ICRS/IPRL-Electronics-Hardware/PCBs/Power_V2_secondary/Power_V2_secondary.step

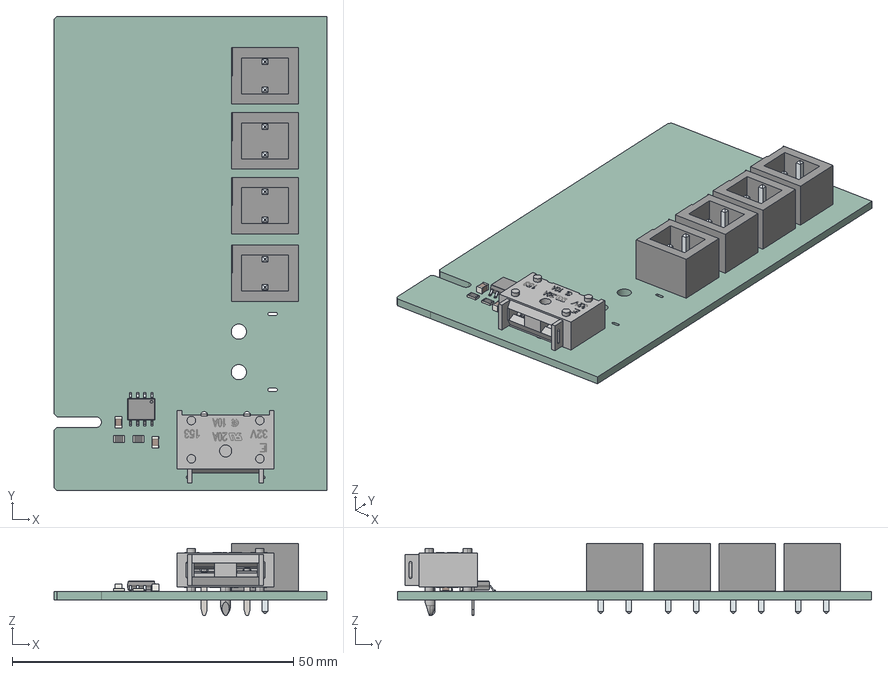
[picture p1: CAD file, 2025-04-23]
PCBs/Power_V2_secondary/Power_V2_secondary.step
48.5 x 84.3 x 12.9 mm
R_0805_2012Metric x 2
01530007Z
PinsArrayLR
LeadsArray x 4
C_0805_2012Metric x 2
Power_V2_secondary_PCB
