ICRS/IPRL-Electronics-Hardware/PCBs/Power_PCB/Power_PCB/TODO.md

- [ ] Connectors
    - Drill
        - XT30 5V in (male)
        + Put in a screw terminal
    - Arm
        - XT30 5V in (male)
        - XT60 12V in (male)
        + Put in one screw terminals
    - Comms
        - Screw terminals (x2)
    - Drive
        - XT60 12V in (female)
        - XT30 5V in (female)
        + screw terminal
- [ ] Emergency stop
- [x] ADC with potential divider
- [x] ESP32
- [ ] Over current
- [ ] Over voltage
- [ ] Reverse polarity
- [ ] Layout
- [ ] footprints
  - [ ] inductor
  - [ ] caps 0603
  - [ ] res 0805
