ICRS/IPRL-Electronics-Hardware/PCBs/Schematic_IPRL-motherboard_2025-11-26.pdf

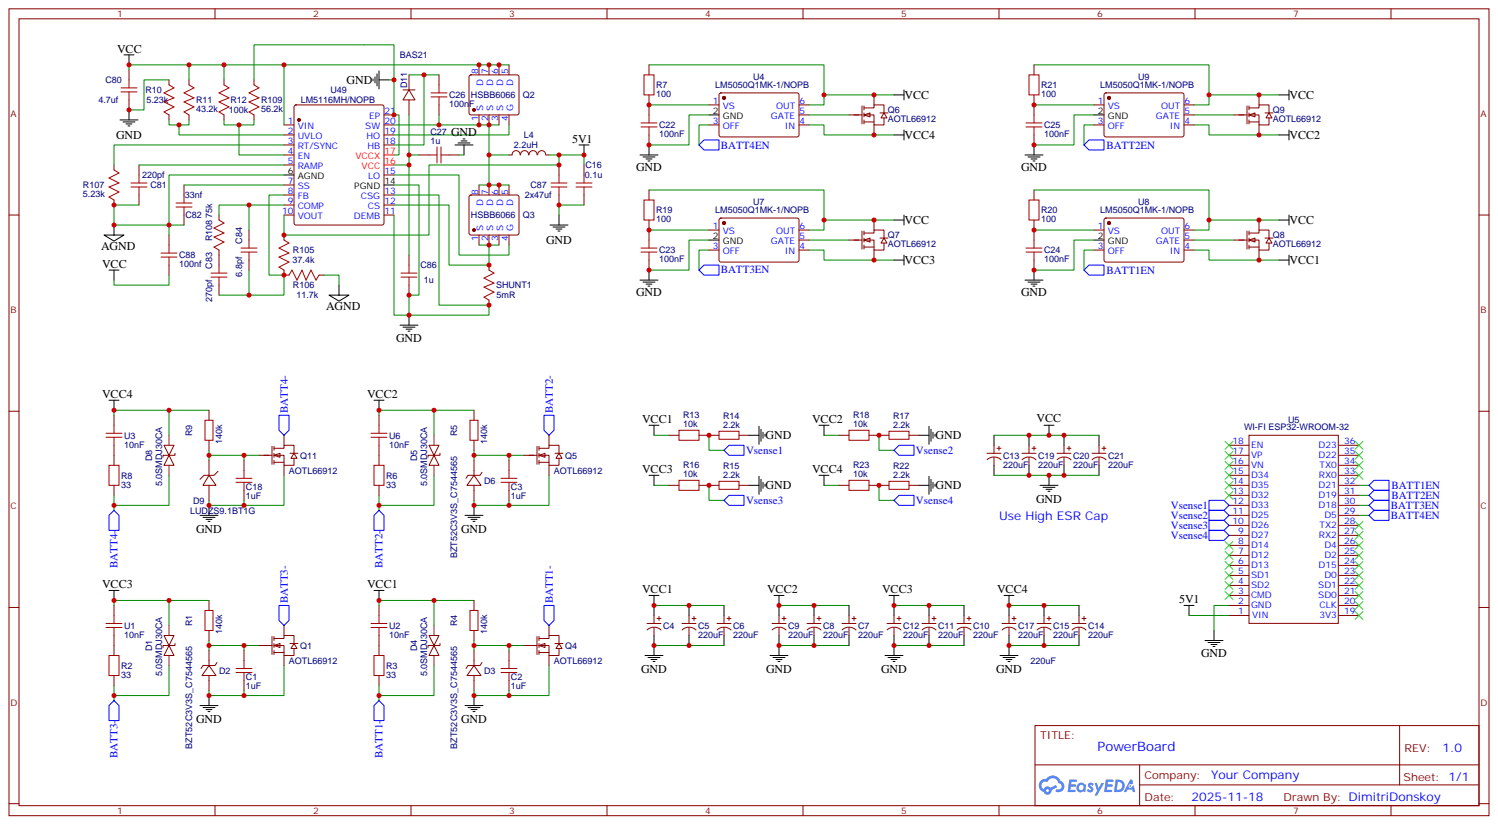
[picture p6: page 1]
