ICRS/IPRL-Electronics-Hardware/PCBs/Arm_Board_v3/Arm_Board_v3.kicad_pcb

## KiCad design PCBs/Arm_Board_v3/Arm_Board_v3.kicad_pcb (2026-02-05)

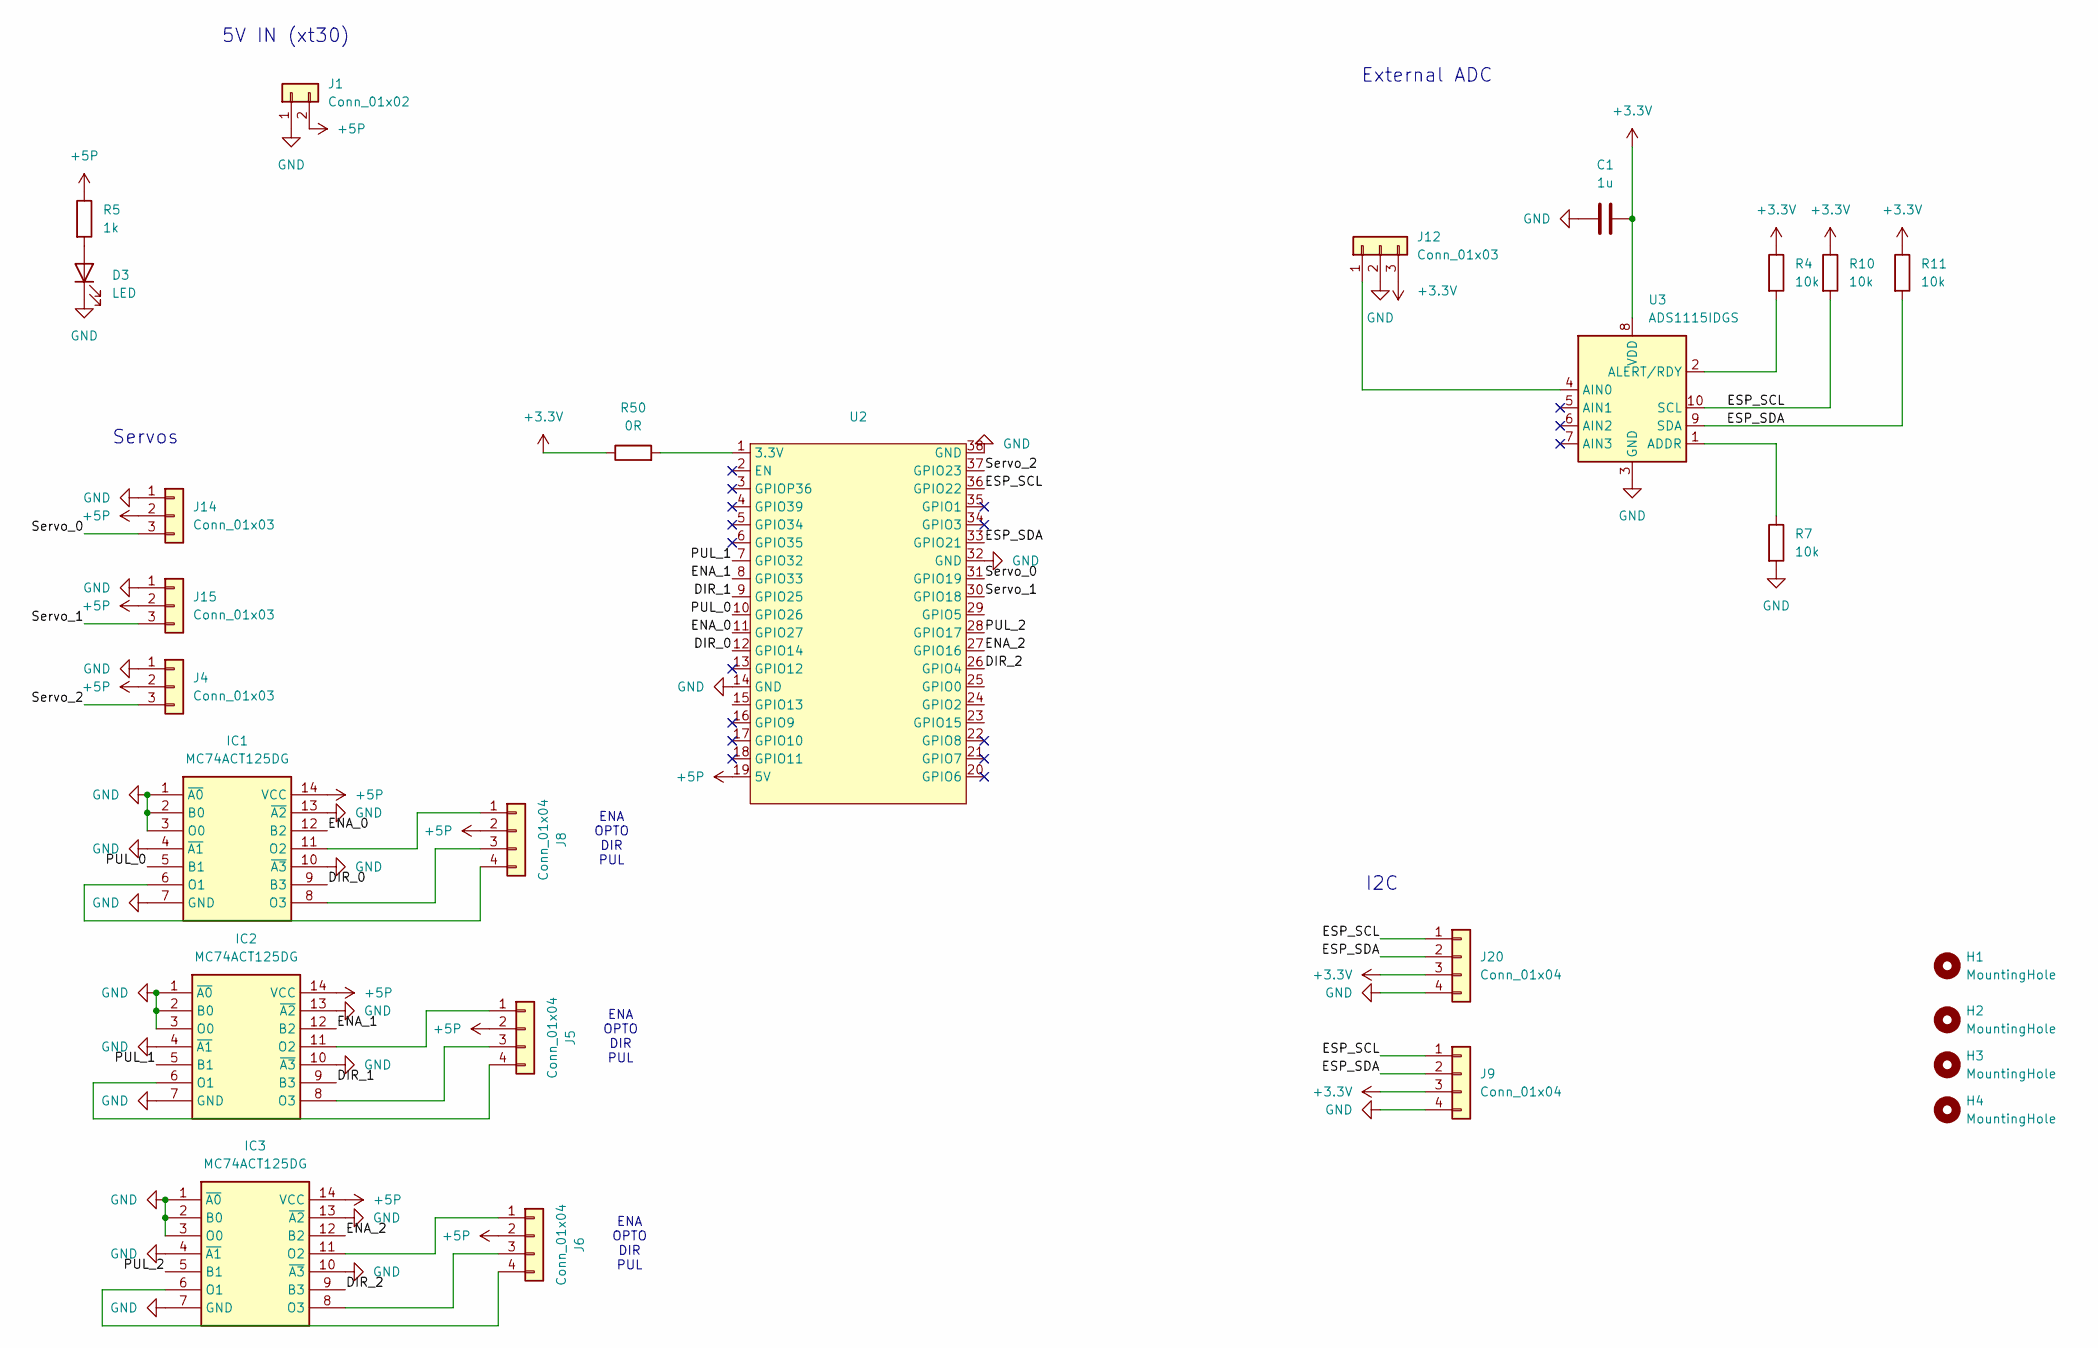
[picture p7: schematic Arm_Board_v3.kicad_sch]

Parts:
C1: 1u; C_0805_2012Metric
D3: LED; LED_0805_2012Metric
H1, H2, H3, H4: MountingHole; MountingHole_3.2mm_M3_Pad_TopBottom
IC1, IC2, IC3: MC74ACT125DG; SOIC127P600X175-14N; Manufacturer_Part_Number MC74ACT125DG; Mouser Part Number 863-MC74ACT125DG
J1: Conn_01x02; AMASS_XT30PW-M_1x02_P2.50mm_Horizontal
J4, J12, J14, J15: Conn_01x03; Molex_Micro-Fit_3.0_43045-0400_2x02_P3.00mm_Horizontal
J5, J6, J8, J9, J20: Conn_01x04; Molex_Micro-Fit_3.0_43045-0400_2x02_P3.00mm_Horizontal
R4, R7, R10, R11: 10k; R_0805_2012Metric
R5: 1k; R_0805_2012Metric
R50: 0R; R_0805_2012Metric
U2: Z_ESP32_DevKitC_38pin_socket
U3: ADS1115IDGS; TSSOP-10_3x3mm_P0.5mm

Connections:
+3.3V: C1.2, J9.3, J12.3, J20.3, R4.1, R10.1, R11.1, R50.1, U3.8 (VDD)
+5P: IC1.14 (VCC), IC2.14 (VCC), IC3.14 (VCC), J1.2, J4.2, J5.2, J6.2, J8.2, J14.2, J15.2, R5.1, U2.19 (5V)
/DIR_0: IC1.9 (B3), U2.12 (GPIO14)
/DIR_1: IC2.9 (B3), U2.9 (GPIO25)
/DIR_2: IC3.9 (B3), U2.26 (GPIO4)
/ENA_0: IC1.12 (B2), U2.11 (GPIO27)
/ENA_1: IC2.12 (B2), U2.8 (GPIO33)
/ENA_2: IC3.12 (B2), U2.27 (GPIO16)
/ESP_SCL: J9.1, J20.1, R10.2, U2.36 (GPIO22), U3.10 (SCL)
/ESP_SDA: J9.2, J20.2, R11.2, U2.33 (GPIO21), U3.9 (SDA)
/PUL_0: IC1.5 (B1), U2.10 (GPIO26)
/PUL_1: IC2.5 (B1), U2.7 (GPIO32)
/PUL_2: IC3.5 (B1), U2.28 (GPIO17)
/Servo_0: J14.3, U2.31 (GPIO19)
/Servo_1: J15.3, U2.30 (GPIO18)
/Servo_2: J4.3, U2.37 (GPIO23)
GND: C1.1, D3.1 (K), IC1.1 (~A0), IC1.2 (B0), IC1.3 (O0), IC1.4 (~A1), IC1.7 (GND), IC1.10 (~A3), IC1.13 (~A2), IC2.1 (~A0), IC2.2 (B0), IC2.3 (O0), IC2.4 (~A1), IC2.7 (GND), IC2.10 (~A3), IC2.13 (~A2), IC3.1 (~A0), IC3.2 (B0), IC3.3 (O0), IC3.4 (~A1), IC3.7 (GND), IC3.10 (~A3), IC3.13 (~A2), J1.1, J4.1, J9.4, J12.2, J14.1, J15.1, J20.4, R7.2, U2.14 (GND), U2.32 (GND), U2.38 (GND), U3.3 (GND)
unnamed: D3.2 (A), R5.2
unnamed: IC1.6 (O1), J8.4
unnamed: IC1.11 (O2), J8.1
unnamed: IC1.8 (O3), J8.3
unnamed: IC2.6 (O1), J5.4
unnamed: IC2.11 (O2), J5.1
unnamed: IC2.8 (O3), J5.3
unnamed: IC3.6 (O1), J6.4
unnamed: IC3.11 (O2), J6.1
unnamed: IC3.8 (O3), J6.3
unnamed: J12.1, U3.4 (AIN0)
unnamed: R50.2, U2.1 (3.3V)
unnamed: R7.1, U3.1 (ADDR)
unnamed: R4.2, U3.2 (ALERT/RDY)

Notes on the sheet:
5V IN (xt30)
ENA OPTO DIR PUL
External ADC
I2C
Servos

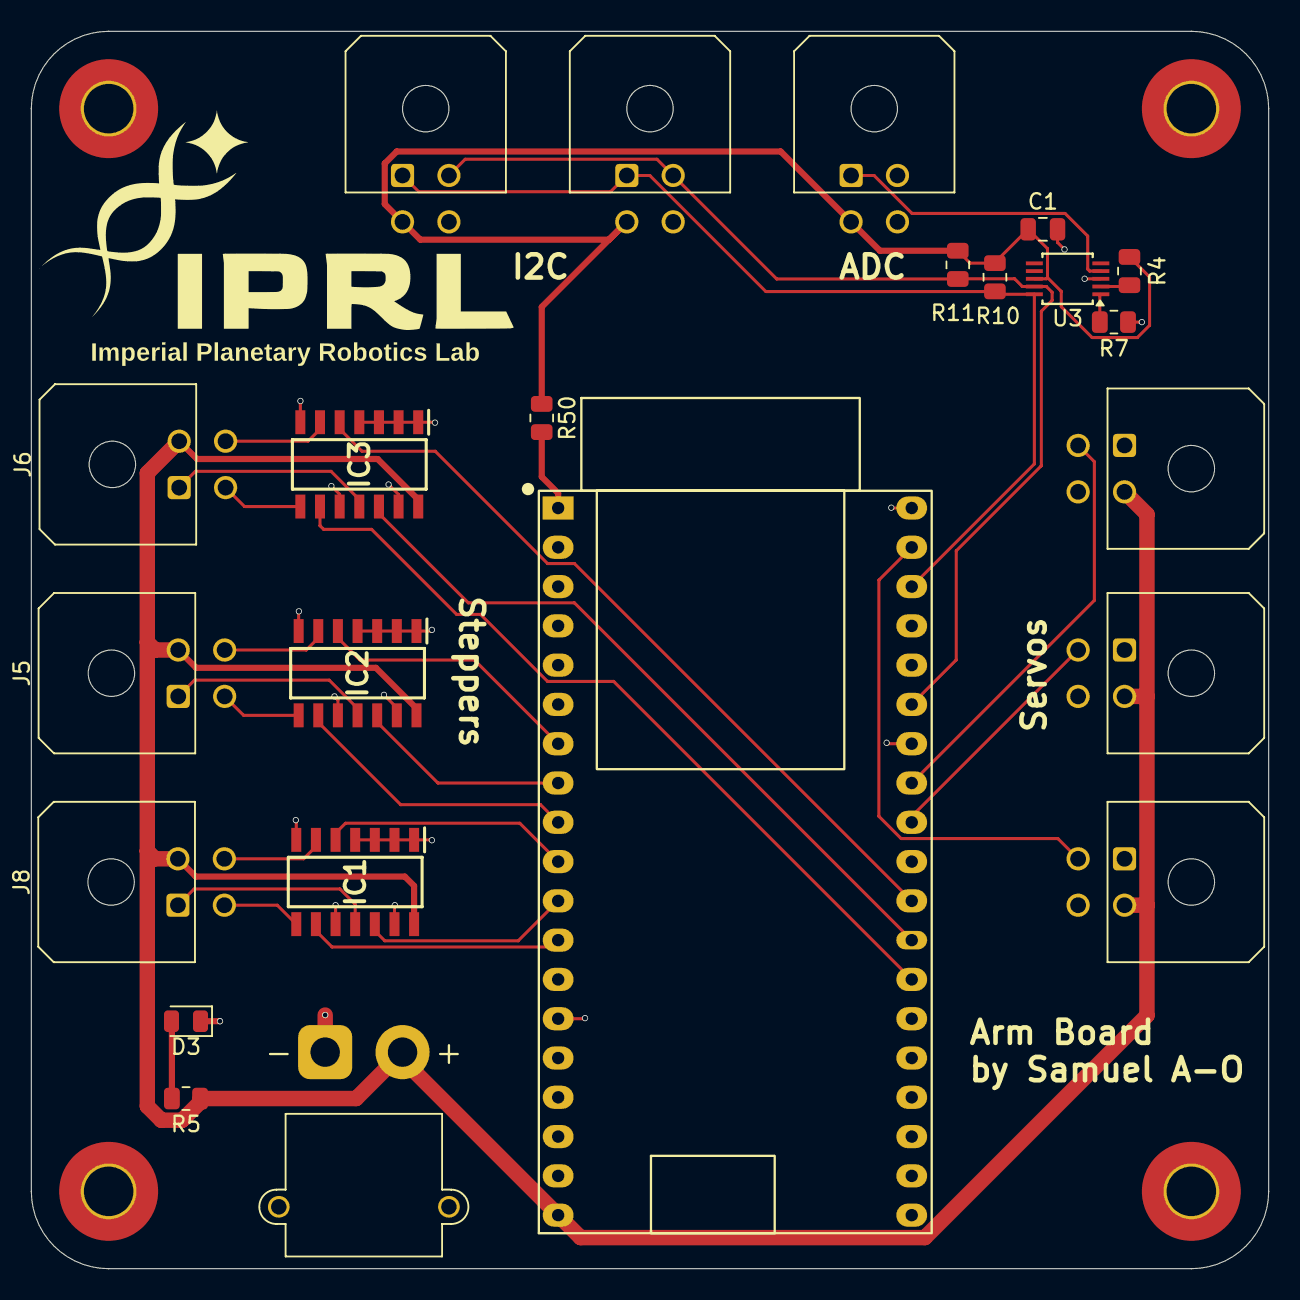
[picture p8: board Arm_Board_v3.kicad_pcb from above]

Board: 2 copper layers, 80.0 x 80.0 mm, 27 parts (0 on the bottom side), 31 nets.
