ICRS/IPRL-Electronics-Hardware/PCBs/Drive board V6/iprld.kicad_pcb

## KiCad design PCBs/Drive board V6/iprld.kicad_pcb (2026-02-05)

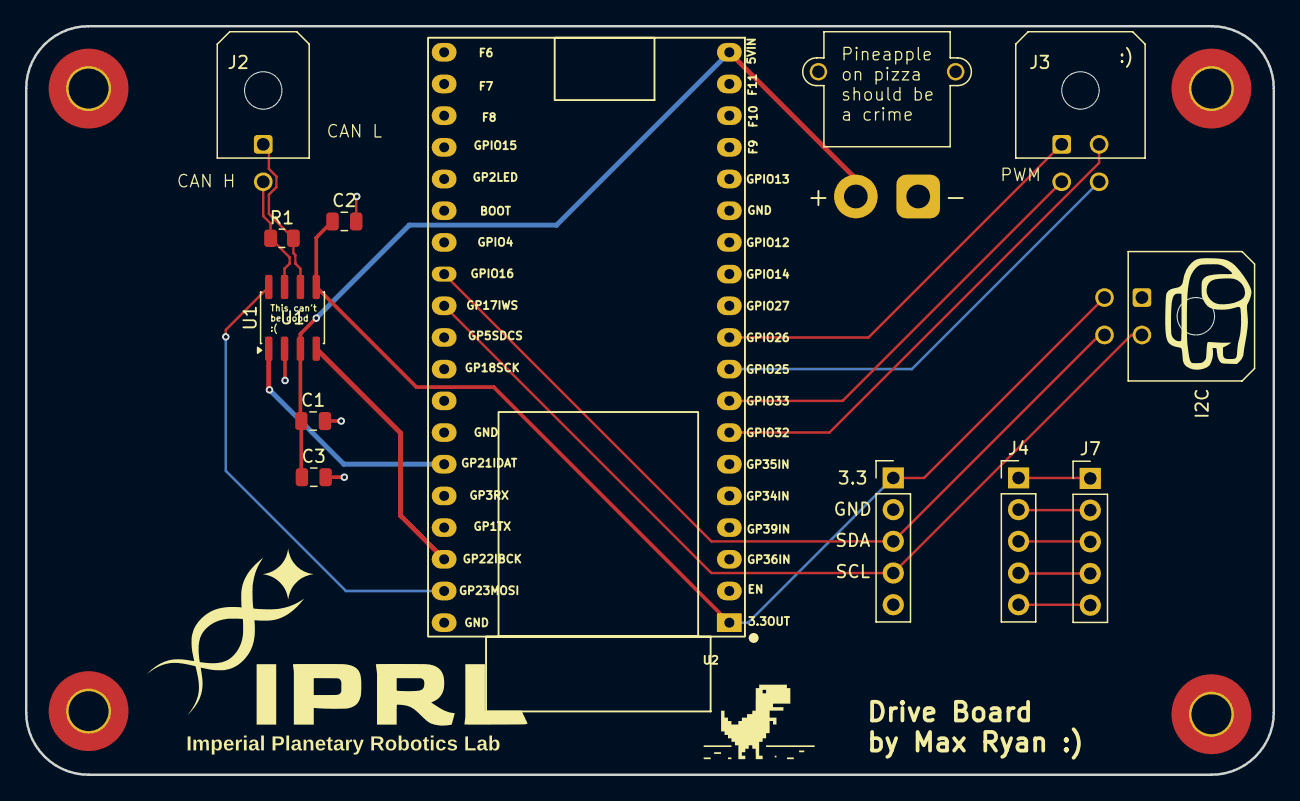
[picture p9: board iprld.kicad_pcb from above]

Board: 2 copper layers, 100.0 x 60.0 mm, 17 parts (0 on the bottom side), 19 nets.

Parts:
3.3: Conn_01x05; PinHeader_1x05_P2.54mm_Vertical
C1: 1u; C_0805_2012Metric
C2, C3: 0.1u; C_0805_2012Metric
H1, H2, H3, H4: MountingHole; MountingHole_3.2mm_M3_Pad_TopBottom
I2C: Conn_02x02_Top_Bottom; Molex_Micro-Fit_3.0_43045-0400_2x02_P3.00mm_Horizontal
J1: Conn_01x02; AMASS_XT30PW-M_1x02_P2.50mm_Horizontal
J2: Conn_02x01; Molex_Micro-Fit_3.0_43045-0200_2x01_P3.00mm_Horizontal
J3: Conn_02x02_Top_Bottom; Molex_Micro-Fit_3.0_43045-0400_2x02_P3.00mm_Horizontal
J4, J7: Conn_01x05; PinHeader_1x05_P2.54mm_Vertical
R1: 120; R_0805_2012Metric
U1: TJA1051T-3; SOIC-8_3.9x4.9mm_P1.27mm
U2: Z_ESP32_DevKitC_38pin_socket

Connections:
+3.3V: 3.3.1, C2.1, I2C.3, U1.5 (VIO), U2.1 (3.3V)
+5V: C1.1, C3.1, J1.2, U1.3 (VCC), U2.19 (5V)
/CAN_N: J2.1, R1.2, U1.6 (CANL)
/CAN_P: J2.2, R1.1, U1.7 (CANH)
/CAN_RX: U1.4 (RXD), U2.36 (GPIO22)
/CAN_S: U1.8 (S), U2.37 (GPIO23)
/CAN_TX: U1.1 (TXD), U2.33 (GPIO21)
/M1: J3.1, U2.10 (GPIO26)
/M2: J3.2, U2.7 (GPIO32)
/M3: J3.3, U2.8 (GPIO33)
/M4: J3.4, U2.9 (GPIO25)
/SCL: 3.3.4, I2C.2, U2.28 (GPIO17)
/SDA: 3.3.3, I2C.4, U2.27 (GPIO16)
GND: 3.3.2, C1.2, C2.2, C3.2, I2C.1, J1.1, U1.2 (GND), U2.14 (GND), U2.32 (GND), U2.38 (GND)
unnamed: J4.1, J7.1
unnamed: J4.2, J7.2
unnamed: J4.3, J7.3
unnamed: J4.4, J7.4
unnamed: J4.5, J7.5
