ICRS/IPRL-Electronics-Hardware/PCBs/DRILLTEAM/DRILLTEAMYMchanges.kicad_pcb

## KiCad design PCBs/DRILLTEAM/DRILLTEAMYMchanges.kicad_pcb (2026-01-29)

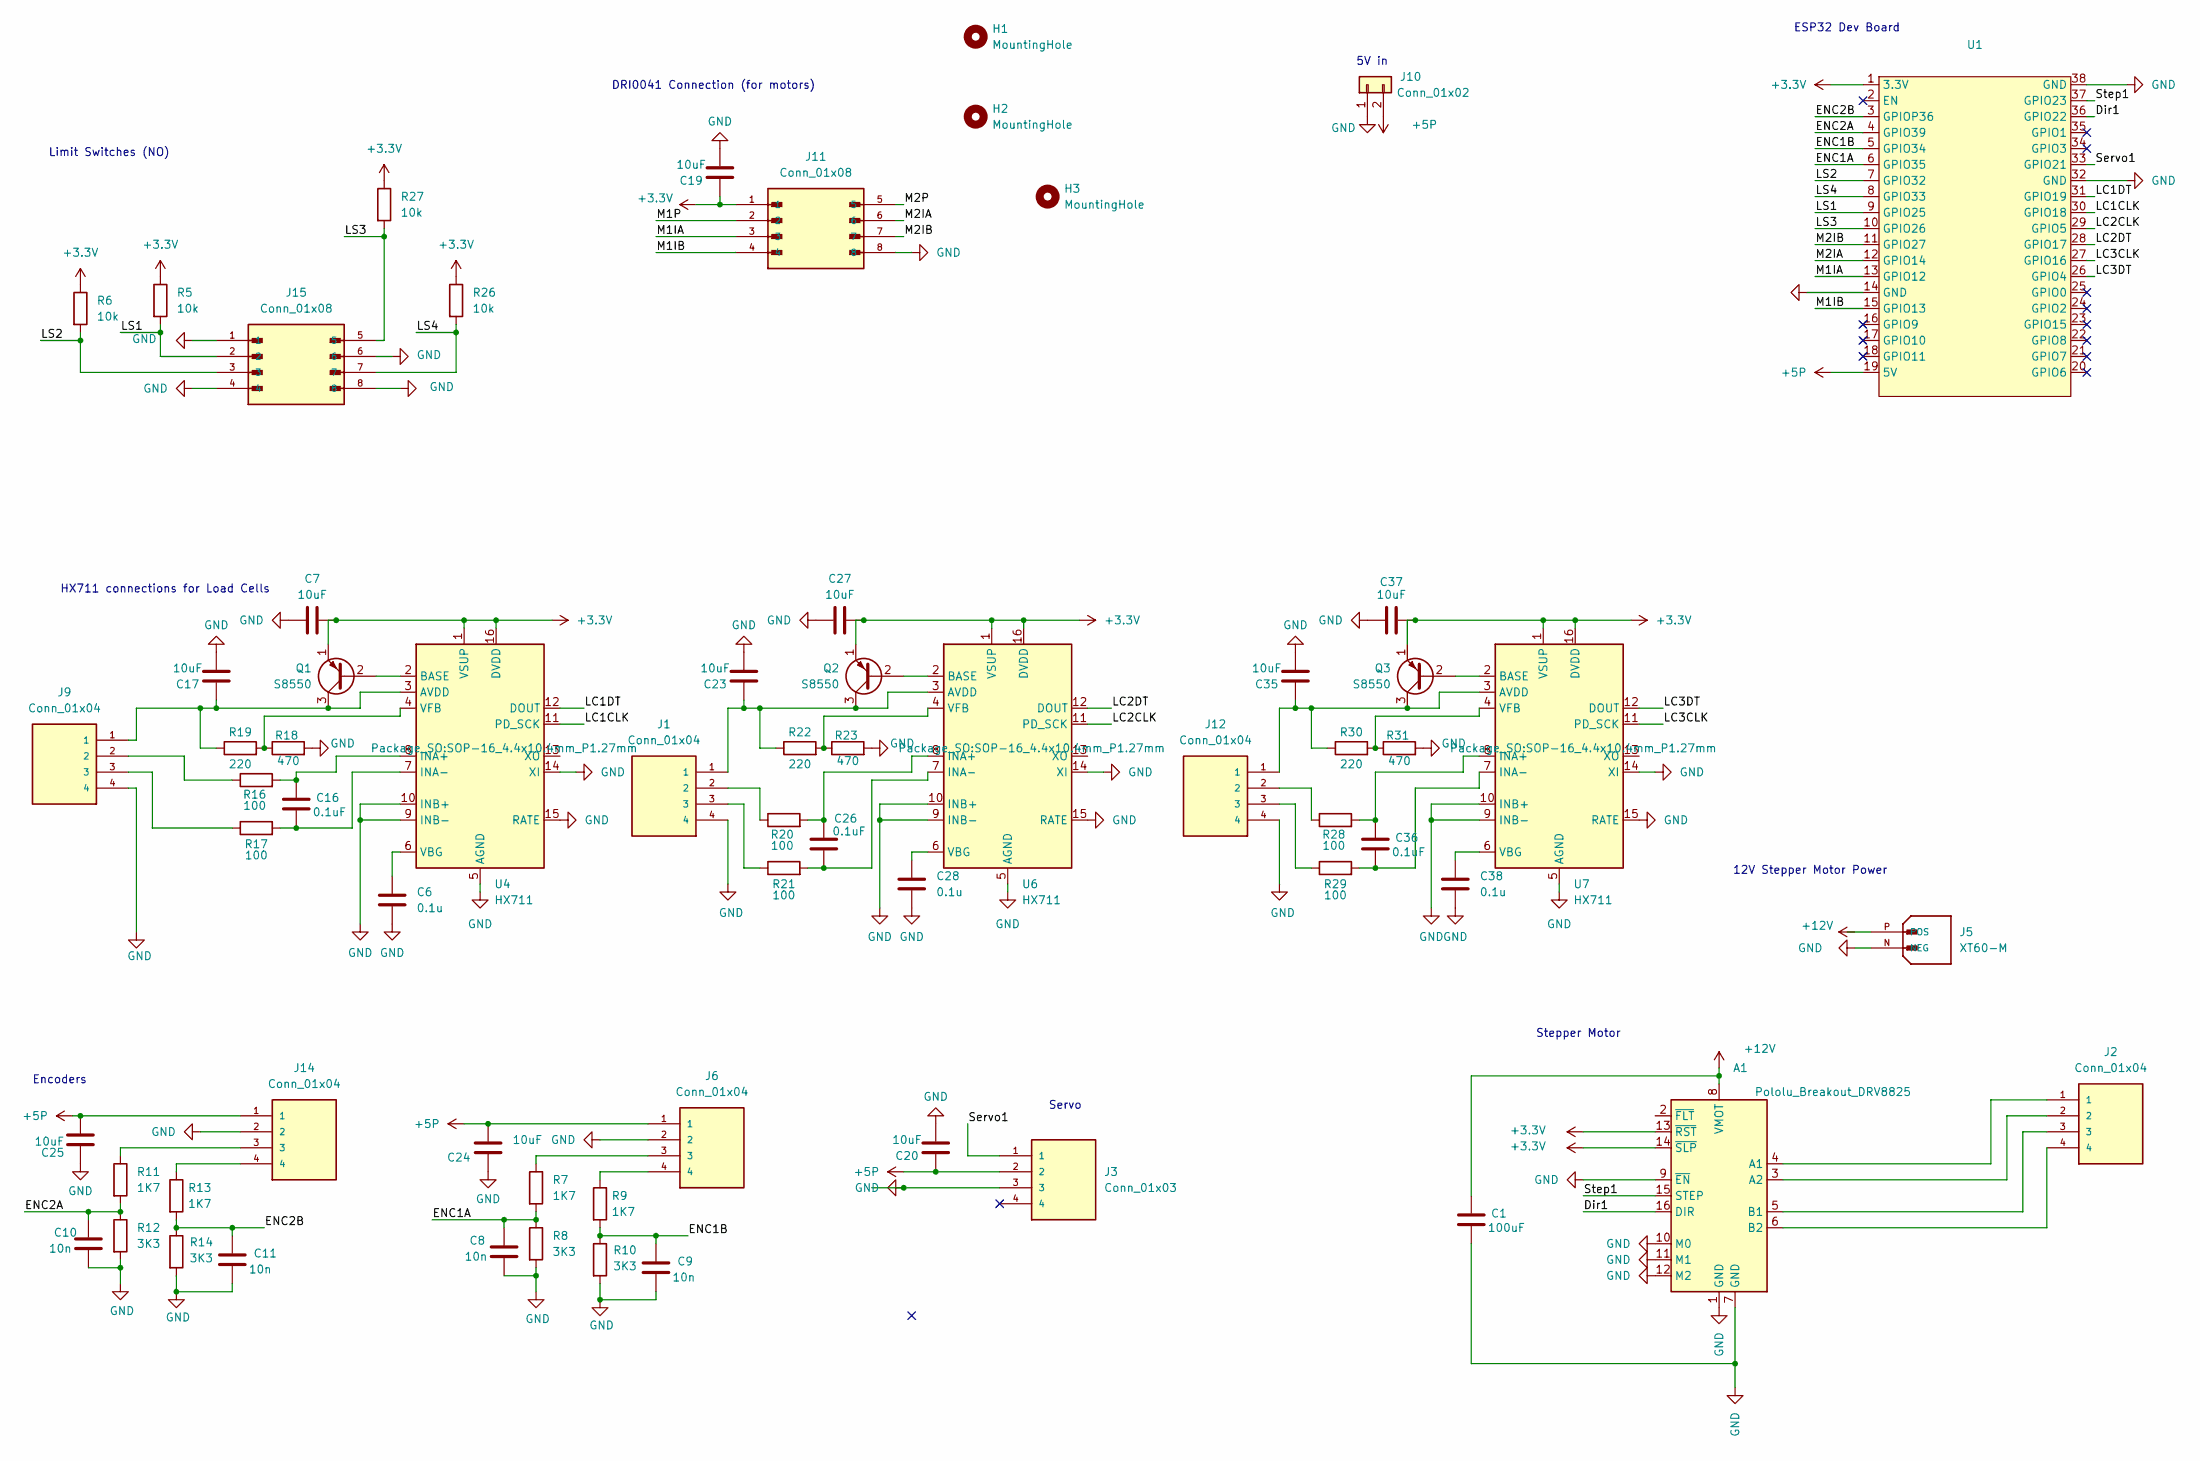
[picture p10: schematic DRILLTEAMYMchanges.kicad_sch]

Parts:
A1: Pololu_Breakout_DRV8825; Pololu_Breakout-16_15.2x20.3mm
C1: 100uF; C_0805_2012Metric
C6, C28, C38: 0.1u; C_0805_2012Metric
C7, C17, C19, C20, C23, C24, C25, C27, C35, C37: 10uF; C_0805_2012Metric
C8, C9, C10, C11: 10n; C_0805_2012Metric
C16, C26, C36: 0.1uF; C_0805_2012Metric
H1, H2, H3: MountingHole; MountingHole_3.2mm_M3
J1, J12: Conn_01x04; MOLEX_430450400; PARTREV D7
J2, J6, J9, J14: Conn_01x04; MOLEX_430450400; PARTREV G
J3: Conn_01x03; MOLEX_430450400; PARTREV G
J5: XT60-M; AMASS_XT60-M; PARTREV V1.2
J10: Conn_01x02; AMASS_XT30PW-M_1x02_P2.50mm_Horizontal
J11, J15: Conn_01x08; MOLEX_430450800; PARTREV G
Q1, Q2, Q3: S8550; TO-92_Inline
R5, R6, R26, R27: 10k; R_0805_2012Metric
R7, R9, R11, R13: 1K7; R_0805_2012Metric
R8, R10, R12, R14: 3K3; R_0805_2012Metric
R16, R17, R20, R21, R28, R29: 100; R_0805_2012Metric
R18, R23, R31: 470; R_0805_2012Metric
R19, R22, R30: 220; R_0805_2012Metric
U1: Z_ESP32_DevKitC_38pin_socket
U4, U6, U7: HX711; SOP-16_4.4x10.4mm_P1.27mm

Connections:
+3.3V: A1.13 (~RST), A1.14 (~SLP), C7.2, C19.2, C27.2, C37.2, J11.1, Q1.1 (E), Q2.1 (E), Q3.1 (E), R5.1, R6.1, R26.1, R27.1, U1.1 (3.3V), U4.1 (VSUP), U4.16 (DVDD), U6.1 (VSUP), U6.16 (DVDD), U7.1 (VSUP), U7.16 (DVDD)
+5P: C20.2, C24.2, C25.2, J3.2, J6.1, J10.2, J14.1, U1.19 (5V)
+12V: A1.8 (VMOT), C1.1, J5.P (POS)
/Dir1: A1.16 (DIR), U1.36 (GPIO22)
/ENC1A: C8.1, R7.2, R8.1, U1.6 (GPIO35)
/ENC1B: C9.1, R9.2, R10.1, U1.5 (GPIO34)
/ENC2A: C10.1, R11.2, R12.1, U1.4 (GPIO39)
/ENC2B: C11.1, R13.2, R14.1, U1.3 (GPIOP36)
/LC1CLK: U1.30 (GPIO18), U4.11 (PD_SCK)
/LC1DT: U1.31 (GPIO19), U4.12 (DOUT)
/LC2CLK: U1.29 (GPIO5), U6.11 (PD_SCK)
/LC2DT: U1.28 (GPIO17), U6.12 (DOUT)
/LC3CLK: U1.27 (GPIO16), U7.11 (PD_SCK)
/LC3DT: U1.26 (GPIO4), U7.12 (DOUT)
/LS1: J15.2, R5.2, U1.9 (GPIO25)
/LS2: J15.3, R6.2, U1.7 (GPIO32)
/LS3: J15.5, R27.2, U1.10 (GPIO26)
/LS4: J15.7, R26.2, U1.8 (GPIO33)
/M1IA: J11.3, U1.13 (GPIO12)
/M1IB: J11.4, U1.15 (GPIO13)
/M1P: J11.2
/M2IA: J11.6, U1.12 (GPIO14)
/M2IB: J11.7, U1.11 (GPIO27)
/M2P: J11.5
/Servo1: J3.1, U1.33 (GPIO21)
/Step1: A1.15 (STEP), U1.37 (GPIO23)
GND: A1.1 (GND), A1.7 (GND), A1.9 (~EN), A1.10 (M0), A1.11 (M1), A1.12 (M2), C1.2, C6.2, C7.1, C8.2, C9.2, C10.2, C11.2, C17.1, C19.1, C20.1, C23.1, C24.1, C25.1, C27.1, C28.2, C35.1, C37.1, C38.2, J1.4, J3.3, J5.N (NEG), J6.2, J9.4, J10.1, J11.8, J12.4, J14.2, J15.1, J15.4, J15.6, J15.8, R8.2, R10.2, R12.2, R14.2, R18.2, R23.2, R31.2, U1.14 (GND), U1.32 (GND), U1.38 (GND), U4.5 (AGND), U4.9 (INB-), U4.10 (INB+), U4.14 (XI), U4.15 (RATE), U6.5 (AGND), U6.9 (INB-), U6.10 (INB+), U6.14 (XI), U6.15 (RATE), U7.5 (AGND), U7.9 (INB-), U7.10 (INB+), U7.14 (XI), U7.15 (RATE)
unnamed: A1.4 (A1), J2.1
unnamed: A1.3 (A2), J2.2
unnamed: A1.5 (B1), J2.3
unnamed: A1.6 (B2), J2.4
unnamed: J1.2, R20.1
unnamed: J1.3, R21.1
unnamed: J6.3, R7.1
unnamed: J6.4, R9.1
unnamed: J9.2, R16.1
unnamed: J9.3, R17.1
unnamed: J12.2, R28.1
unnamed: J12.3, R29.1
unnamed: J14.3, R11.1
unnamed: J14.4, R13.1
unnamed: Q1.2 (B), U4.2 (BASE)
unnamed: C17.2, J9.1, Q1.3 (C), R19.1, U4.3 (AVDD)
unnamed: Q2.2 (B), U6.2 (BASE)
unnamed: C23.2, J1.1, Q2.3 (C), R22.1, U6.3 (AVDD)
unnamed: Q3.2 (B), U7.2 (BASE)
unnamed: C35.2, J12.1, Q3.3 (C), R30.1, U7.3 (AVDD)
unnamed: C16.1, R16.2, U4.8 (INA+)
unnamed: C16.2, R17.2, U4.7 (INA-)
unnamed: C6.1, U4.6 (VBG)
unnamed: R18.1, R19.2, U4.4 (VFB)
unnamed: C26.1, R20.2, U6.8 (INA+)
unnamed: C26.2, R21.2, U6.7 (INA-)
unnamed: C28.1, U6.6 (VBG)
unnamed: R22.2, R23.1, U6.4 (VFB)
unnamed: C36.1, R28.2, U7.8 (INA+)
unnamed: C36.2, R29.2, U7.7 (INA-)
unnamed: C38.1, U7.6 (VBG)
unnamed: R30.2, R31.1, U7.4 (VFB)

Notes on the sheet:
DRI0041 Connection (for motors)
Servo
Encoders
5V in
Limit Switches (NO)
ESP32 Dev Board
Stepper Motor
HX711 connections for Load Cells
12V Stepper Motor Power

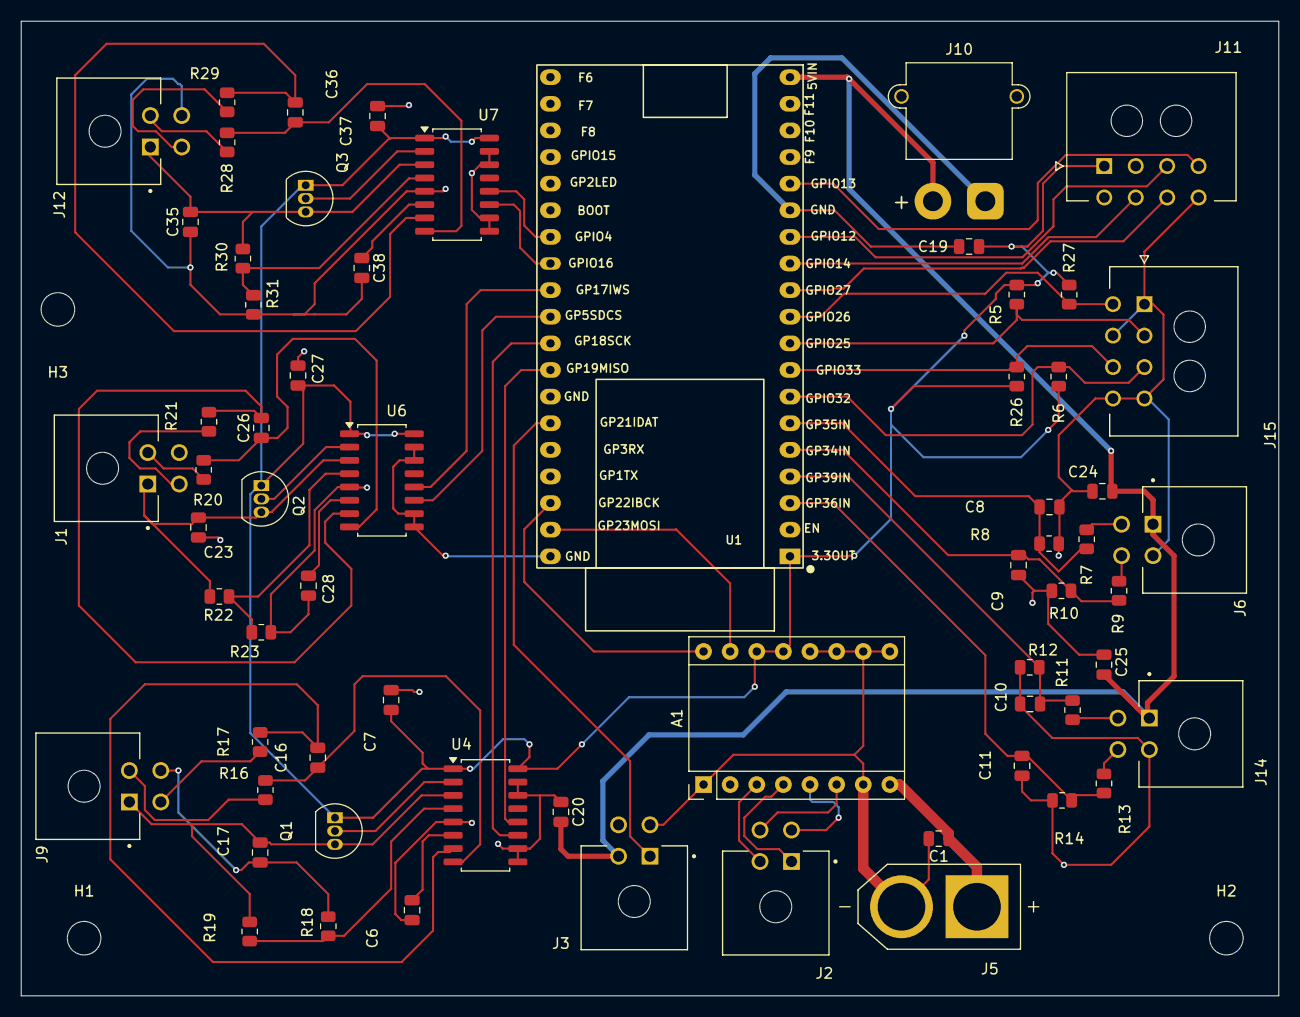
[picture p11: board DRILLTEAMYMchanges.kicad_pcb from above]

Board: 2 copper layers, 120.0 x 93.0 mm, 67 parts (0 on the bottom side), 57 nets.
