ICRS/IPRL-Electronics-Hardware/PCBs/Drive_breakout_connector/Drive_breakout_connector/Drive_breakout_connector.kicad_pcb

## KiCad design PCBs/Drive_breakout_connector/Drive_breakout_connector/Drive_breakout_connector.kicad_pcb (2025-07-08)

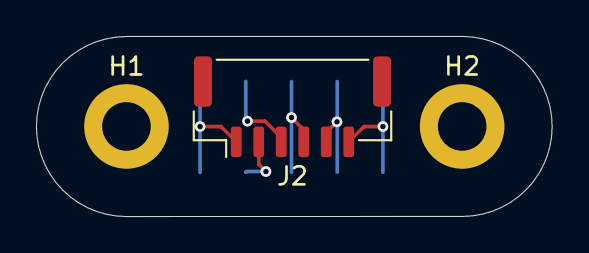
[picture p12: board Drive_breakout_connector.kicad_pcb from above]

Board: 2 copper layers, 28.7 x 10.0 mm, 4 parts (1 on the bottom side), 6 nets.

Parts:
H1, H2: MountingHole; MountingHole_2.7mm_M2.5_DIN965_Pad
J1: Socket; PinSocket_2x05_P2.54mm_Vertical_SMD
J2: JST_GH Input; JST_GH_BM06B-GHS-TBT_1x06-1MP_P1.25mm_Vertical

Connections:
/ENA: J1.4, J2.3
/ENB: J1.3, J2.2
/IN1: J1.5, J1.6, J2.4
/IN2: J1.7, J1.8, J2.5
GND: J1.9, J1.10, J2.6
VCC: J1.1, J1.2, J2.1
