ICRS/IPRL-Electronics-Hardware/PCBs/Arm Schematic V2/Arm Schematic V2/Arm Schematic V2.kicad_pcb

## KiCad design PCBs/Arm Schematic V2/Arm Schematic V2/Arm Schematic V2.kicad_pcb (2025-07-08)

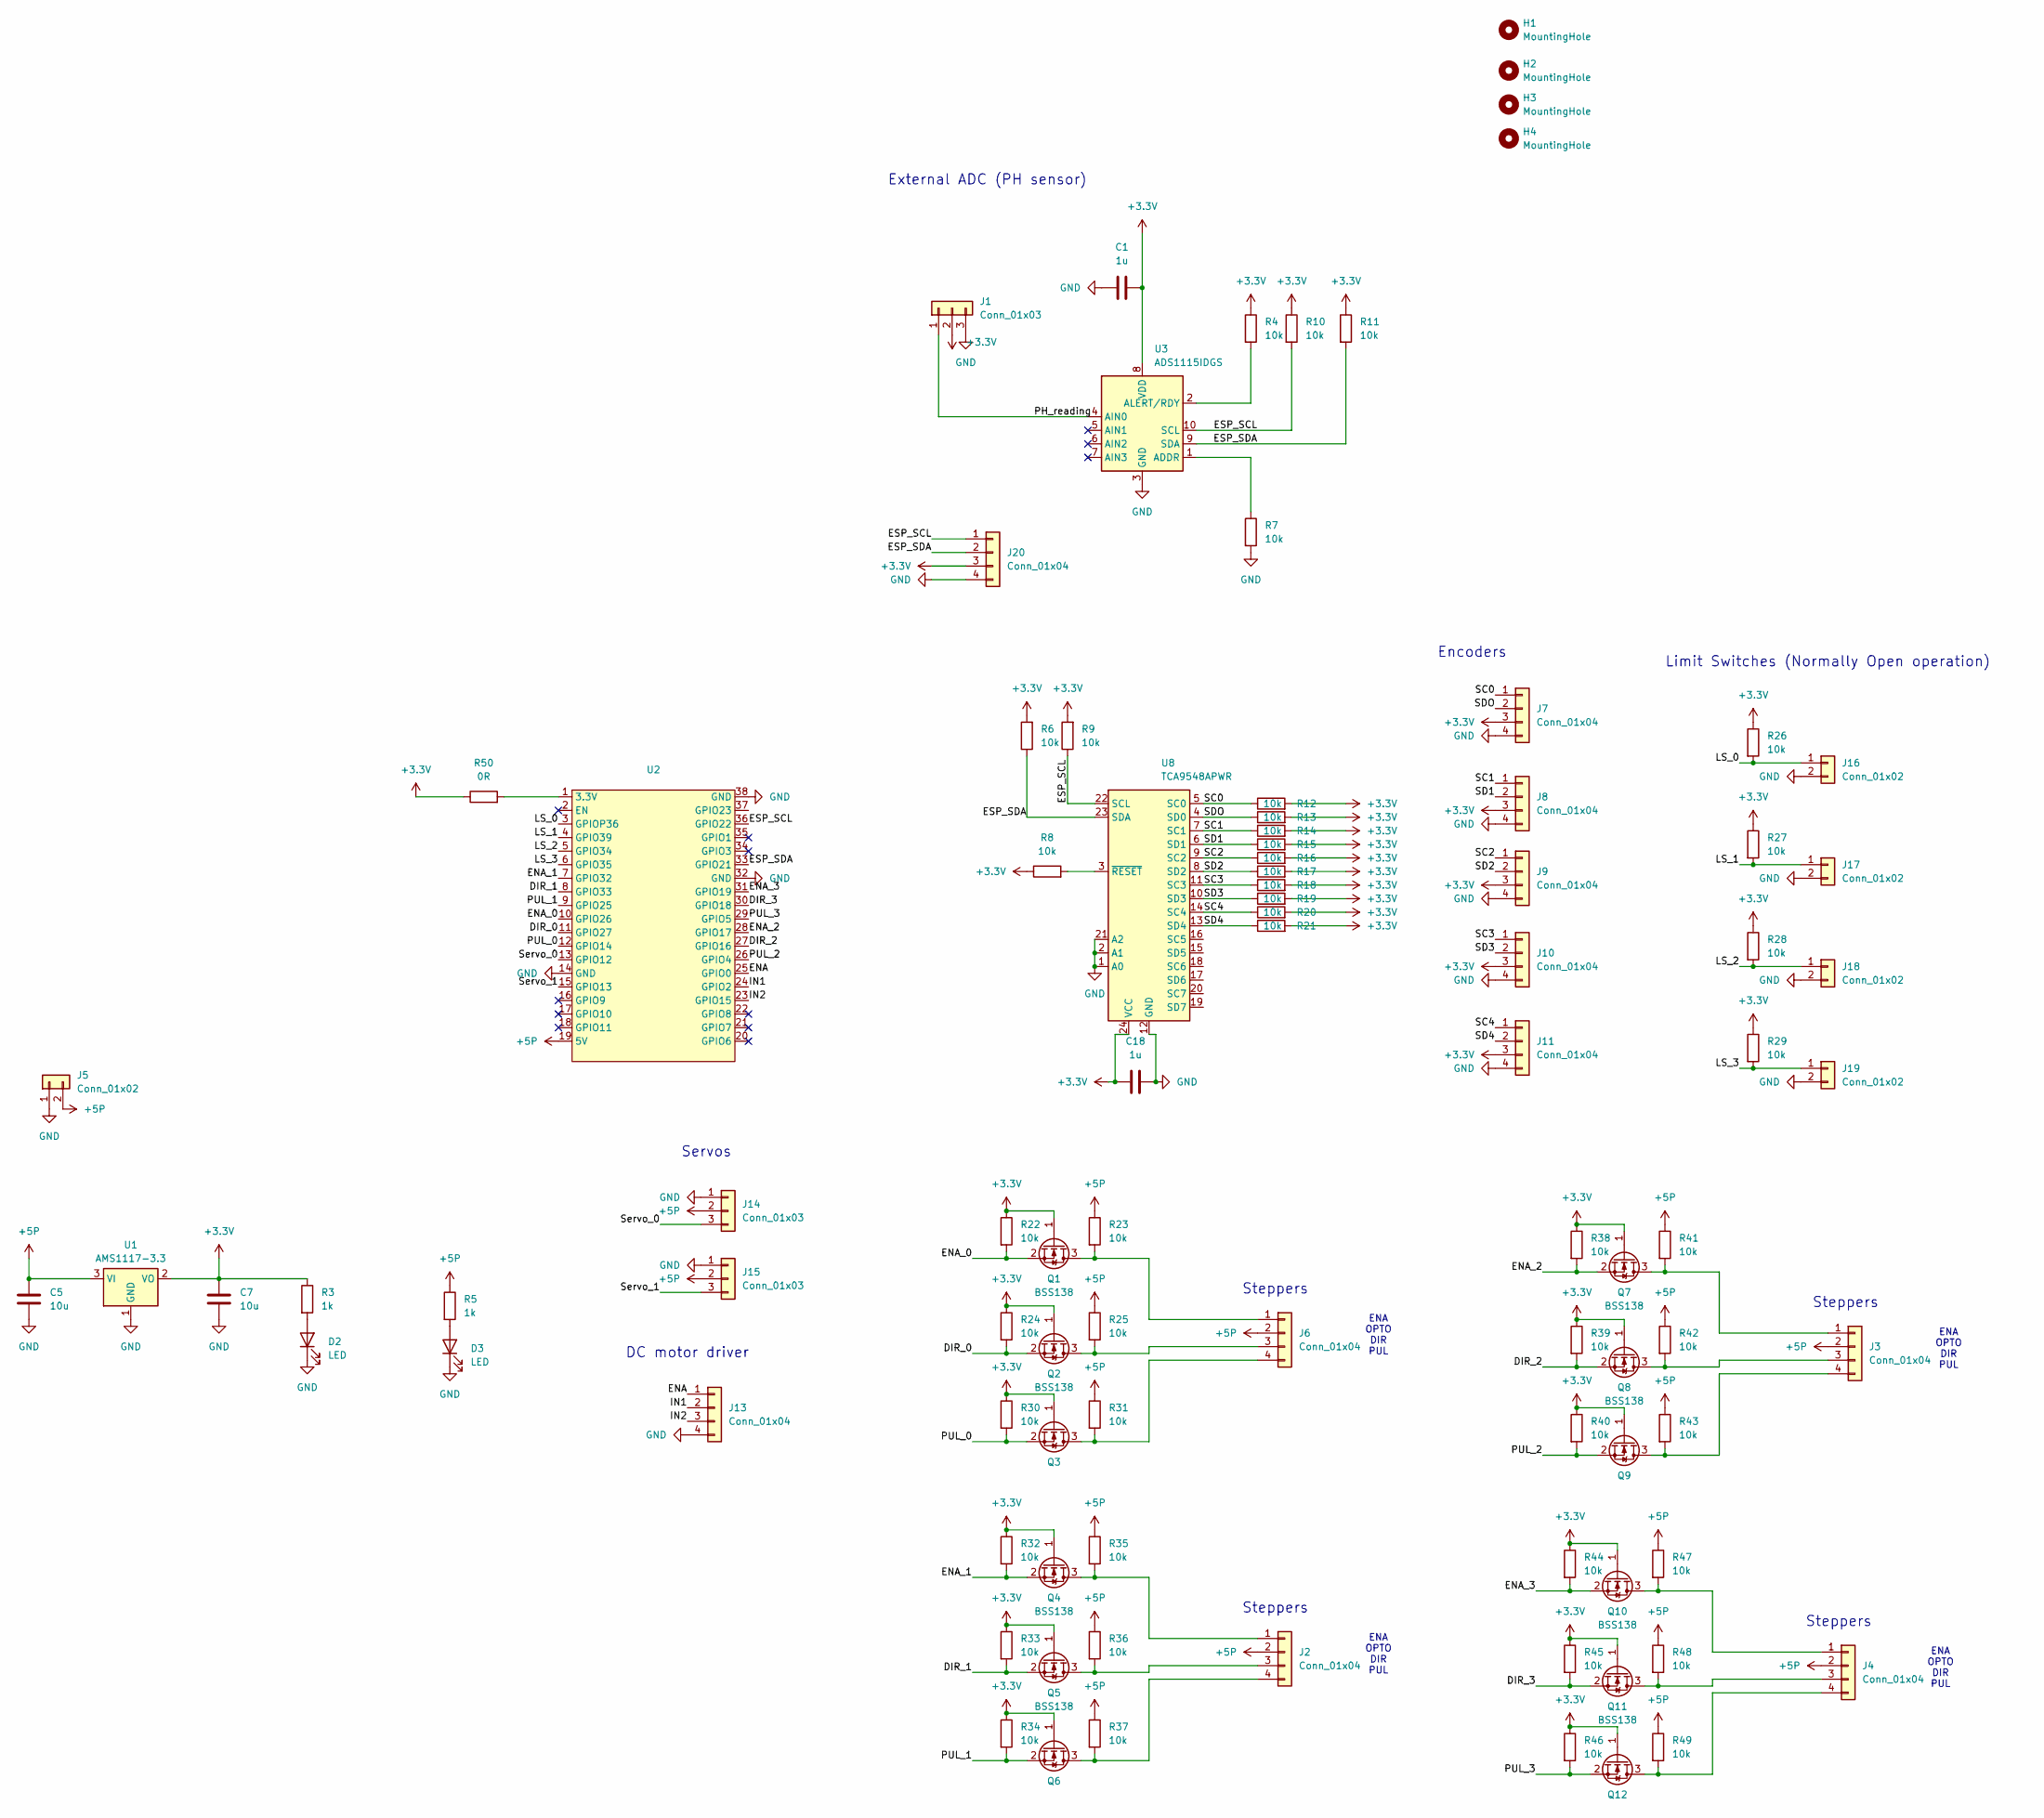
[picture p13: schematic Arm Schematic V2.kicad_sch]

Parts:
C1, C18: 1u; C_0805_2012Metric
C5, C7: 10u; C_0805_2012Metric
D2, D3: LED; LED_0805_2012Metric
H1, H2, H3, H4: MountingHole; MountingHole_3.2mm_M3_Pad_TopBottom
J1, J14, J15: Conn_01x03; JST_GH_BM03B-GHS-TBT_1x03-1MP_P1.25mm_Vertical
J2, J3, J4, J6, J7, J8, J9, J10, J11, J13, J20: Conn_01x04; JST_GH_BM04B-GHS-TBT_1x04-1MP_P1.25mm_Vertical
J5: Conn_01x02; AMASS_XT30PW-M_1x02_P2.50mm_Horizontal
J16, J17, J18, J19: Conn_01x02; JST_GH_BM02B-GHS-TBT_1x02-1MP_P1.25mm_Vertical
Q1, Q2, Q3, Q4, Q5, Q6, Q7, Q8, Q9, Q10, Q11, Q12: BSS138; SOT-23
R3, R5: 1k; R_0805_2012Metric
R4, R6, R7, R8, R9, R10, R11, R12, R13, R14, R15, R16, R17, R18, R19, R20, R21, R22, R23, R24, R25, R26, R27, R28, R29, R30, R31, R32, R33, R34, R35, R36, R37, R38, R39, R40, R41, R42, R43, R44, R45, R46, R47, R48, R49: 10k; R_0805_2012Metric
R50: 0R; R_0805_2012Metric
U1: AMS1117-3.3; SOT-223-3_TabPin2
U2: Z_ESP32_DevKitC_38pin_socket
U3: ADS1115IDGS; TSSOP-10_3x3mm_P0.5mm
U8: TCA9548APWR; TSSOP-24_4.4x7.8mm_P0.65mm

Connections:
+3.3V: C1.2, C7.1, C18.2, J1.2, J7.3, J8.3, J9.3, J10.3, J11.3, J20.3, Q1.1 (G), Q2.1 (G), Q3.1 (G), Q4.1 (G), Q5.1 (G), Q6.1 (G), Q7.1 (G), Q8.1 (G), Q9.1 (G), Q10.1 (G), Q11.1 (G), Q12.1 (G), R3.1, R4.1, R6.2, R8.1, R9.2, R10.1, R11.1, R12.2, R13.2, R14.2, R15.2, R16.2, R17.2, R18.2, R19.2, R20.2, R21.2, R22.1, R24.1, R26.1, R27.1, R28.1, R29.1, R30.1, R32.1, R33.1, R34.1, R38.1, R39.1, R40.1, R44.1, R45.1, R46.1, R50.1, U1.2 (VO), U3.8 (VDD), U8.24 (VCC)
+5P: C5.1, J2.2, J3.2, J4.2, J5.2, J6.2, J14.2, J15.2, R5.1, R23.1, R25.1, R31.1, R35.1, R36.1, R37.1, R41.1, R42.1, R43.1, R47.1, R48.1, R49.1, U1.3 (VI), U2.19 (5V)
/DIR_0: Q2.2 (S), R24.2, U2.11 (GPIO27)
/DIR_1: Q5.2 (S), R33.2, U2.8 (GPIO33)
/DIR_2: Q8.2 (S), R39.2, U2.27 (GPIO16)
/DIR_3: Q11.2 (S), R45.2, U2.30 (GPIO18)
/ENA: J13.1, U2.25 (GPIO0)
/ENA_0: Q1.2 (S), R22.2, U2.10 (GPIO26)
/ENA_1: Q4.2 (S), R32.2, U2.7 (GPIO32)
/ENA_2: Q7.2 (S), R38.2, U2.28 (GPIO17)
/ENA_3: Q10.2 (S), R44.2, U2.31 (GPIO19)
/ESP_SCL: J20.1, R9.1, R10.2, U2.36 (GPIO22), U3.10 (SCL), U8.22 (SCL)
/ESP_SDA: J20.2, R6.1, R11.2, U2.33 (GPIO21), U3.9 (SDA), U8.23 (SDA)
/IN1: J13.2, U2.24 (GPIO2)
/IN2: J13.3, U2.23 (GPIO15)
/LS_0: J16.1, R26.2, U2.3 (GPIOP36)
/LS_1: J17.1, R27.2, U2.4 (GPIO39)
/LS_2: J18.1, R28.2, U2.5 (GPIO34)
/LS_3: J19.1, R29.2, U2.6 (GPIO35)
/PH_reading: J1.1, U3.4 (AIN0)
/PUL_0: Q3.2 (S), R30.2, U2.12 (GPIO14)
/PUL_1: Q6.2 (S), R34.2, U2.9 (GPIO25)
/PUL_2: Q9.2 (S), R40.2, U2.26 (GPIO4)
/PUL_3: Q12.2 (S), R46.2, U2.29 (GPIO5)
/SC0: J7.1, R12.1, U8.5 (SC0)
/SC1: J8.1, R14.1, U8.7 (SC1)
/SC2: J9.1, R16.1, U8.9 (SC2)
/SC3: J10.1, R18.1, U8.11 (SC3)
/SC4: J11.1, R20.1, U8.14 (SC4)
/SD1: J8.2, R15.1, U8.6 (SD1)
/SD2: J9.2, R17.1, U8.8 (SD2)
/SD3: J10.2, R19.1, U8.10 (SD3)
/SD4: J11.2, R21.1, U8.13 (SD4)
/SDO: J7.2, R13.1, U8.4 (SD0)
/Servo_0: J14.3, U2.13 (GPIO12)
/Servo_1: J15.3, U2.15 (GPIO13)
GND: C1.1, C5.2, C7.2, C18.1, D2.1 (K), D3.1 (K), J1.3, J5.1, J7.4, J8.4, J9.4, J10.4, J11.4, J13.4, J14.1, J15.1, J16.2, J17.2, J18.2, J19.2, J20.4, R7.2, U1.1 (GND), U2.14 (GND), U2.32 (GND), U2.38 (GND), U3.3 (GND), U8.1 (A0), U8.2 (A1), U8.12 (GND), U8.21 (A2)
unnamed: D2.2 (A), R3.2
unnamed: D3.2 (A), R5.2
unnamed: J2.1, Q4.3 (D), R35.2
unnamed: J2.3, Q5.3 (D), R36.2
unnamed: J2.4, Q6.3 (D), R37.2
unnamed: J3.1, Q7.3 (D), R41.2
unnamed: J3.3, Q8.3 (D), R42.2
unnamed: J3.4, Q9.3 (D), R43.2
unnamed: J4.1, Q10.3 (D), R47.2
unnamed: J4.3, Q11.3 (D), R48.2
unnamed: J4.4, Q12.3 (D), R49.2
unnamed: J6.1, Q1.3 (D), R23.2
unnamed: J6.3, Q2.3 (D), R25.2
unnamed: J6.4, Q3.3 (D), R31.2
unnamed: R50.2, U2.1 (3.3V)
unnamed: R7.1, U3.1 (ADDR)
unnamed: R4.2, U3.2 (ALERT/RDY)
unnamed: R8.2, U8.3 (~RESET)

Notes on the sheet:
Limit Switches (Normally Open operation)
External ADC (PH sensor)
Steppers
ENA OPTO DIR PUL
Encoders
Servos
DC motor driver
