ICRS/IPRL-Electronics-Hardware/PCBs/Arm Schematic V2/Arm Schematic V2/Arm Schematic V2.kicad_pcb

## KiCad design PCBs/Arm Schematic V2/Arm Schematic V2/Arm Schematic V2.kicad_pcb (continued)

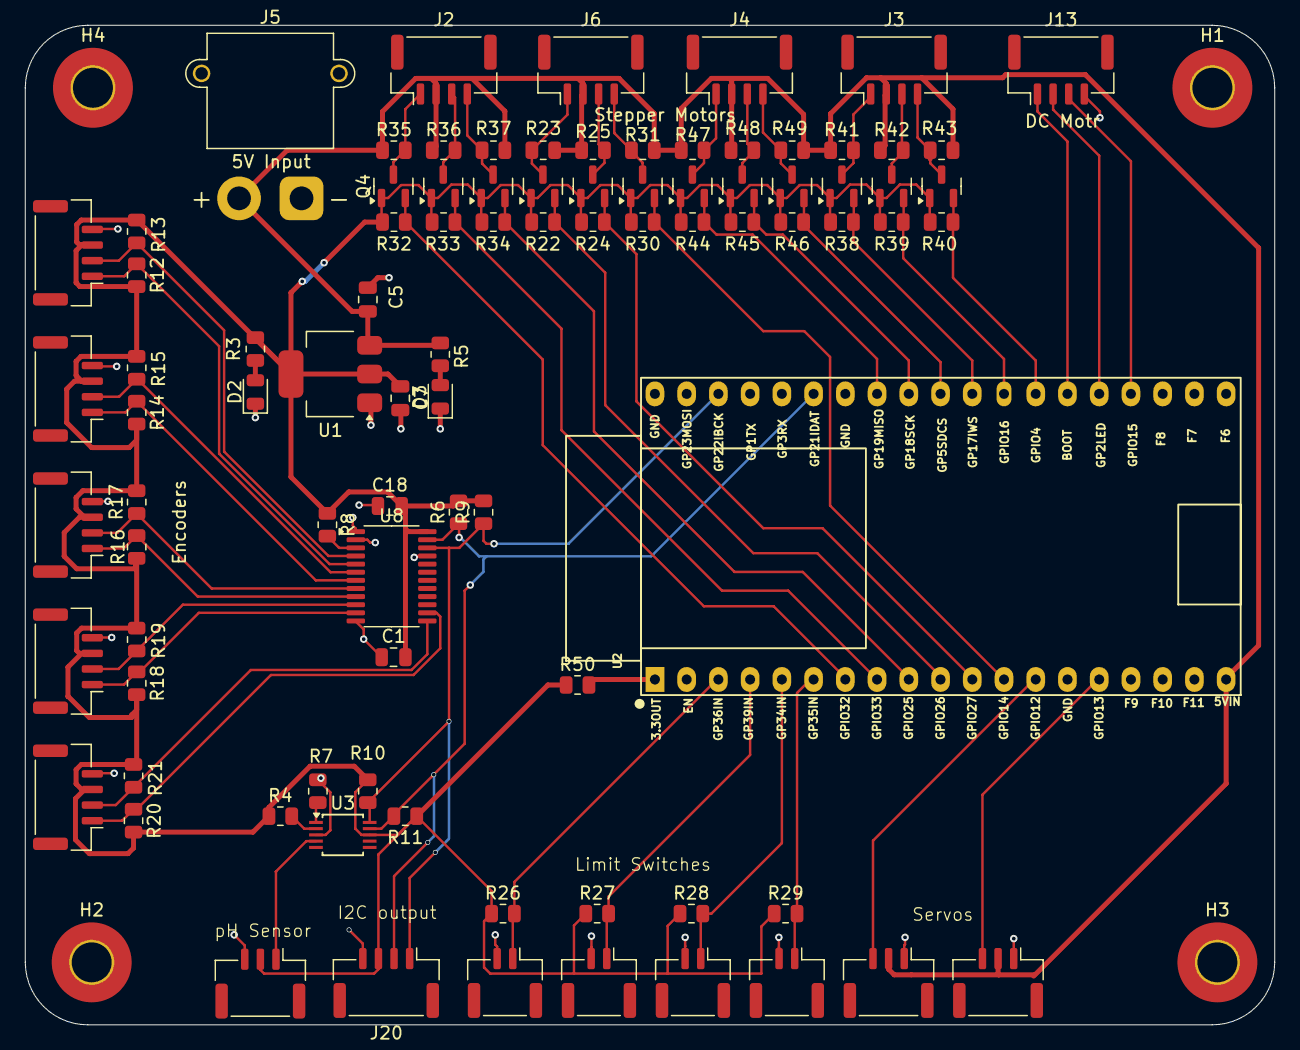
[picture p14: board Arm Schematic V2.kicad_pcb from above]

Board: 2 copper layers, 100.0 x 80.0 mm, 93 parts (0 on the bottom side), 55 nets.
