ICRS/IPRL-Electronics-Hardware/PCBs/encoder/encoder.kicad_pcb

## KiCad design PCBs/encoder/encoder.kicad_pcb (2025-07-08)

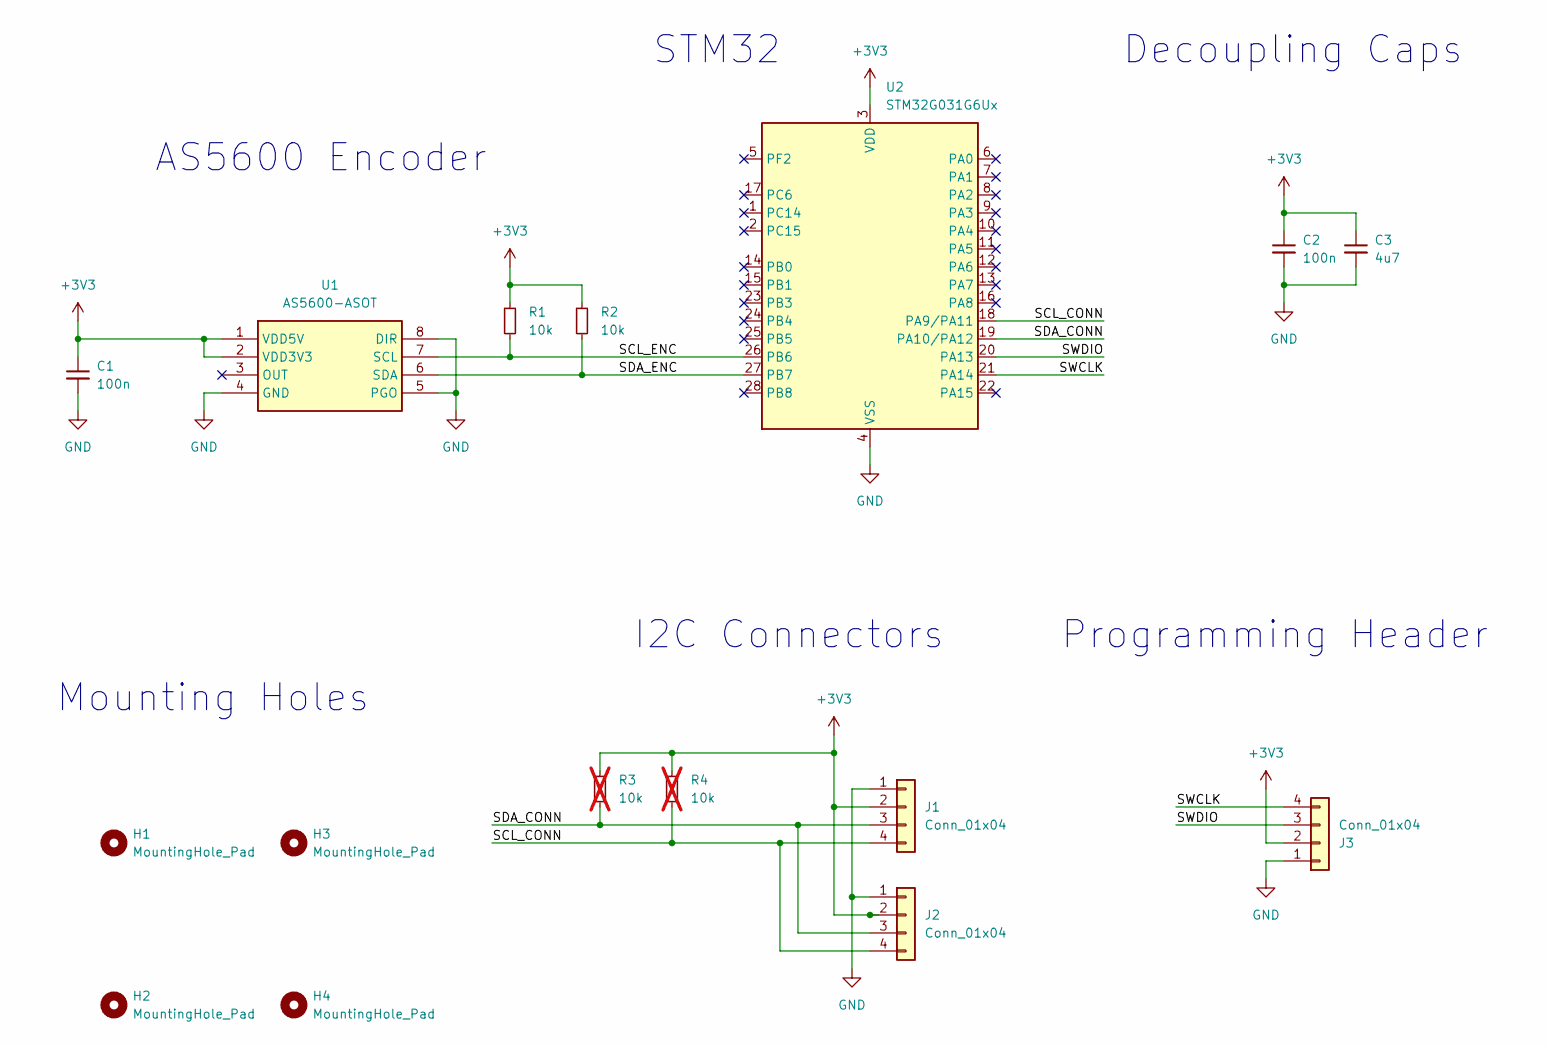
[picture p15: schematic encoder.kicad_sch]

Parts:
C1, C2: 100n; C_0603_1608Metric
C3: 4u7; C_0603_1608Metric
H1, H2, H3, H4: MountingHole_Pad; MountingHole_3.2mm_M3
J1, J2: Conn_01x04; JST_XH_B4B-XH-A_1x04_P2.50mm_Vertical
J3: Conn_01x04; JST_GH_SM04B-GHS-TB_1x04-1MP_P1.25mm_Horizontal
R1, R2: 10k; R_0603_1608Metric
R3, R4: 10k; R_0603_1608Metric; not fitted
U1: AS5600-ASOT; SOIC127P600X175-8N; Mouser Part Number 985-AS5600-ASOT
U2: STM32G031G6Ux; QFN-28_4x4mm_P0.5mm

Connections:
+3V3: C1.1, C2.1, C3.1, J1.2, J2.2, J3.2, R1.1, R2.1, R3.1, R4.1, U1.1 (VDD5V), U1.2 (VDD3V3), U2.3 (VDD)
/SCL_CONN: J1.4, J2.4, R4.2, U2.18 (PA9/PA11)
/SCL_ENC: R1.2, U1.7 (SCL), U2.26 (PB6)
/SDA_CONN: J1.3, J2.3, R3.2, U2.19 (PA10/PA12)
/SDA_ENC: R2.2, U1.6 (SDA), U2.27 (PB7)
/SWCLK: J3.4, U2.21 (PA14)
/SWDIO: J3.3, U2.20 (PA13)
GND: C1.2, C2.2, C3.2, J1.1, J2.1, J3.1, U1.4 (GND), U1.5 (PGO), U1.8 (DIR), U2.4 (VSS)

Notes on the sheet:
Mounting Holes
I2C Connectors
STM32
Programming Header
Decoupling Caps
AS5600 Encoder

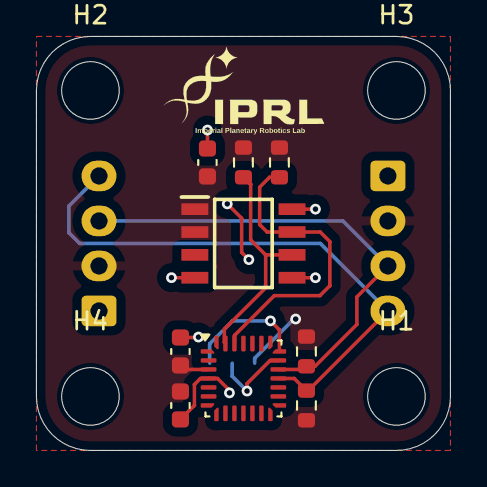
[picture p16: board encoder.kicad_pcb from above]

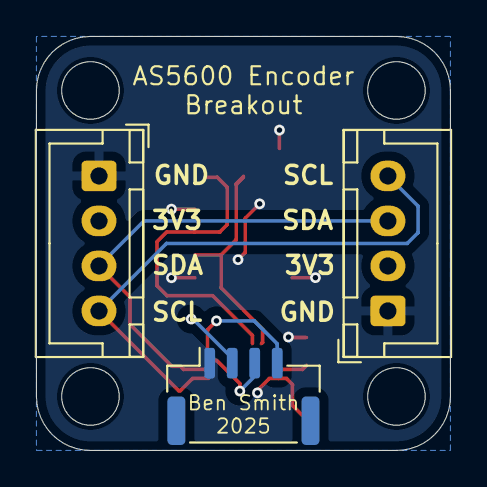
[picture p17: board encoder.kicad_pcb from below]

Board: 2 copper layers, 23.0 x 23.0 mm, 16 parts (3 on the bottom side), 8 nets.
