ICRS/IPRL-Electronics-Hardware/PCBs/Power_V2_secondary/Power_V2_secondary.kicad_pcb

## KiCad design PCBs/Power_V2_secondary/Power_V2_secondary.kicad_pcb (2025-07-07)

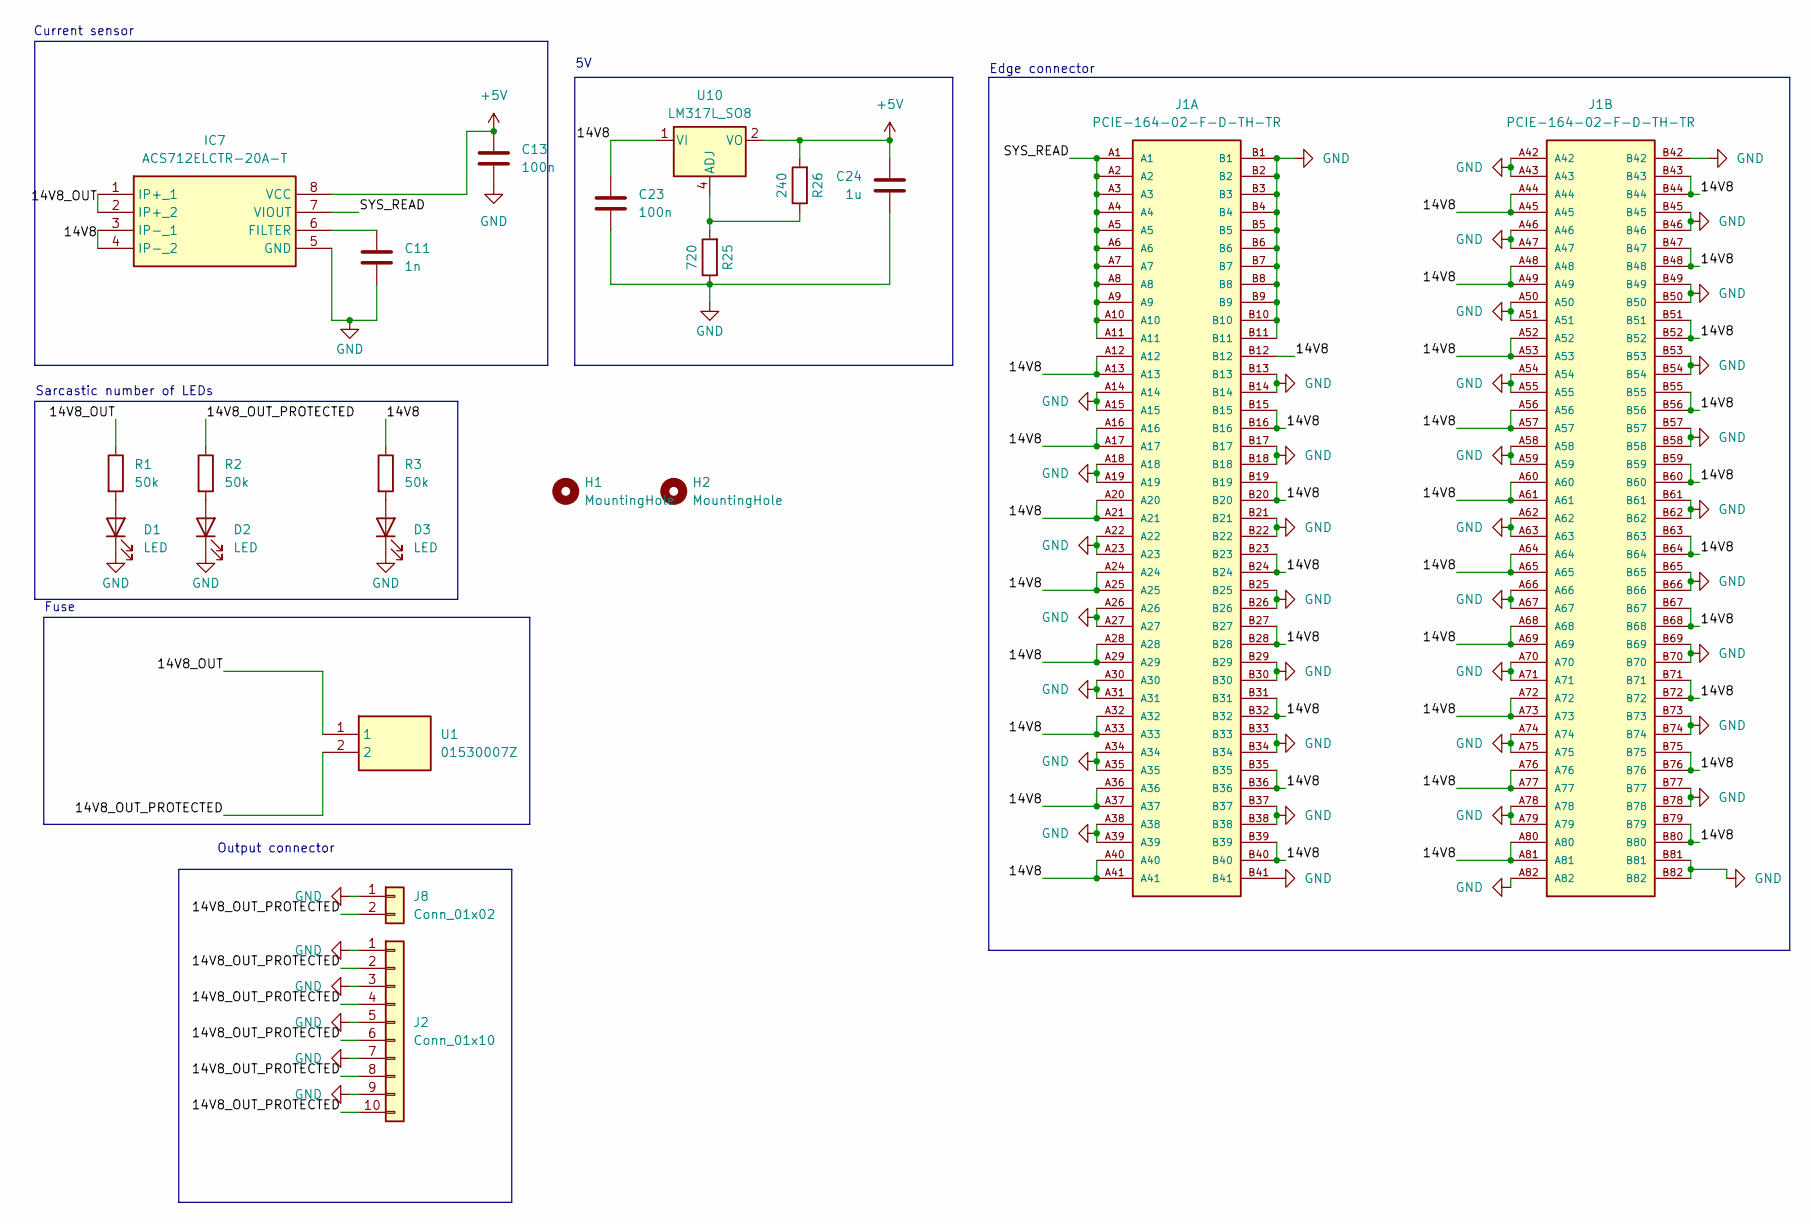
[picture p18: schematic Power_V2_secondary.kicad_sch]

Parts:
C11: 1n; C_0805_2012Metric
C13, C23: 100n; C_0805_2012Metric
C24: 1u; C_0805_2012Metric
D1, D2, D3: LED; D_0805_2012Metric
H1, H2: MountingHole; MountingHole_2.7mm_M2.5_DIN965_Pad_TopBottom
IC7: ACS712ELCTR-20A-T; SOIC127P600X175-8N; Manufacturer_Part_Number ACS712ELCTR-20A-T
J1: PCIE-164-02-F-D-TH-TR; BUS_PCIexpress_x16; PARTREV Y
J2: Conn_01x10; TerminalBlock_MaiXu_MX126-5.0-10P_1x10_P5.00mm
J8: Conn_01x02; AMASS_XT60PW-F_1x02_P7.20mm_Horizontal
R1, R2, R3: 50k; R_0805_2012Metric
R25: 720; R_0805_2012Metric
R26: 240; R_0805_2012Metric
U1: 01530007Z; Manufacturer_Part_Number 01530007Z; Mouser Part Number 576-01530007Z
U10: LM317L_SO8; SOIC-8_3.9x4.9mm_P1.27mm

Connections:
+5V: C13.1, C24.1, IC7.8 (VCC), R26.2, U10.2 (VO), U10.3 (VO), U10.6 (VO), U10.7 (VO)
/14V8: C23.1, IC7.3 (IP-_1), IC7.4 (IP-_2), J1.A12, J1.A13, J1.A16, J1.A17, J1.A20, J1.A21, J1.A24, J1.A25, J1.A28, J1.A29, J1.A32, J1.A33, J1.A36, J1.A37, J1.A40, J1.A41, J1.A44, J1.A45, J1.A48, J1.A49, J1.A52, J1.A53, J1.A56, J1.A57, J1.A60, J1.A61, J1.A64, J1.A65, J1.A68, J1.A69, J1.A72, J1.A73, J1.A76, J1.A77, J1.A80, J1.A81, J1.B12, J1.B15, J1.B16, J1.B19, J1.B20, J1.B23, J1.B24, J1.B27, J1.B28, J1.B31, J1.B32, J1.B35, J1.B36, J1.B39, J1.B40, J1.B43, J1.B44, J1.B47, J1.B48, J1.B51, J1.B52, J1.B55, J1.B56, J1.B59, J1.B60, J1.B63, J1.B64, J1.B67, J1.B68, J1.B71, J1.B72, J1.B75, J1.B76, J1.B79, J1.B80, R3.1, U10.1 (VI)
/14V8_OUT: IC7.1 (IP+_1), IC7.2 (IP+_2), R1.1, U1.1
/14V8_OUT_PROTECTED: J2.2, J2.4, J2.6, J2.8, J2.10, J8.2, R2.1, U1.2
/SYS_READ: IC7.7 (VIOUT), J1.A1, J1.A2, J1.A3, J1.A4, J1.A5, J1.A6, J1.A7, J1.A8, J1.A9, J1.A10, J1.A11
GND: C11.2, C13.2, C23.2, C24.2, D1.1 (K), D2.1 (K), D3.1 (K), IC7.5 (GND), J1.A14, J1.A15, J1.A18, J1.A19, J1.A22, J1.A23, J1.A26, J1.A27, J1.A30, J1.A31, J1.A34, J1.A35, J1.A38, J1.A39, J1.A42, J1.A43, J1.A46, J1.A47, J1.A50, J1.A51, J1.A54, J1.A55, J1.A58, J1.A59, J1.A62, J1.A63, J1.A66, J1.A67, J1.A70, J1.A71, J1.A74, J1.A75, J1.A78, J1.A79, J1.A82, J1.B1, J1.B2, J1.B3, J1.B4, J1.B5, J1.B6, J1.B7, J1.B8, J1.B9, J1.B10, J1.B11, J1.B13, J1.B14, J1.B17, J1.B18, J1.B21, J1.B22, J1.B25, J1.B26, J1.B29, J1.B30, J1.B33, J1.B34, J1.B37, J1.B38, J1.B41, J1.B42, J1.B45, J1.B46, J1.B49, J1.B50, J1.B53, J1.B54, J1.B57, J1.B58, J1.B61, J1.B62, J1.B65, J1.B66, J1.B69, J1.B70, J1.B73, J1.B74, J1.B77, J1.B78, J1.B81, J1.B82, J2.1, J2.3, J2.5, J2.7, J2.9, J8.1, R25.1
unnamed: D1.2 (A), R1.2
unnamed: D2.2 (A), R2.2
unnamed: D3.2 (A), R3.2
unnamed: C11.1, IC7.6 (FILTER)
unnamed: R25.2, R26.1, U10.4 (ADJ)

Notes on the sheet:
Output connector
Sarcastic number of LEDs
Edge connector
Current sensor
Fuse

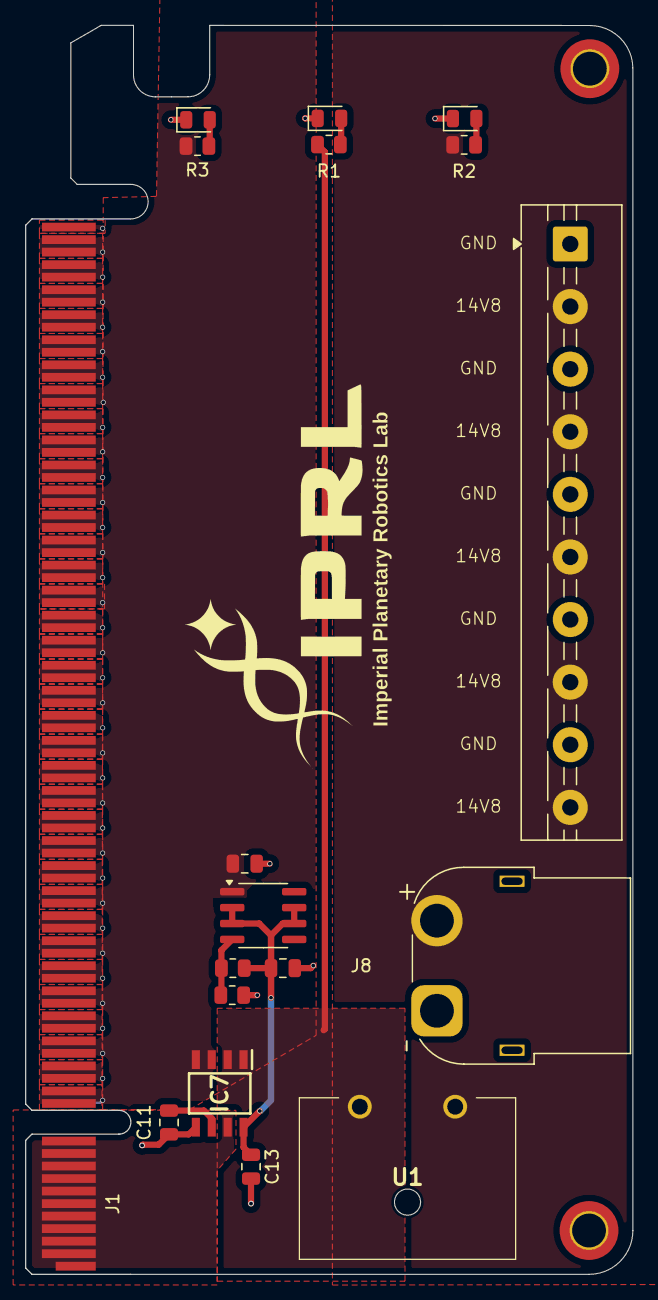
[picture p19: board Power_V2_secondary.kicad_pcb from above]

Board: 2 copper layers, 48.5 x 99.8 mm, 20 parts (1 on the bottom side), 11 nets.
