ICRS/IPRL-Electronics-Hardware/PCBs/Power_V2_main/Power_V2_main.kicad_pcb

## KiCad design PCBs/Power_V2_main/Power_V2_main.kicad_pcb (2025-07-06)

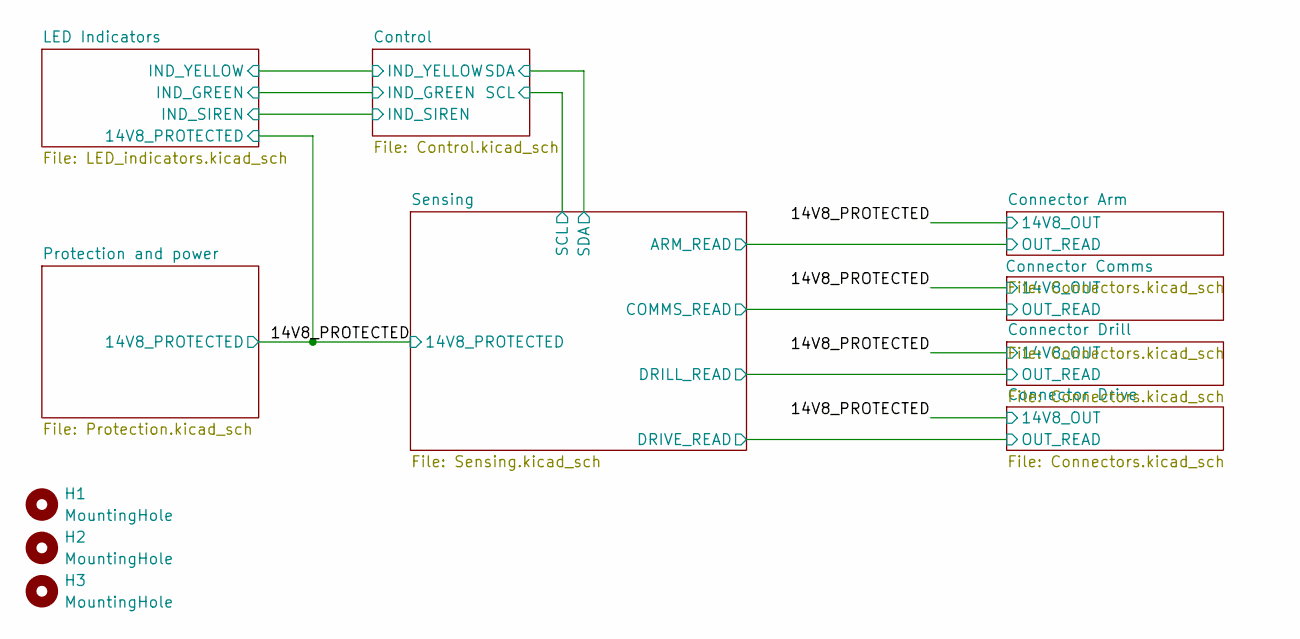
[picture p20: schematic Power_V2_main.kicad_sch]

Parts:
H1, H2, H3: MountingHole; MountingHole_2.7mm_M2.5_DIN965_Pad_TopBottom

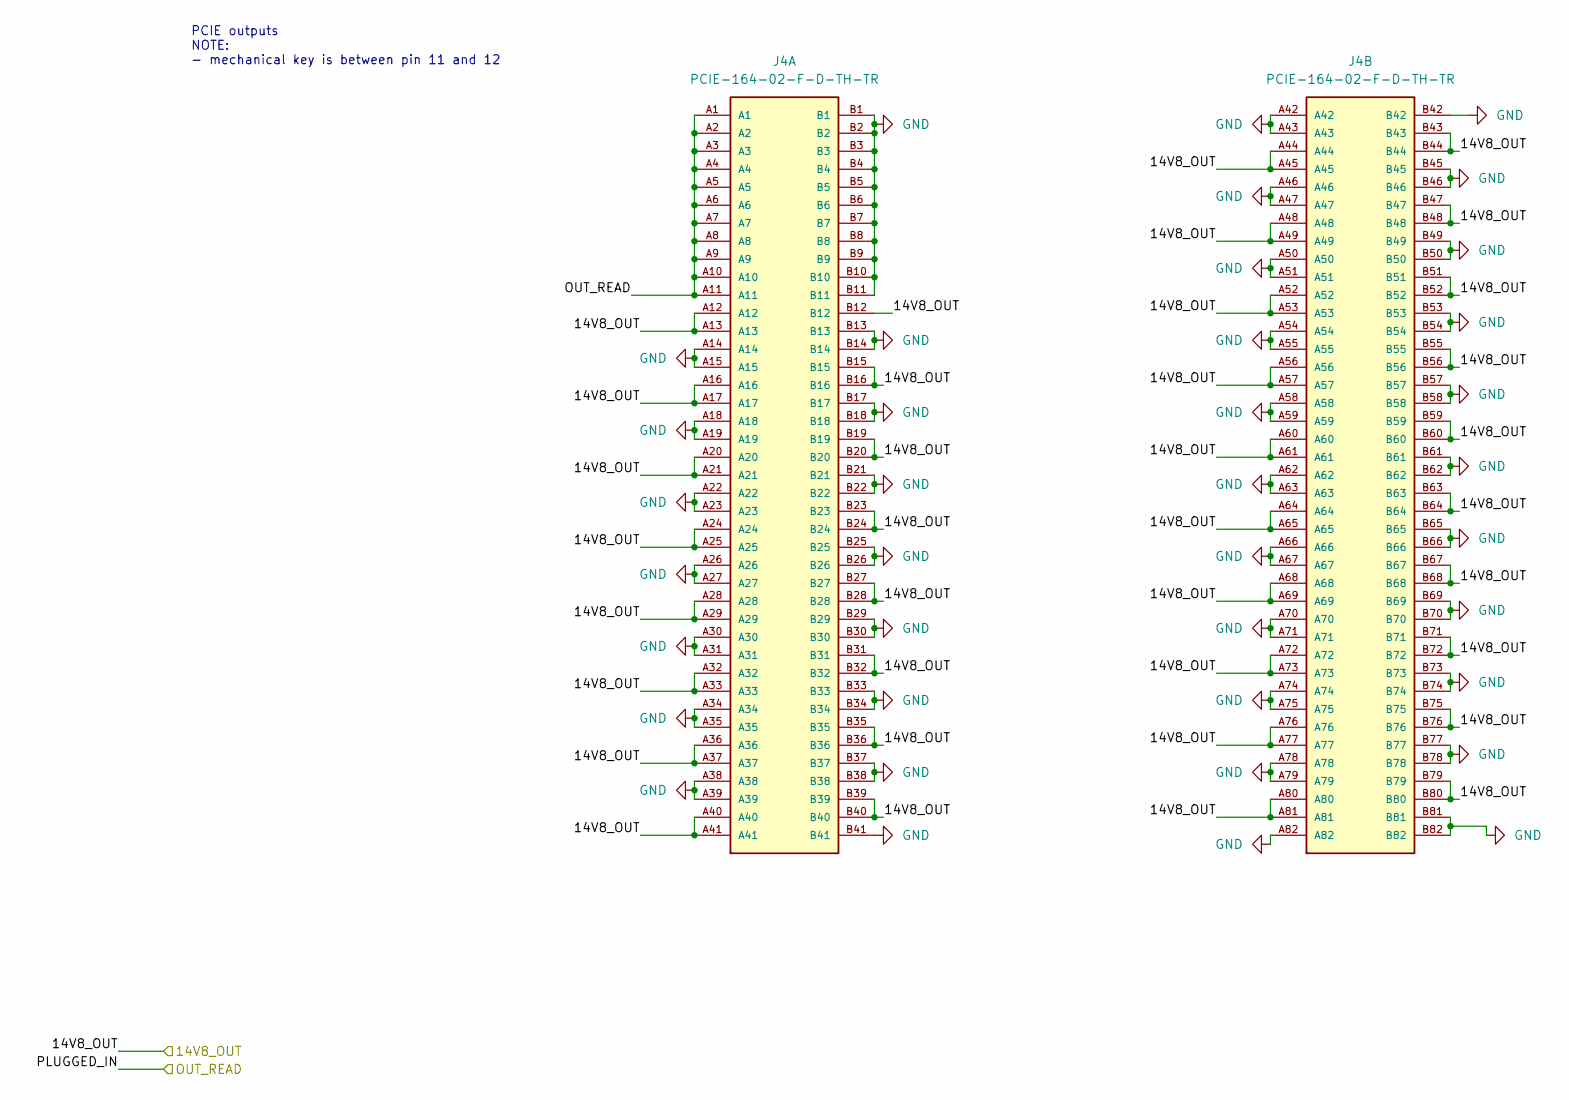
[picture p21: schematic Connectors.kicad_sch]

Parts:
J4: PCIE-164-02-F-D-TH-TR; SAMTEC_PCIE-164-02-F-D-TH-TR; PARTREV Y

Connections:
/14V8_PROTECTED: J4.A12, J4.A13, J4.A16, J4.A17, J4.A20, J4.A21, J4.A24, J4.A25, J4.A28, J4.A29, J4.A32, J4.A33, J4.A36, J4.A37, J4.A40, J4.A41, J4.A44, J4.A45, J4.A48, J4.A49, J4.A52, J4.A53, J4.A56, J4.A57, J4.A60, J4.A61, J4.A64, J4.A65, J4.A68, J4.A69, J4.A72, J4.A73, J4.A76, J4.A77, J4.A80, J4.A81, J4.B12, J4.B15, J4.B16, J4.B19, J4.B20, J4.B23, J4.B24, J4.B27, J4.B28, J4.B31, J4.B32, J4.B35, J4.B36, J4.B39, J4.B40, J4.B43, J4.B44, J4.B47, J4.B48, J4.B51, J4.B52, J4.B55, J4.B56, J4.B59, J4.B60, J4.B63, J4.B64, J4.B67, J4.B68, J4.B71, J4.B72, J4.B75, J4.B76, J4.B79, J4.B80; also elsewhere on the board
/Connector Arm/OUT_READ: J4.A1, J4.A2, J4.A3, J4.A4, J4.A5, J4.A6, J4.A7, J4.A8, J4.A9, J4.A10, J4.A11; also elsewhere on the board
GND: J4.A14, J4.A15, J4.A18, J4.A19, J4.A22, J4.A23, J4.A26, J4.A27, J4.A30, J4.A31, J4.A34, J4.A35, J4.A38, J4.A39, J4.A42, J4.A43, J4.A46, J4.A47, J4.A50, J4.A51, J4.A54, J4.A55, J4.A58, J4.A59, J4.A62, J4.A63, J4.A66, J4.A67, J4.A70, J4.A71, J4.A74, J4.A75, J4.A78, J4.A79, J4.A82, J4.B1, J4.B2, J4.B3, J4.B4, J4.B5, J4.B6, J4.B7, J4.B8, J4.B9, J4.B10, J4.B11, J4.B13, J4.B14, J4.B17, J4.B18, J4.B21, J4.B22, J4.B25, J4.B26, J4.B29, J4.B30, J4.B33, J4.B34, J4.B37, J4.B38, J4.B41, J4.B42, J4.B45, J4.B46, J4.B49, J4.B50, J4.B53, J4.B54, J4.B57, J4.B58, J4.B61, J4.B62, J4.B65, J4.B66, J4.B69, J4.B70, J4.B73, J4.B74, J4.B77, J4.B78, J4.B81, J4.B82; also elsewhere on the board

Parts of its further copies:
J5, J6, J8: PCIE-164-02-F-D-TH-TR; SAMTEC_PCIE-164-02-F-D-TH-TR; PARTREV Y

Connections of its further copies:
/14V8_PROTECTED: J5.A12, J5.A13, J5.A16, J5.A17, J5.A20, J5.A21, J5.A24, J5.A25, J5.A28, J5.A29, J5.A32, J5.A33, J5.A36, J5.A37, J5.A40, J5.A41, J5.A44, J5.A45, J5.A48, J5.A49, J5.A52, J5.A53, J5.A56, J5.A57, J5.A60, J5.A61, J5.A64, J5.A65, J5.A68, J5.A69, J5.A72, J5.A73, J5.A76, J5.A77, J5.A80, J5.A81, J5.B12, J5.B15, J5.B16, J5.B19, J5.B20, J5.B23, J5.B24, J5.B27, J5.B28, J5.B31, J5.B32, J5.B35, J5.B36, J5.B39, J5.B40, J5.B43, J5.B44, J5.B47, J5.B48, J5.B51, J5.B52, J5.B55, J5.B56, J5.B59, J5.B60, J5.B63, J5.B64, J5.B67, J5.B68, J5.B71, J5.B72, J5.B75, J5.B76, J5.B79, J5.B80, J6.A12, J6.A13, J6.A16, J6.A17, J6.A20, J6.A21, J6.A24, J6.A25, J6.A28, J6.A29, J6.A32, J6.A33, J6.A36, J6.A37, J6.A40, J6.A41, J6.A44, J6.A45, J6.A48, J6.A49, J6.A52, J6.A53, J6.A56, J6.A57, J6.A60, J6.A61, J6.A64, J6.A65, J6.A68, J6.A69, J6.A72, J6.A73, J6.A76, J6.A77, J6.A80, J6.A81, J6.B12, J6.B15, J6.B16, J6.B19, J6.B20, J6.B23, J6.B24, J6.B27, J6.B28, J6.B31, J6.B32, J6.B35, J6.B36, J6.B39, J6.B40, J6.B43, J6.B44, J6.B47, J6.B48, J6.B51, J6.B52, J6.B55, J6.B56, J6.B59, J6.B60, J6.B63, J6.B64, J6.B67, J6.B68, J6.B71, J6.B72, J6.B75, J6.B76, J6.B79, J6.B80, J8.A12, J8.A13, J8.A16, J8.A17, J8.A20, J8.A21, J8.A24, J8.A25, J8.A28, J8.A29, J8.A32, J8.A33, J8.A36, J8.A37, J8.A40, J8.A41, J8.A44, J8.A45, J8.A48, J8.A49, J8.A52, J8.A53, J8.A56, J8.A57, J8.A60, J8.A61, J8.A64, J8.A65, J8.A68, J8.A69, J8.A72, J8.A73, J8.A76, J8.A77, J8.A80, J8.A81, J8.B12, J8.B15, J8.B16, J8.B19, J8.B20, J8.B23, J8.B24, J8.B27, J8.B28, J8.B31, J8.B32, J8.B35, J8.B36, J8.B39, J8.B40, J8.B43, J8.B44, J8.B47, J8.B48, J8.B51, J8.B52, J8.B55, J8.B56, J8.B59, J8.B60, J8.B63, J8.B64, J8.B67, J8.B68, J8.B71, J8.B72, J8.B75, J8.B76, J8.B79, J8.B80; also elsewhere on the board
/Connector Comms/OUT_READ: J5.A1, J5.A2, J5.A3, J5.A4, J5.A5, J5.A6, J5.A7, J5.A8, J5.A9, J5.A10, J5.A11; also elsewhere on the board
/Connector Drill/OUT_READ: J8.A1, J8.A2, J8.A3, J8.A4, J8.A5, J8.A6, J8.A7, J8.A8, J8.A9, J8.A10, J8.A11; also elsewhere on the board
/Connector Drive/OUT_READ: J6.A1, J6.A2, J6.A3, J6.A4, J6.A5, J6.A6, J6.A7, J6.A8, J6.A9, J6.A10, J6.A11; also elsewhere on the board
GND: J5.A14, J5.A15, J5.A18, J5.A19, J5.A22, J5.A23, J5.A26, J5.A27, J5.A30, J5.A31, J5.A34, J5.A35, J5.A38, J5.A39, J5.A42, J5.A43, J5.A46, J5.A47, J5.A50, J5.A51, J5.A54, J5.A55, J5.A58, J5.A59, J5.A62, J5.A63, J5.A66, J5.A67, J5.A70, J5.A71, J5.A74, J5.A75, J5.A78, J5.A79, J5.A82, J5.B1, J5.B2, J5.B3, J5.B4, J5.B5, J5.B6, J5.B7, J5.B8, J5.B9, J5.B10, J5.B11, J5.B13, J5.B14, J5.B17, J5.B18, J5.B21, J5.B22, J5.B25, J5.B26, J5.B29, J5.B30, J5.B33, J5.B34, J5.B37, J5.B38, J5.B41, J5.B42, J5.B45, J5.B46, J5.B49, J5.B50, J5.B53, J5.B54, J5.B57, J5.B58, J5.B61, J5.B62, J5.B65, J5.B66, J5.B69, J5.B70, J5.B73, J5.B74, J5.B77, J5.B78, J5.B81, J5.B82, J6.A14, J6.A15, J6.A18, J6.A19, J6.A22, J6.A23, J6.A26, J6.A27, J6.A30, J6.A31, J6.A34, J6.A35, J6.A38, J6.A39, J6.A42, J6.A43, J6.A46, J6.A47, J6.A50, J6.A51, J6.A54, J6.A55, J6.A58, J6.A59, J6.A62, J6.A63, J6.A66, J6.A67, J6.A70, J6.A71, J6.A74, J6.A75, J6.A78, J6.A79, J6.A82, J6.B1, J6.B2, J6.B3, J6.B4, J6.B5, J6.B6, J6.B7, J6.B8, J6.B9, J6.B10, J6.B11, J6.B13, J6.B14, J6.B17, J6.B18, J6.B21, J6.B22, J6.B25, J6.B26, J6.B29, J6.B30, J6.B33, J6.B34, J6.B37, J6.B38, J6.B41, J6.B42, J6.B45, J6.B46, J6.B49, J6.B50, J6.B53, J6.B54, J6.B57, J6.B58, J6.B61, J6.B62, J6.B65, J6.B66, J6.B69, J6.B70, J6.B73, J6.B74, J6.B77, J6.B78, J6.B81, J6.B82, J8.A14, J8.A15, J8.A18, J8.A19, J8.A22, J8.A23, J8.A26, J8.A27, J8.A30, J8.A31, J8.A34, J8.A35, J8.A38, J8.A39, J8.A42, J8.A43, J8.A46, J8.A47, J8.A50, J8.A51, J8.A54, J8.A55, J8.A58, J8.A59, J8.A62, J8.A63, J8.A66, J8.A67, J8.A70, J8.A71, J8.A74, J8.A75, J8.A78, J8.A79, J8.A82, J8.B1, J8.B2, J8.B3, J8.B4, J8.B5, J8.B6, J8.B7, J8.B8, J8.B9, J8.B10, J8.B11, J8.B13, J8.B14, J8.B17, J8.B18, J8.B21, J8.B22, J8.B25, J8.B26, J8.B29, J8.B30, J8.B33, J8.B34, J8.B37, J8.B38, J8.B41, J8.B42, J8.B45, J8.B46, J8.B49, J8.B50, J8.B53, J8.B54, J8.B57, J8.B58, J8.B61, J8.B62, J8.B65, J8.B66, J8.B69, J8.B70, J8.B73, J8.B74, J8.B77, J8.B78, J8.B81, J8.B82; also elsewhere on the board

Notes on the sheet:
PCIE outputs NOTE: - mechanical key is between pin 11 and 12

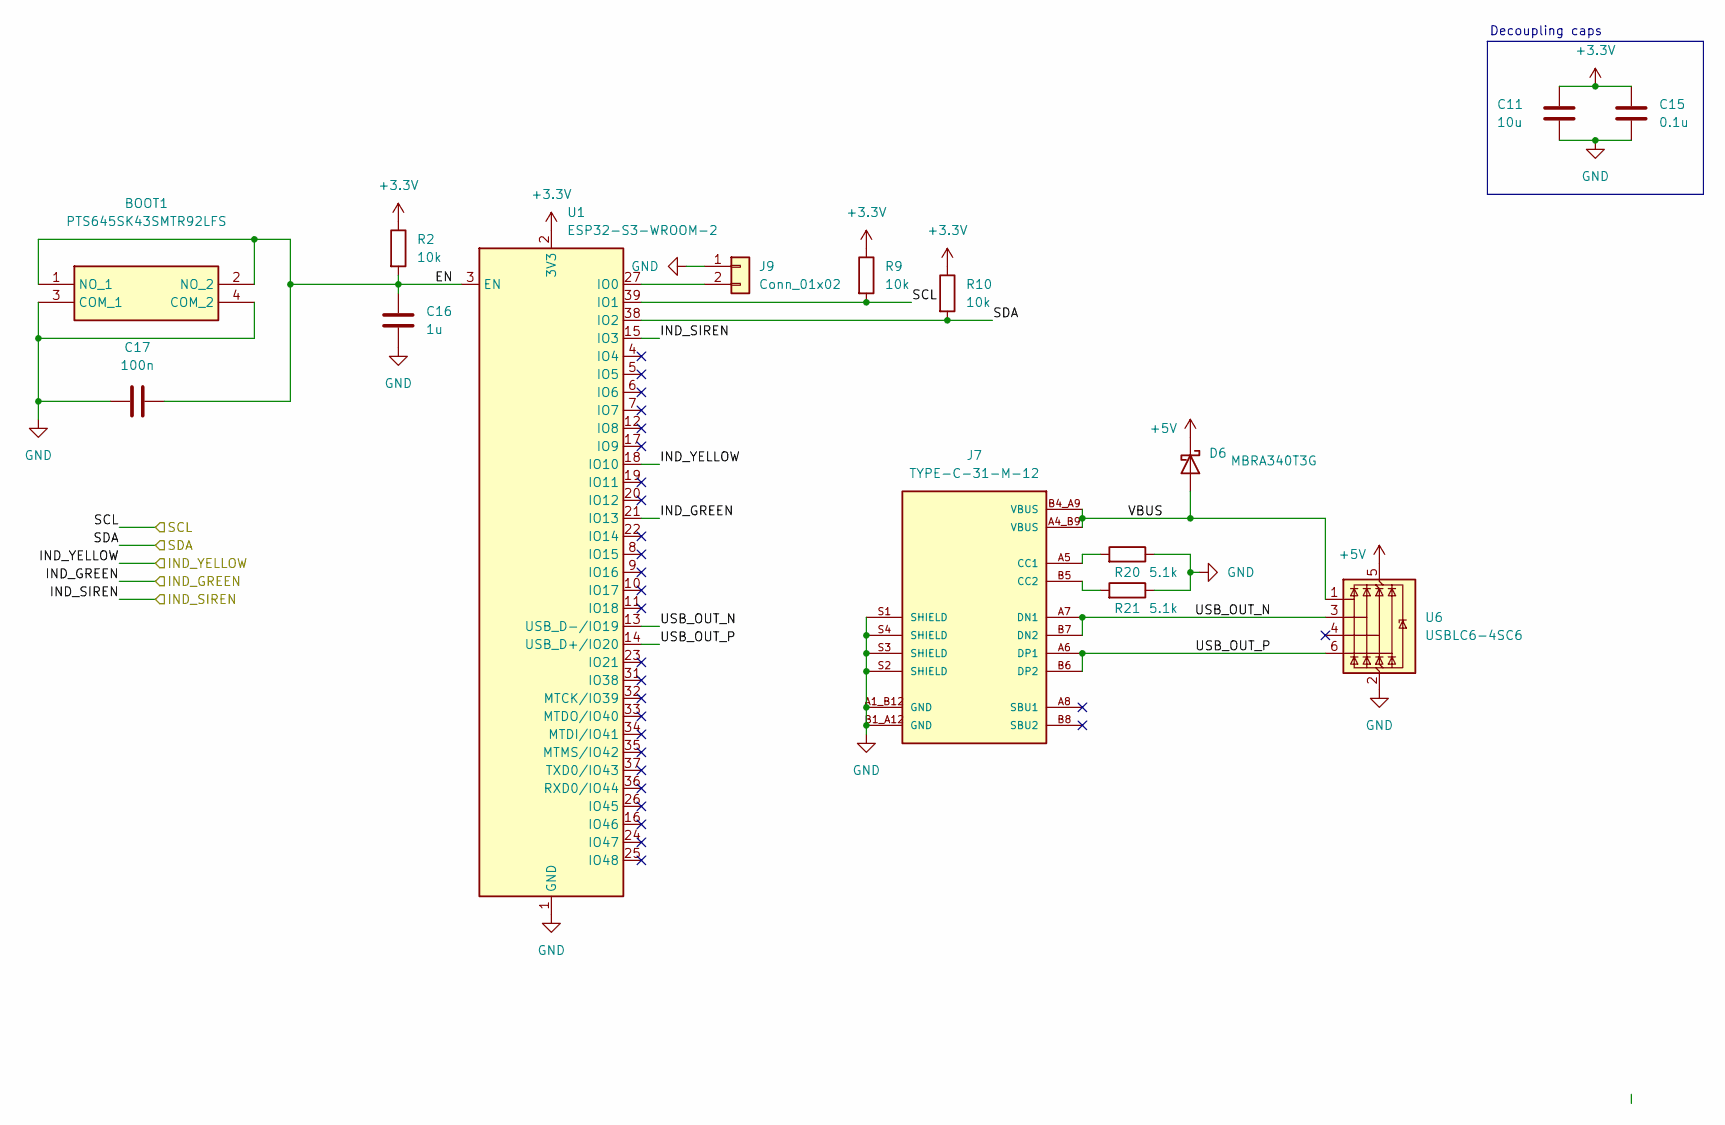
[picture p22: schematic Control.kicad_sch]

Parts:
BOOT1: PTS645SK43SMTR92LFS; Manufacturer_Part_Number PTS645SK43SMTR92LFS; Mouser Part Number 611-PTS645SK43SMTR92
C11: 10u; C_0805_2012Metric
C15: 0.1u; C_0805_2012Metric
C16: 1u; C_0805_2012Metric
C17: 100n; C_0805_2012Metric
D6: MBRA340T3G; D_SMA
J7: TYPE-C-31-M-12; PARTREV 2020.12.08
J9: Conn_01x02; PinHeader_1x02_P2.54mm_Vertical
R2, R9, R10: 10k; R_0805_2012Metric
R20, R21: 5.1k; R_0805_2012Metric
U1: ESP32-S3-WROOM-2
U6: USBLC6-4SC6; SOT-23-6

Connections:
+3.3V: C11.1, C15.1, R2.1, R9.1, R10.1, U1.2 (3V3); also elsewhere on the board
+5V: D6.1 (K), U6.5 (VBUS); also elsewhere on the board
/Control/EN: BOOT1.1 (NO_1), BOOT1.2 (NO_2), C16.1, C17.2, R2.2, U1.3 (EN)
/Control/IND_GREEN: U1.21 (IO13); also elsewhere on the board
/Control/IND_SIREN: U1.15 (IO3); also elsewhere on the board
/Control/IND_YELLOW: U1.18 (IO10); also elsewhere on the board
/Control/SCL: R9.2, U1.39 (IO1); also elsewhere on the board
/Control/SDA: R10.2, U1.38 (IO2); also elsewhere on the board
/Control/USB_OUT_N: J7.A7 (DN1), J7.B7 (DN2), U1.13 (USB_D-/IO19), U6.3 (I/O2)
/Control/USB_OUT_P: J7.A6 (DP1), J7.B6 (DP2), U1.14 (USB_D+/IO20), U6.6 (I/O4)
/Control/VBUS: D6.2 (A), J7.A4_B9 (VBUS), J7.B4_A9 (VBUS), U6.1 (I/O1)
GND: BOOT1.3 (COM_1), BOOT1.4 (COM_2), C11.2, C15.2, C16.2, C17.1, J7.A1_B12 (GND), J7.B1_A12 (GND), J7.S1 (SHIELD), J7.S2 (SHIELD), J7.S3 (SHIELD), J7.S4 (SHIELD), J9.1, R20.1, R21.1, U1.1 (GND), U1.40 (GND), U1.41 (GND), U6.2 (GND); also elsewhere on the board
unnamed: J7.A5 (CC1), R20.2
unnamed: J7.B5 (CC2), R21.2
unnamed: J9.2, U1.27 (IO0)

Notes on the sheet:
Decoupling caps

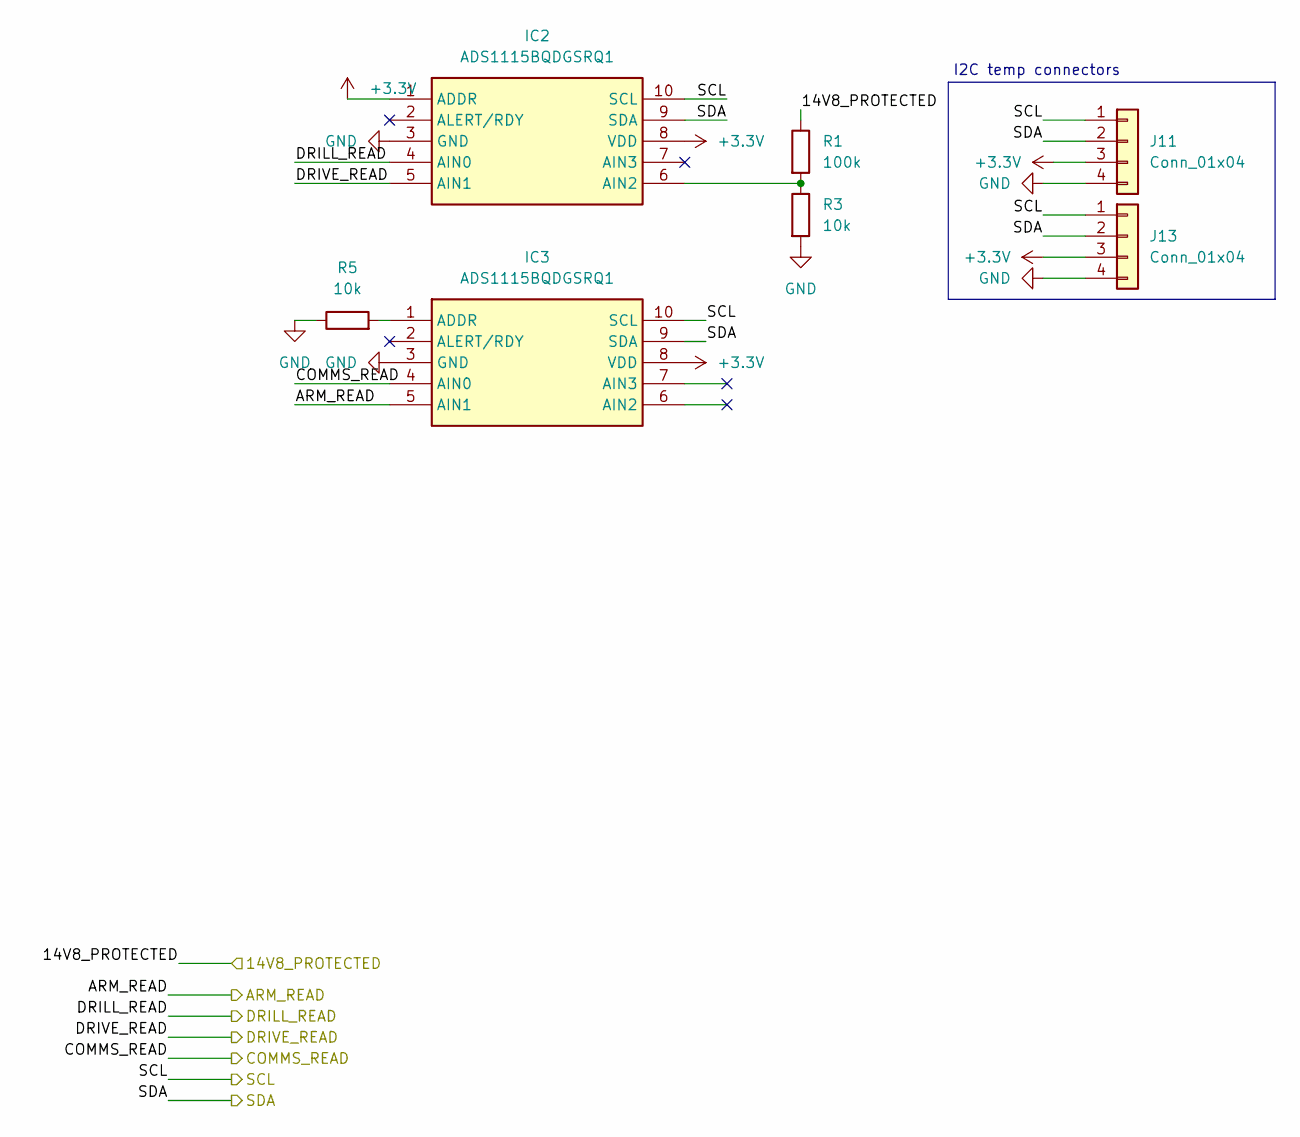
[picture p23: schematic Sensing.kicad_sch]

Parts:
IC2, IC3: ADS1115BQDGSRQ1; SOP50P490X110-10N; Mouser Part Number 595-ADS1115BQDGSRQ1
J11, J13: Conn_01x04; JST_GH_SM04B-GHS-TB_1x04-1MP_P1.25mm_Horizontal
R1: 100k; R_0805_2012Metric
R3, R5: 10k; R_0805_2012Metric

Connections:
+3.3V: IC2.1 (ADDR), IC2.8 (VDD), IC3.8 (VDD), J11.3, J13.3; also elsewhere on the board
/14V8_PROTECTED: R1.1; also elsewhere on the board
/Connector Arm/OUT_READ: IC3.5 (AIN1); also elsewhere on the board
/Connector Comms/OUT_READ: IC3.4 (AIN0); also elsewhere on the board
/Connector Drill/OUT_READ: IC2.4 (AIN0); also elsewhere on the board
/Connector Drive/OUT_READ: IC2.5 (AIN1); also elsewhere on the board
/Control/SCL: IC2.10 (SCL), IC3.10 (SCL), J11.1, J13.1; also elsewhere on the board
/Control/SDA: IC2.9 (SDA), IC3.9 (SDA), J11.2, J13.2; also elsewhere on the board
GND: IC2.3 (GND), IC3.3 (GND), J11.4, J13.4, R3.2, R5.1; also elsewhere on the board
unnamed: IC2.6 (AIN2), R1.2, R3.1
unnamed: IC3.1 (ADDR), R5.2

Notes on the sheet:
I2C temp connectors

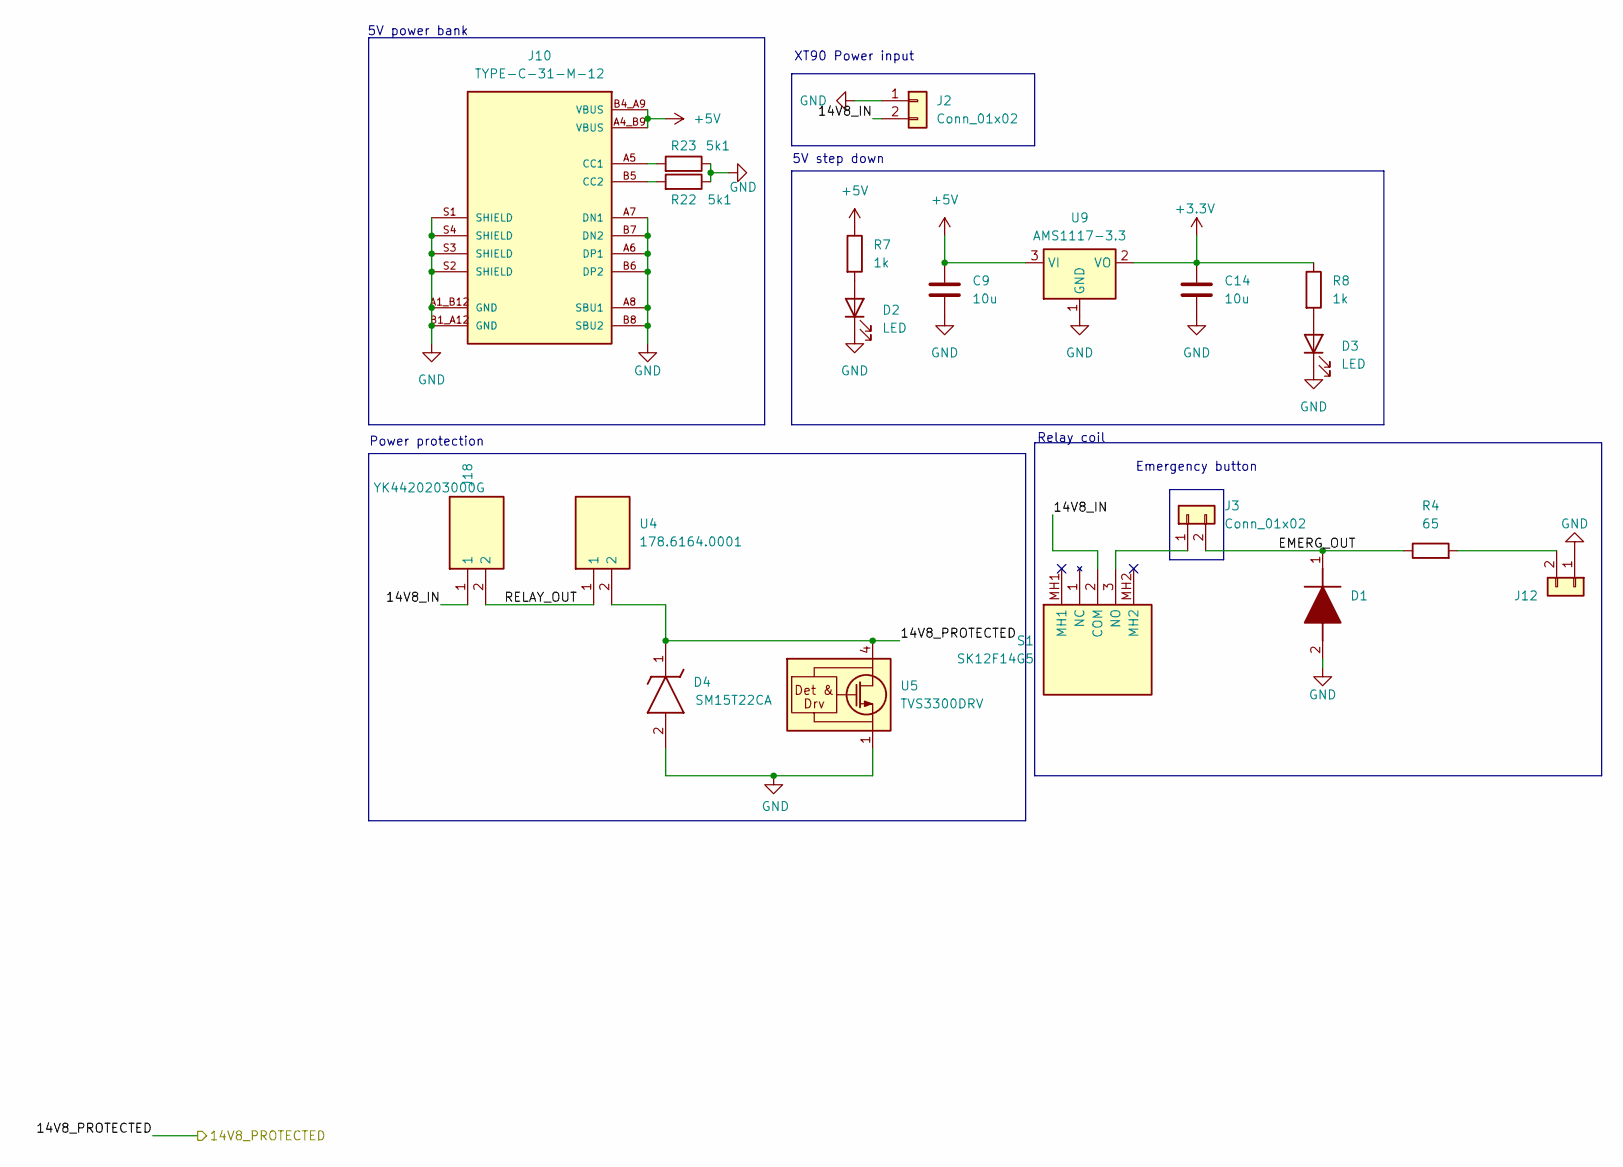
[picture p24: schematic Protection.kicad_sch]

Parts:
C9, C14: 10u; C_0805_2012Metric
D1: 1N4148WT; SODFL1608X70N; Manufacturer_Part_Number 1N4148WT
D2, D3: LED; LED_0805_2012Metric
D4: SM15T22CA; DIOM8059X265N; Manufacturer_Part_Number SM15T22A; Mouser Part Number 511-SM15T22A
J2: Conn_01x02; AMASS_XT90PW-M_1x02_P10.90mm_Horizontal
J3, J12: Conn_01x02; TerminalBlock_Altech_AK300-2_P5.00mm
J10: TYPE-C-31-M-12; PARTREV 2020.12.08
J18: YK4420203000G; RHDR2W120P0X950_1X2_2050X1430X1790P; Manufacturer_Part_Number YK4420203000G; Mouser Part Number 649-YK44202030J0G
R4: 65; R_Axial_DIN0414_L11.9mm_D4.5mm_P15.24mm_Horizontal
R7, R8: 1k; R_0805_2012Metric
R22, R23: 5k1; R_0805_2012Metric
S1: SK12F14G5; Manufacturer_Part_Number SK12F14G5; Mouser Part Number 611-SK12F14G5
U4: 178.6164.0001; 178.6164.XXX1; Mouser Part Number 576-178.6164.0001
U5: TVS3300DRV; WSON-6-1EP_2x2mm_P0.65mm_EP1x1.6mm
U9: AMS1117-3.3; SOT-223-3_TabPin2

Connections:
+3.3V: C14.1, R8.1, U9.2 (VO); also elsewhere on the board
+5V: C9.1, J10.A4_B9 (VBUS), J10.B4_A9 (VBUS), R7.1, U9.3 (VI); also elsewhere on the board
/14V8_PROTECTED: D4.1 (K), U4.2, U5.4 (IN), U5.5 (IN), U5.6 (IN); also elsewhere on the board
/Protection and power/14V8_IN: J2.2, J18.1, S1.2 (COM)
/Protection and power/EMERG_OUT: D1.1 (K), J3.2, R4.1
/Protection and power/RELAY_OUT: J18.2, U4.1
GND: C9.2, C14.2, D1.2 (A), D2.1 (K), D3.1 (K), D4.2 (A), J2.1, J10.A1_B12 (GND), J10.A6 (DP1), J10.A7 (DN1), J10.A8 (SBU1), J10.B1_A12 (GND), J10.B6 (DP2), J10.B7 (DN2), J10.B8 (SBU2), J10.S1 (SHIELD), J10.S2 (SHIELD), J10.S3 (SHIELD), J10.S4 (SHIELD), J12.1, R22.1, R23.1, U5.1 (GND), U5.2 (GND), U5.3 (GND), U5.7 (GND), U9.1 (GND); also elsewhere on the board
unnamed: D2.2 (A), R7.2
unnamed: D3.2 (A), R8.2
unnamed: J3.1, S1.3 (NO)
unnamed: J10.A5 (CC1), R23.2
unnamed: J10.B5 (CC2), R22.2
unnamed: J12.2, R4.2

Notes on the sheet:
5V step down
XT90 Power input
5V power bank
Emergency button
Power protection
Relay coil
