ICRS/IPRL-Electronics-Hardware/PCBs/Power_V2_main/Power_V2_main.kicad_pcb

## KiCad design PCBs/Power_V2_main/Power_V2_main.kicad_pcb (continued)

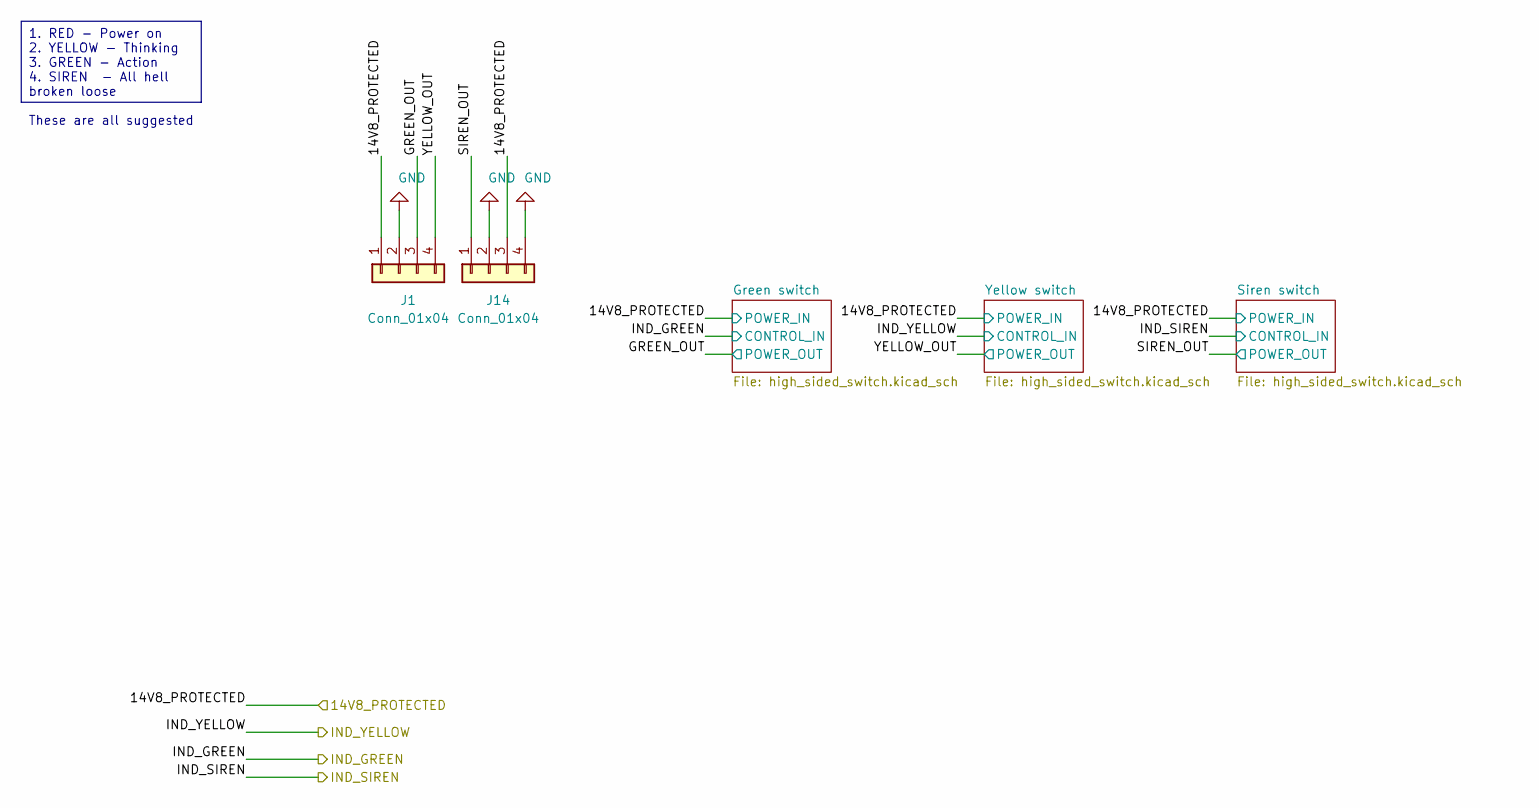
[picture p25: schematic LED_indicators.kicad_sch]

Parts:
J1, J14: Conn_01x04; JST_GH_BM04B-GHS-TBT_1x04-1MP_P1.25mm_Vertical

Connections:
/14V8_PROTECTED: J1.1, J14.3; also elsewhere on the board
/LED Indicators/GREEN_OUT: J1.3; also elsewhere on the board
/LED Indicators/SIREN_OUT: J14.1; also elsewhere on the board
/LED Indicators/YELLOW_OUT: J1.4; also elsewhere on the board
GND: J1.2, J14.2, J14.4; also elsewhere on the board

Notes on the sheet:
1. RED - Power on 2. YELLOW - Thinking 3. GREEN - Action 4. SIREN - All hell broken loose These are all suggested

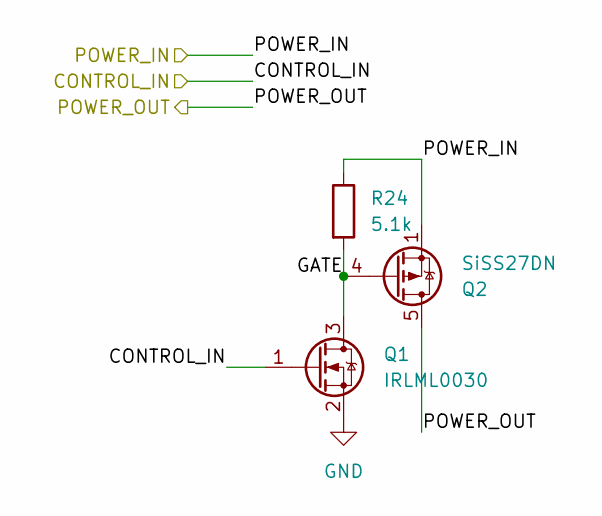
[picture p26: schematic high_sided_switch.kicad_sch]

Parts:
Q1: IRLML0030; SOT-23
Q2: SiSS27DN; Vishay_PowerPAK_1212-8_Single
R24: 5.1k; R_0805_2012Metric

Connections:
/14V8_PROTECTED: Q2.1 (S), Q2.2 (S), Q2.3 (S), R24.1; also elsewhere on the board
/Control/IND_GREEN: Q1.1 (G); also elsewhere on the board
/LED Indicators/GREEN_OUT: Q2.5 (D); also elsewhere on the board
/LED Indicators/Green switch/GATE: Q1.3 (D), Q2.4 (G), R24.2
GND: Q1.2 (S); also elsewhere on the board

Parts of its further copies:
Q4, Q7: SiSS27DN; Vishay_PowerPAK_1212-8_Single
Q5, Q6: IRLML0030; SOT-23
R18, R19: 5.1k; R_0805_2012Metric

Connections of its further copies:
/14V8_PROTECTED: Q4.1 (S), Q4.2 (S), Q4.3 (S), Q7.1 (S), Q7.2 (S), Q7.3 (S), R18.1, R19.1; also elsewhere on the board
/Control/IND_SIREN: Q6.1 (G); also elsewhere on the board
/Control/IND_YELLOW: Q5.1 (G); also elsewhere on the board
/LED Indicators/SIREN_OUT: Q7.5 (D); also elsewhere on the board
/LED Indicators/Siren switch/GATE: Q6.3 (D), Q7.4 (G), R19.2
/LED Indicators/YELLOW_OUT: Q4.5 (D); also elsewhere on the board
/LED Indicators/Yellow switch/GATE: Q4.4 (G), Q5.3 (D), R18.2
GND: Q5.2 (S), Q6.2 (S); also elsewhere on the board

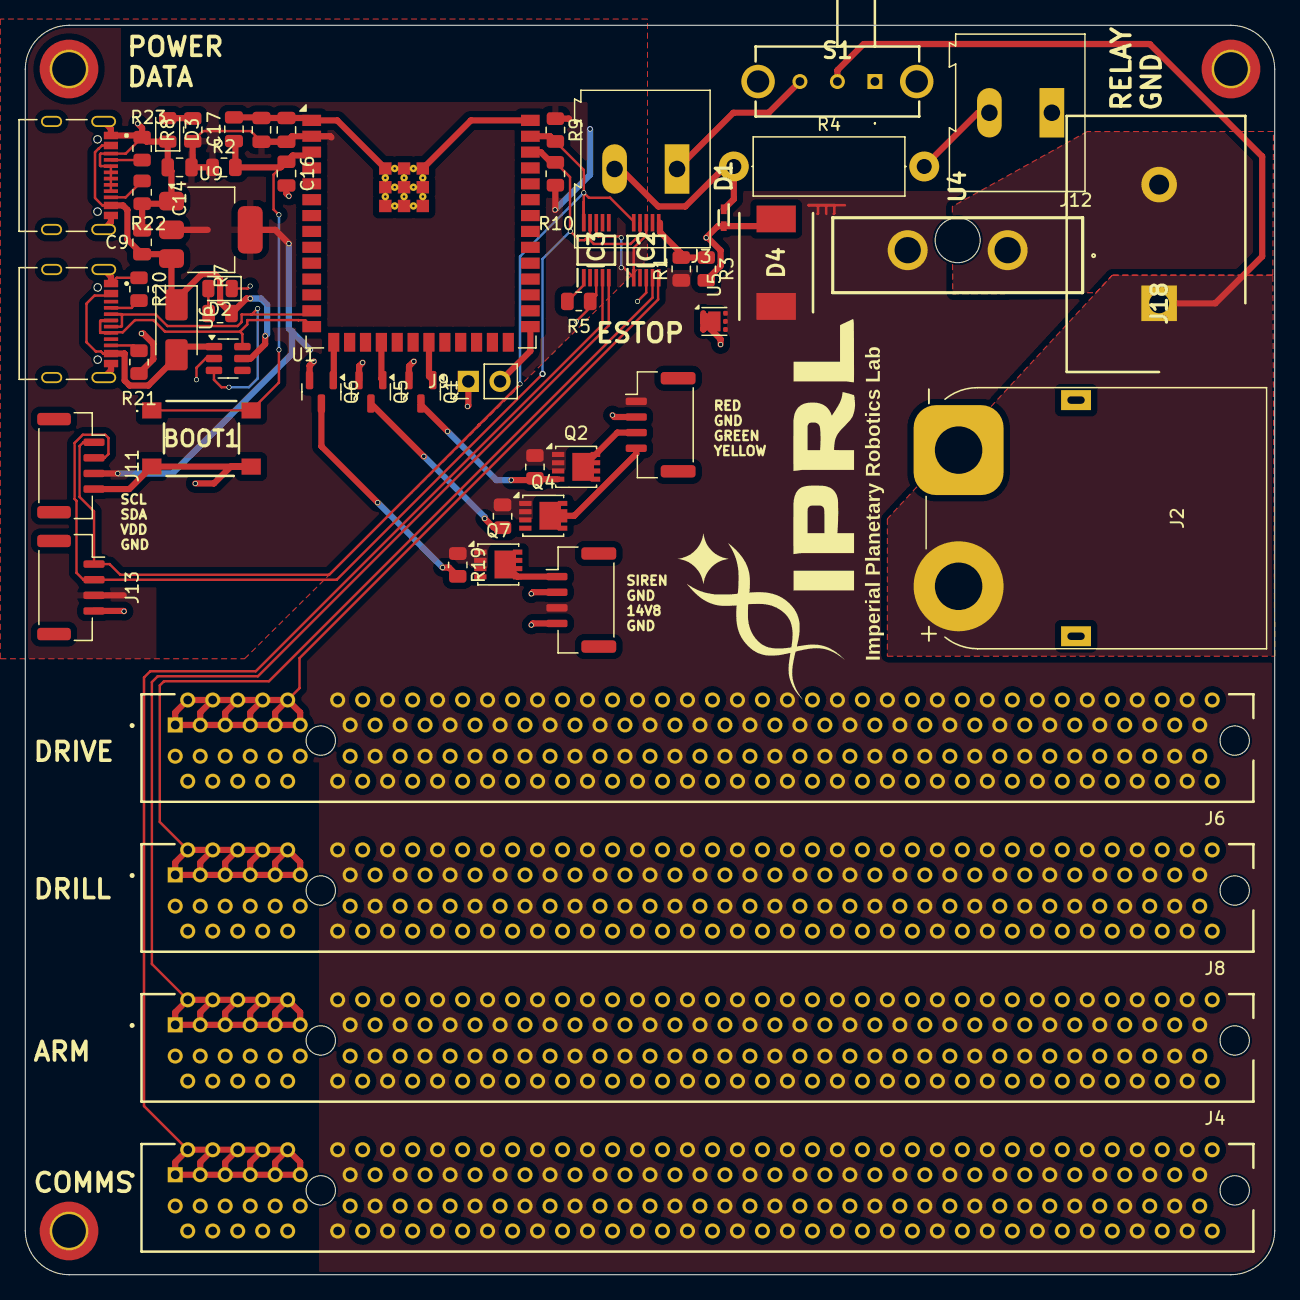
[picture p27: board Power_V2_main.kicad_pcb from above]

Board: 2 copper layers, 100.0 x 100.0 mm, 60 parts (0 on the bottom side), 37 nets.
