ICRS/IPRL-Electronics-Hardware/PCBs/XT60-Splitter/XT60-Splitter.kicad_pcb

## KiCad design PCBs/XT60-Splitter/XT60-Splitter.kicad_pcb (2025-05-20)

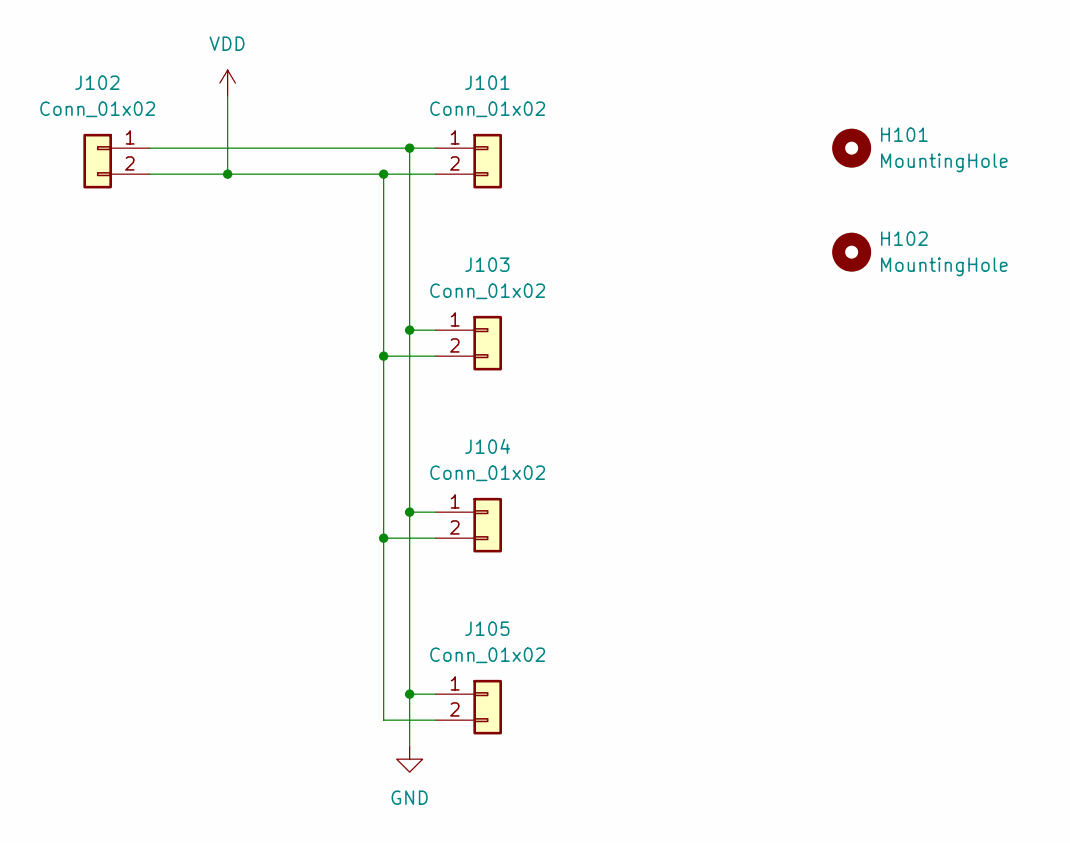
[picture p28: schematic XT60-Splitter.kicad_sch]

Parts:
H101, H102: MountingHole; MountingHole_3.2mm_M3_Pad
J101, J103, J104, J105: Conn_01x02; AMASS_XT60-F_1x02_P7.20mm_Vertical
J102: Conn_01x02; AMASS_XT60-M_1x02_P7.20mm_Vertical

Connections:
GND: J101.1, J102.1, J103.1, J104.1, J105.1
VDD: J101.2, J102.2, J103.2, J104.2, J105.2

Board: 2 copper layers, 7 parts (0 on the bottom side), 2 nets, no tracks yet.
