ICRS/IPRL-Electronics-Hardware/PCBs/Power_PCB/Power_PCB/Power_PCB.kicad_pcb

## KiCad design PCBs/Power_PCB/Power_PCB/Power_PCB.kicad_pcb (2025-04-04)

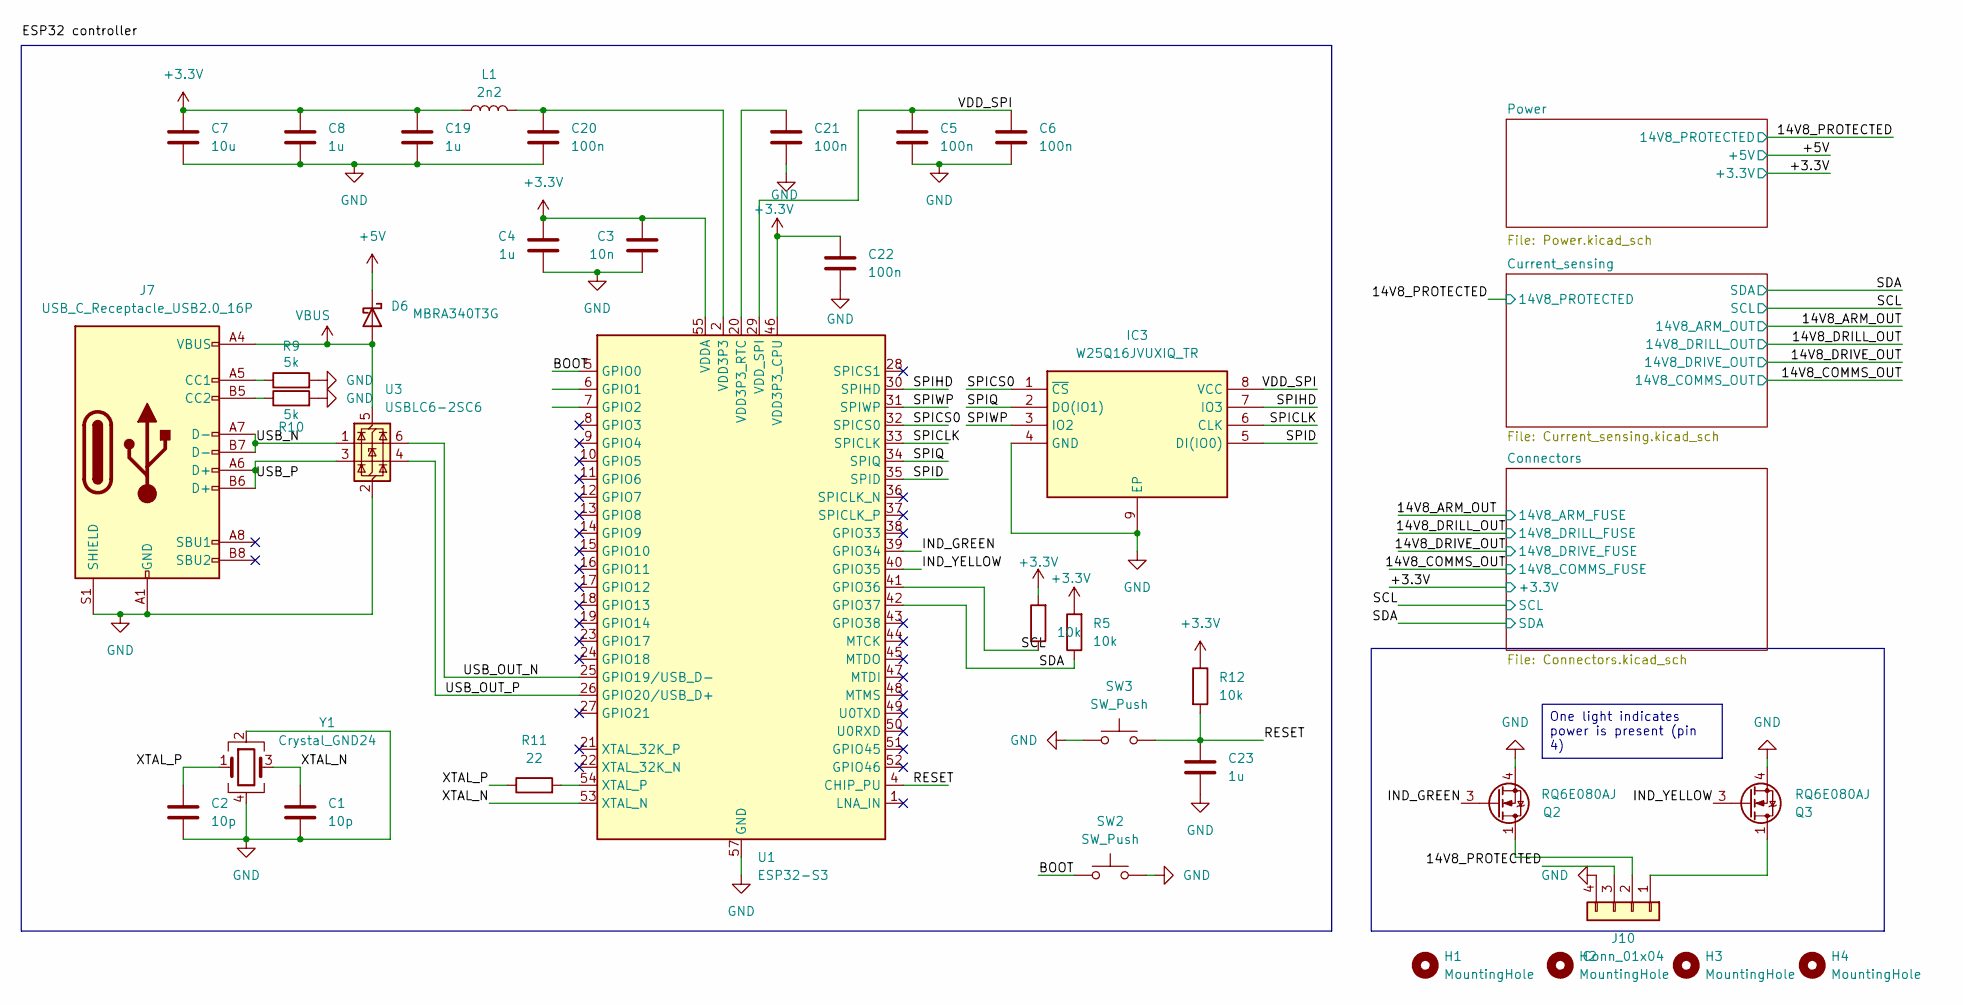
[picture p29: schematic Power_PCB.kicad_sch]

Parts:
C1, C2: 10p; C_0805_2012Metric
C3: 10n; C_0805_2012Metric
C4, C8, C19, C23: 1u; C_0805_2012Metric
C5, C6, C20, C21, C22: 100n; C_0805_2012Metric
C7: 10u; C_0805_2012Metric
D6: MBRA340T3G; D_SMA
H1, H2, H3, H4: MountingHole; MountingHole_3.2mm_M3
IC3: W25Q16JVUXIQ_TR; SON50P300X200X60-9N; Manufacturer_Part_Number W25Q16JVUXIQ TR; Mouser Part Number 454-W25Q16JVUXIQTR
J7: USB_C_Receptacle_USB2.0_16P; TYPE-C-31-M-12
J10: Conn_01x04; TerminalBlock_Altech_AK300-4_P5.00mm
L1: 2n2; L_0805_2012Metric
Q2, Q3: RQ6E080AJ; TSOT-23-6
R5, R6, R12: 10k; R_0805_2012Metric
R9, R10: 5k; R_0805_2012Metric
R11: 22; R_0805_2012Metric
SW2, SW3: SW_Push; SW_Push_1P1T_NO_CK_KSC6xxJ
U1: ESP32-S3; QFN-56-1EP_7x7mm_P0.4mm_EP4x4mm
U3: USBLC6-2SC6; SOT-23-6
Y1: Crystal_GND24; Crystal_SMD_SeikoEpson_FA238-4Pin_3.2x2.5mm

Connections:
+3.3V: C3.1, C4.1, C7.1, C8.1, C19.1, C22.1, L1.1, R5.2, R6.2, R12.1, U1.46 (VDD3P3_CPU), U1.55 (VDDA), U1.56 (VDDA); also elsewhere on the board
+5V: D6.1 (K); also elsewhere on the board
/14V8_PROTECTED: J10.3; also elsewhere on the board
/BOOT: SW2.1, U1.5 (GPIO0)
/IND_GREEN: Q2.3 (G), U1.39 (GPIO34)
/IND_YELLOW: Q3.3 (G), U1.40 (GPIO35)
/RESET: C23.1, R12.2, SW3.2, U1.4 (CHIP_PU)
/SCL: R6.1, U1.41 (GPIO36); also elsewhere on the board
/SDA: R5.1, U1.42 (GPIO37); also elsewhere on the board
/SPICLK: IC3.6 (CLK), U1.33 (SPICLK)
/SPICS0: IC3.1 (~CS), U1.32 (SPICS0)
/SPID: IC3.5 (DI(IO0)), U1.35 (SPID)
/SPIHD: IC3.7 (IO3), U1.30 (SPIHD)
/SPIQ: IC3.2 (DO(IO1)), U1.34 (SPIQ)
/SPIWP: IC3.3 (IO2), U1.31 (SPIWP)
/USB_N: J7.A7 (D-), J7.B7 (D-), U3.1 (I/O1)
/USB_OUT_N: U1.25 (GPIO19/USB_D-), U3.6 (I/O1)
/USB_OUT_P: U1.26 (GPIO20/USB_D+), U3.4 (I/O2)
/USB_P: J7.A6 (D+), J7.B6 (D+), U3.3 (I/O2)
/VDD_SPI: C5.1, C6.1, IC3.8 (VCC), U1.29 (VDD_SPI)
/XTAL_N: C1.1, U1.53 (XTAL_N), Y1.3
/XTAL_P: C2.1, R11.1, Y1.1
GND: C1.2, C2.2, C3.2, C4.2, C5.2, C6.2, C7.2, C8.2, C19.2, C20.2, C21.2, C22.2, C23.2, IC3.4 (GND), IC3.9 (EP), J7.A1 (GND), J7.A12 (GND), J7.B1 (GND), J7.B12 (GND), J7.S1 (SHIELD), J10.4, Q2.4 (S), Q3.4 (S), R9.2, R10.2, SW2.2, SW3.1, U1.57 (GND), U3.2 (GND), Y1.2, Y1.4; also elsewhere on the board
unnamed: C20.1, L1.2, U1.2 (VDD3P3), U1.3 (VDD3P3)
unnamed: J7.A5 (CC1), R9.1
unnamed: J7.B5 (CC2), R10.1
unnamed: J10.1, Q3.1 (D), Q3.2 (D), Q3.5 (D), Q3.6 (D)
unnamed: J10.2, Q2.1 (D), Q2.2 (D), Q2.5 (D), Q2.6 (D)
unnamed: C21.1, U1.20 (VDD3P3_RTC)
unnamed: R11.2, U1.54 (XTAL_P)
VBUS: D6.2 (A), J7.A4 (VBUS), J7.A9 (VBUS), J7.B4 (VBUS), J7.B9 (VBUS), U3.5 (VBUS)

Notes on the sheet:
One light indicates power is present (pin 4)

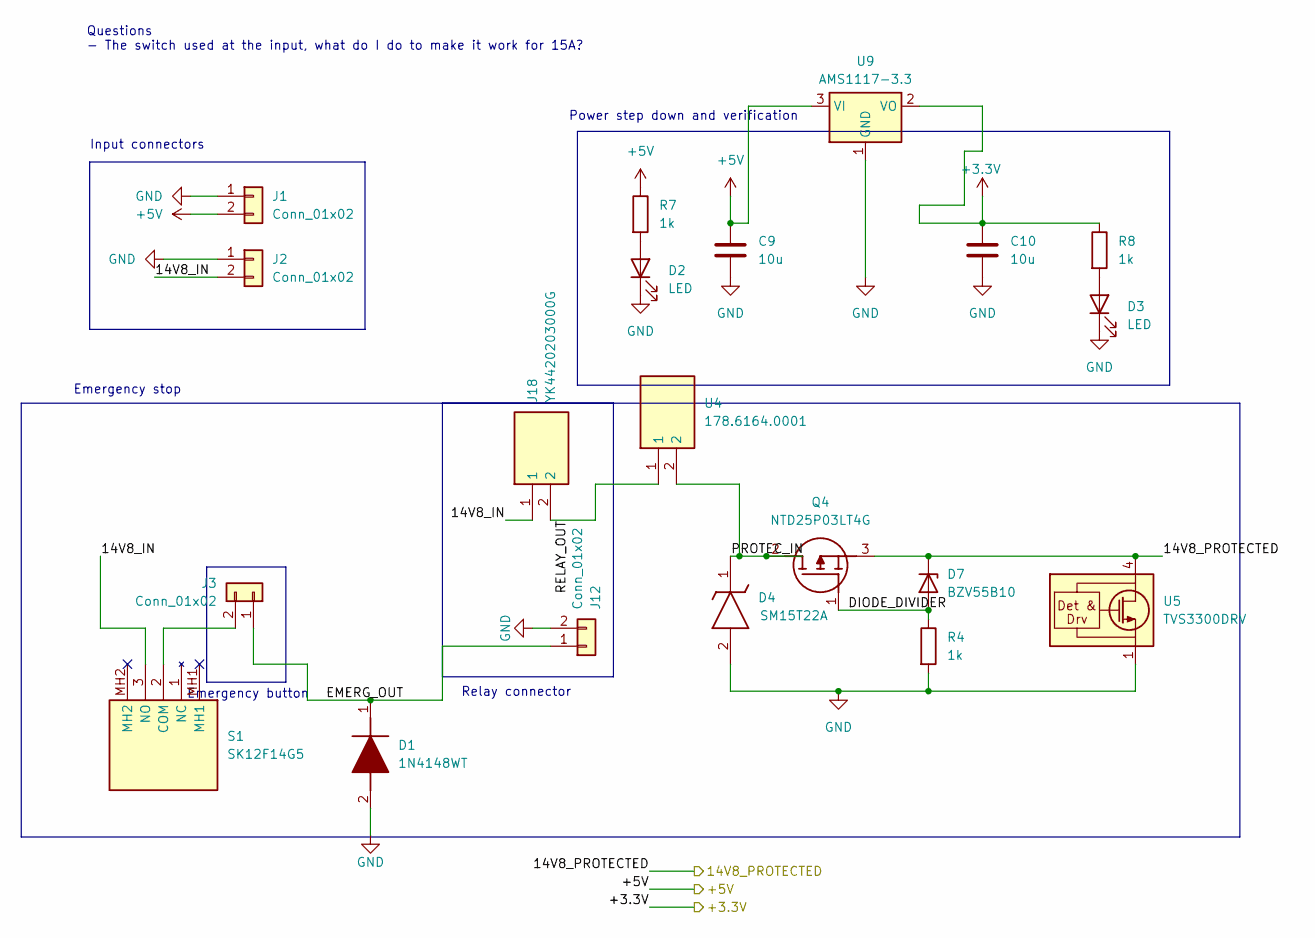
[picture p30: schematic Power.kicad_sch]

Parts:
C9, C10: 10u; C_0805_2012Metric
D1: 1N4148WT; SODFL1608X70N; Manufacturer_Part_Number 1N4148WT
D2, D3: LED; LED_0805_2012Metric
D4: SM15T22A; DIOM8059X265N; Manufacturer_Part_Number SM15T22A; Mouser Part Number 511-SM15T22A
D7: BZV55B10; D_MiniMELF
J1, J3, J12: Conn_01x02; TerminalBlock_Altech_AK300-2_P5.00mm
J2: Conn_01x02; AMASS_XT90PW-M_1x02_P10.90mm_Horizontal
J18: YK4420203000G; RHDR2W120P0X950_1X2_2050X1430X1790P; Manufacturer_Part_Number YK4420203000G; Mouser Part Number 649-YK44202030J0G
Q4: NTD25P03LT4G; MJD45H11T4G; Manufacturer_Part_Number NTD25P03LT4G; Mouser Part Number 863-NTD25P03LT4G
R4, R7, R8: 1k; R_0805_2012Metric
S1: SK12F14G5; Manufacturer_Part_Number SK12F14G5; Mouser Part Number 611-SK12F14G5
U4: 178.6164.0001; 178.6164.XXX1; Mouser Part Number 576-178.6164.0001
U5: TVS3300DRV; WSON-6-1EP_2x2mm_P0.65mm_EP1x1.6mm
U9: AMS1117-3.3; SOT-223-3_TabPin2

Connections:
+3.3V: C10.1, R8.1, U9.2 (VO); also elsewhere on the board
+5V: C9.1, J1.2, R7.1, U9.3 (VI); also elsewhere on the board
/14V8_PROTECTED: D7.1 (K), Q4.3 (S), U5.4 (IN), U5.5 (IN), U5.6 (IN); also elsewhere on the board
/Power/14V8_IN: J2.2, J18.1, S1.3 (NO)
/Power/DIODE_DIVIDER: D7.2 (A), Q4.1 (G), R4.1
/Power/EMERG_OUT: D1.1 (K), J3.1, J12.1
/Power/PROTEC_IN: D4.1 (K), Q4.2 (D), U4.2
/Power/RELAY_OUT: J18.2, U4.1
GND: C9.2, C10.2, D1.2 (A), D2.1 (K), D3.1 (K), D4.2 (A), J1.1, J2.1, J12.2, R4.2, U5.1 (GND), U5.2 (GND), U5.3 (GND), U5.7 (GND), U9.1 (GND); also elsewhere on the board
unnamed: D2.2 (A), R7.2
unnamed: D3.2 (A), R8.2
unnamed: J3.2, S1.2 (COM)

Notes on the sheet:
Emergency button
Input connectors
Questions - The switch used at the input, what do I do to make it work for 15A?
Emergency stop
Relay connector
Power step down and verification

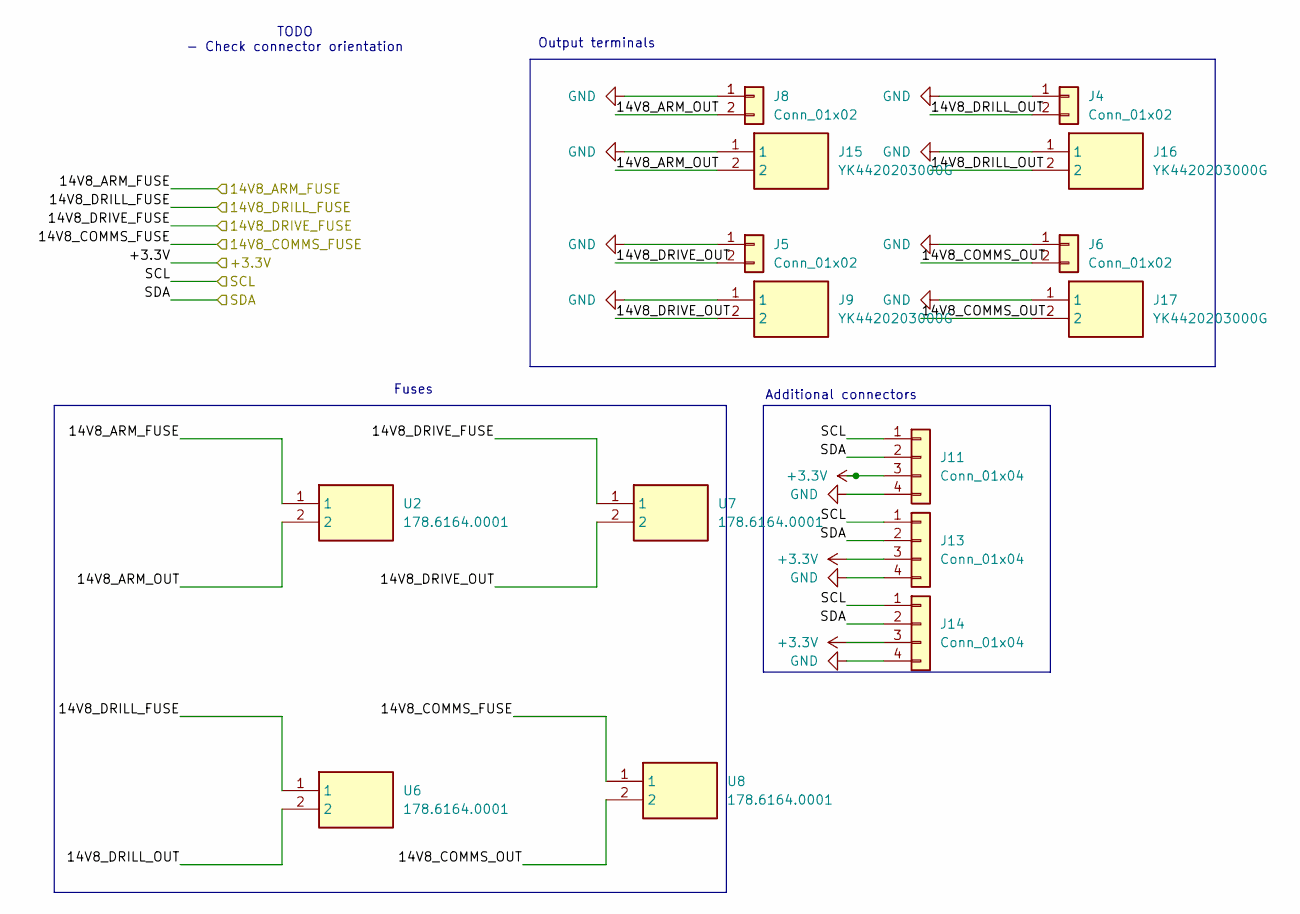
[picture p31: schematic Connectors.kicad_sch]

Parts:
J4, J5, J6, J8: Conn_01x02; AMASS_XT60PW-F_1x02_P7.20mm_Horizontal
J9, J15, J16, J17: YK4420203000G; RHDR2W120P0X950_1X2_2050X1430X1790P; Manufacturer_Part_Number YK4420203000G; Mouser Part Number 649-YK44202030J0G
J11, J13, J14: Conn_01x04; JST_PH_S4B-PH-K_1x04_P2.00mm_Horizontal
U2, U6, U7, U8: 178.6164.0001; 178.6164.XXX1; Mouser Part Number 576-178.6164.0001

Connections:
+3.3V: J11.3, J13.3, J14.3; also elsewhere on the board
/14V8_ARM_OUT: U2.1; also elsewhere on the board
/14V8_COMMS_OUT: U8.1; also elsewhere on the board
/14V8_DRILL_OUT: U6.1; also elsewhere on the board
/14V8_DRIVE_OUT: U7.1; also elsewhere on the board
/Connectors/14V8_ARM_OUT: J8.2, J15.2, U2.2
/Connectors/14V8_COMMS_OUT: J6.2, J17.2, U8.2
/Connectors/14V8_DRILL_OUT: J4.2, J16.2, U6.2
/Connectors/14V8_DRIVE_OUT: J5.2, J9.2, U7.2
/SCL: J11.1, J13.1, J14.1; also elsewhere on the board
/SDA: J11.2, J13.2, J14.2; also elsewhere on the board
GND: J4.1, J5.1, J6.1, J8.1, J9.1, J11.4, J13.4, J14.4, J15.1, J16.1, J17.1; also elsewhere on the board

Notes on the sheet:
Additional connectors
Fuses
TODO - Check connector orientation
Output terminals

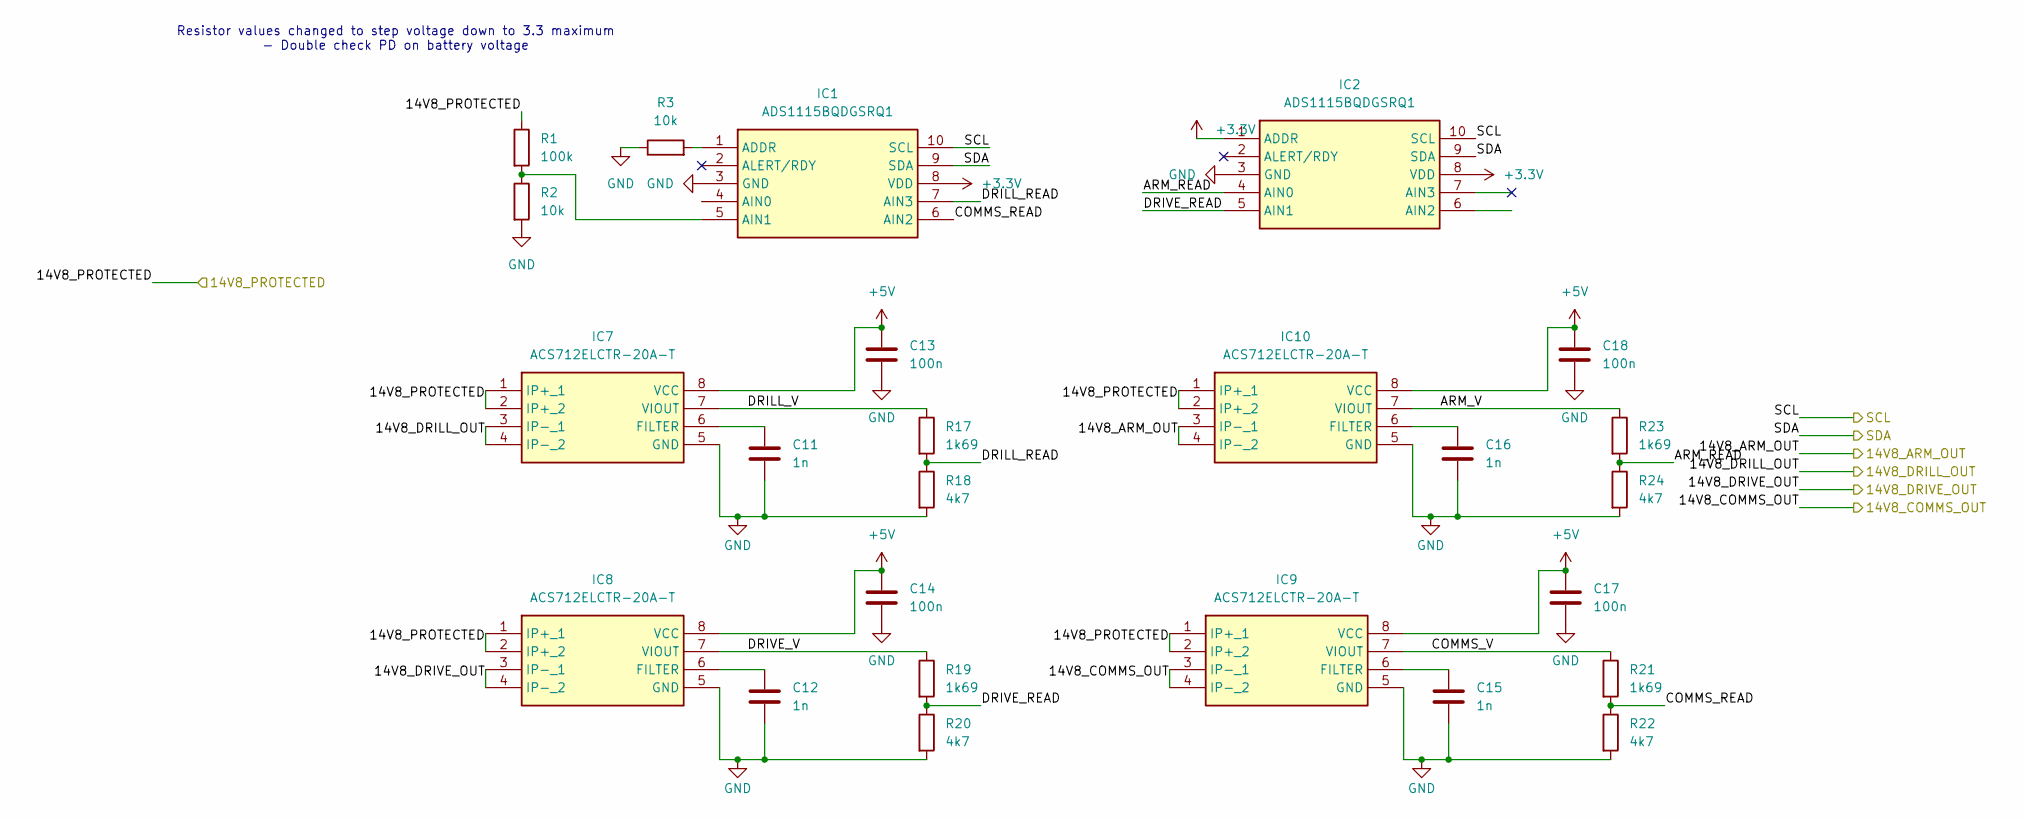
[picture p32: schematic Current_sensing.kicad_sch]

Parts:
C11, C12, C15, C16: 1n; C_0805_2012Metric
C13, C14, C17, C18: 100n; C_0805_2012Metric
IC1, IC2: ADS1115BQDGSRQ1; SOP50P490X110-10N; Mouser Part Number 595-ADS1115BQDGSRQ1
IC7, IC8, IC9, IC10: ACS712ELCTR-20A-T; SOIC127P600X175-8N; Manufacturer_Part_Number ACS712ELCTR-20A-T
R1: 100k; R_0805_2012Metric
R2, R3: 10k; R_0805_2012Metric
R17, R19, R21, R23: 1k69; R_0805_2012Metric
R18, R20, R22, R24: 4k7; R_0805_2012Metric

Connections:
+3.3V: IC1.8 (VDD), IC2.1 (ADDR), IC2.8 (VDD); also elsewhere on the board
+5V: C13.1, C14.1, C17.1, C18.1, IC7.8 (VCC), IC8.8 (VCC), IC9.8 (VCC), IC10.8 (VCC); also elsewhere on the board
/14V8_ARM_OUT: IC10.3 (IP-_1), IC10.4 (IP-_2); also elsewhere on the board
/14V8_COMMS_OUT: IC9.3 (IP-_1), IC9.4 (IP-_2); also elsewhere on the board
/14V8_DRILL_OUT: IC7.3 (IP-_1), IC7.4 (IP-_2); also elsewhere on the board
/14V8_DRIVE_OUT: IC8.3 (IP-_1), IC8.4 (IP-_2); also elsewhere on the board
/14V8_PROTECTED: IC7.1 (IP+_1), IC7.2 (IP+_2), IC8.1 (IP+_1), IC8.2 (IP+_2), IC9.1 (IP+_1), IC9.2 (IP+_2), IC10.1 (IP+_1), IC10.2 (IP+_2), R1.1; also elsewhere on the board
/Current_sensing/ARM_READ: IC2.4 (AIN0), R23.2, R24.1
/Current_sensing/ARM_V: IC10.7 (VIOUT), R23.1
/Current_sensing/COMMS_READ: IC1.6 (AIN2), R21.2, R22.1
/Current_sensing/COMMS_V: IC9.7 (VIOUT), R21.1
/Current_sensing/DRILL_READ: IC1.7 (AIN3), R17.2, R18.1
/Current_sensing/DRILL_V: IC7.7 (VIOUT), R17.1
/Current_sensing/DRIVE_READ: IC2.5 (AIN1), R19.2, R20.1
/Current_sensing/DRIVE_V: IC8.7 (VIOUT), R19.1
/SCL: IC1.10 (SCL), IC2.10 (SCL); also elsewhere on the board
/SDA: IC1.9 (SDA), IC2.9 (SDA); also elsewhere on the board
GND: C11.2, C12.2, C13.2, C14.2, C15.2, C16.2, C17.2, C18.2, IC1.3 (GND), IC2.3 (GND), IC7.5 (GND), IC8.5 (GND), IC9.5 (GND), IC10.5 (GND), R2.2, R3.1, R18.2, R20.2, R22.2, R24.2; also elsewhere on the board
unnamed: IC1.1 (ADDR), R3.2
unnamed: IC1.5 (AIN1), R1.2, R2.1
unnamed: C11.1, IC7.6 (FILTER)
unnamed: C12.1, IC8.6 (FILTER)
unnamed: C15.1, IC9.6 (FILTER)
unnamed: C16.1, IC10.6 (FILTER)

Notes on the sheet:
Resistor values changed to step voltage down to 3.3 maximum - Double check PD on battery voltage

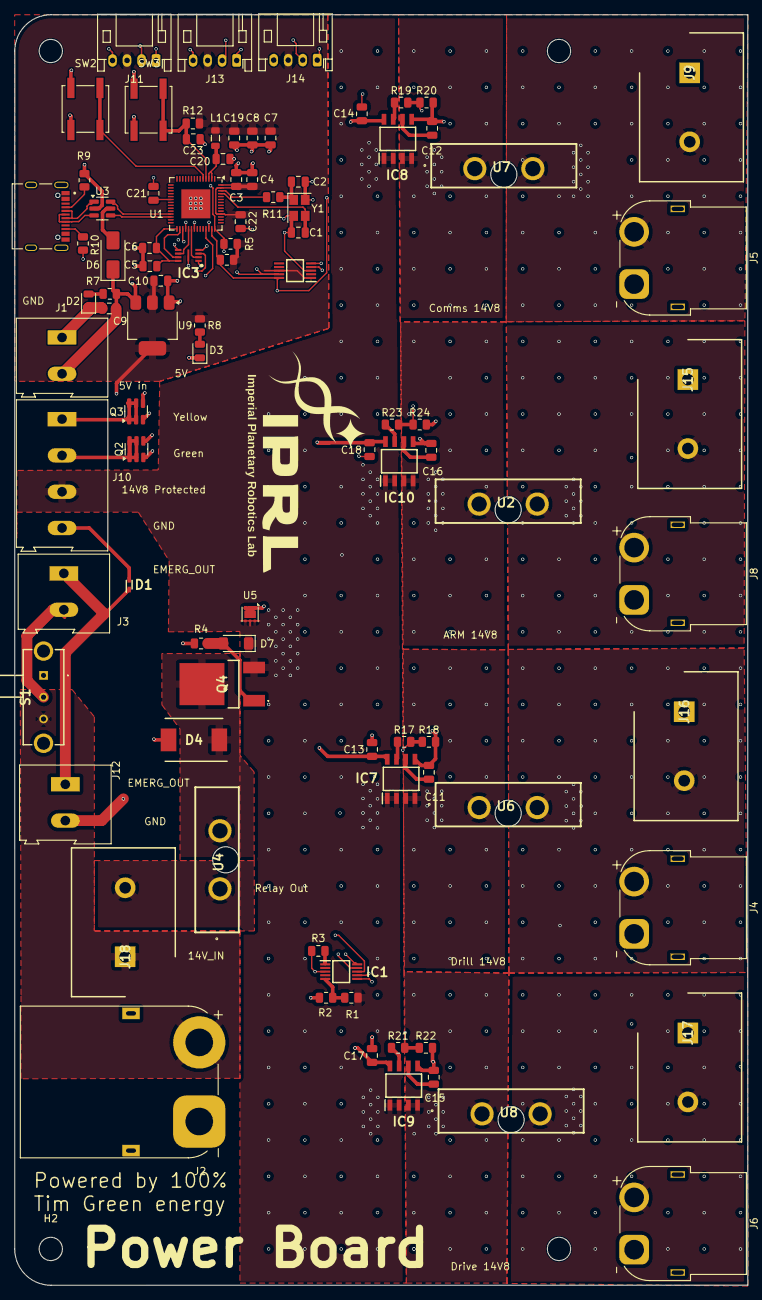
[picture p33: board Power_PCB.kicad_pcb from above]

Board: 4 copper layers, 101.0 x 175.0 mm, 95 parts (0 on the bottom side), 61 nets.
