ICRS/IPRL-Electronics-Hardware/PCBs/Arm power connector/Arm power connector.kicad_pcb

## KiCad design PCBs/Arm power connector/Arm power connector.kicad_pcb (2025-03-30)

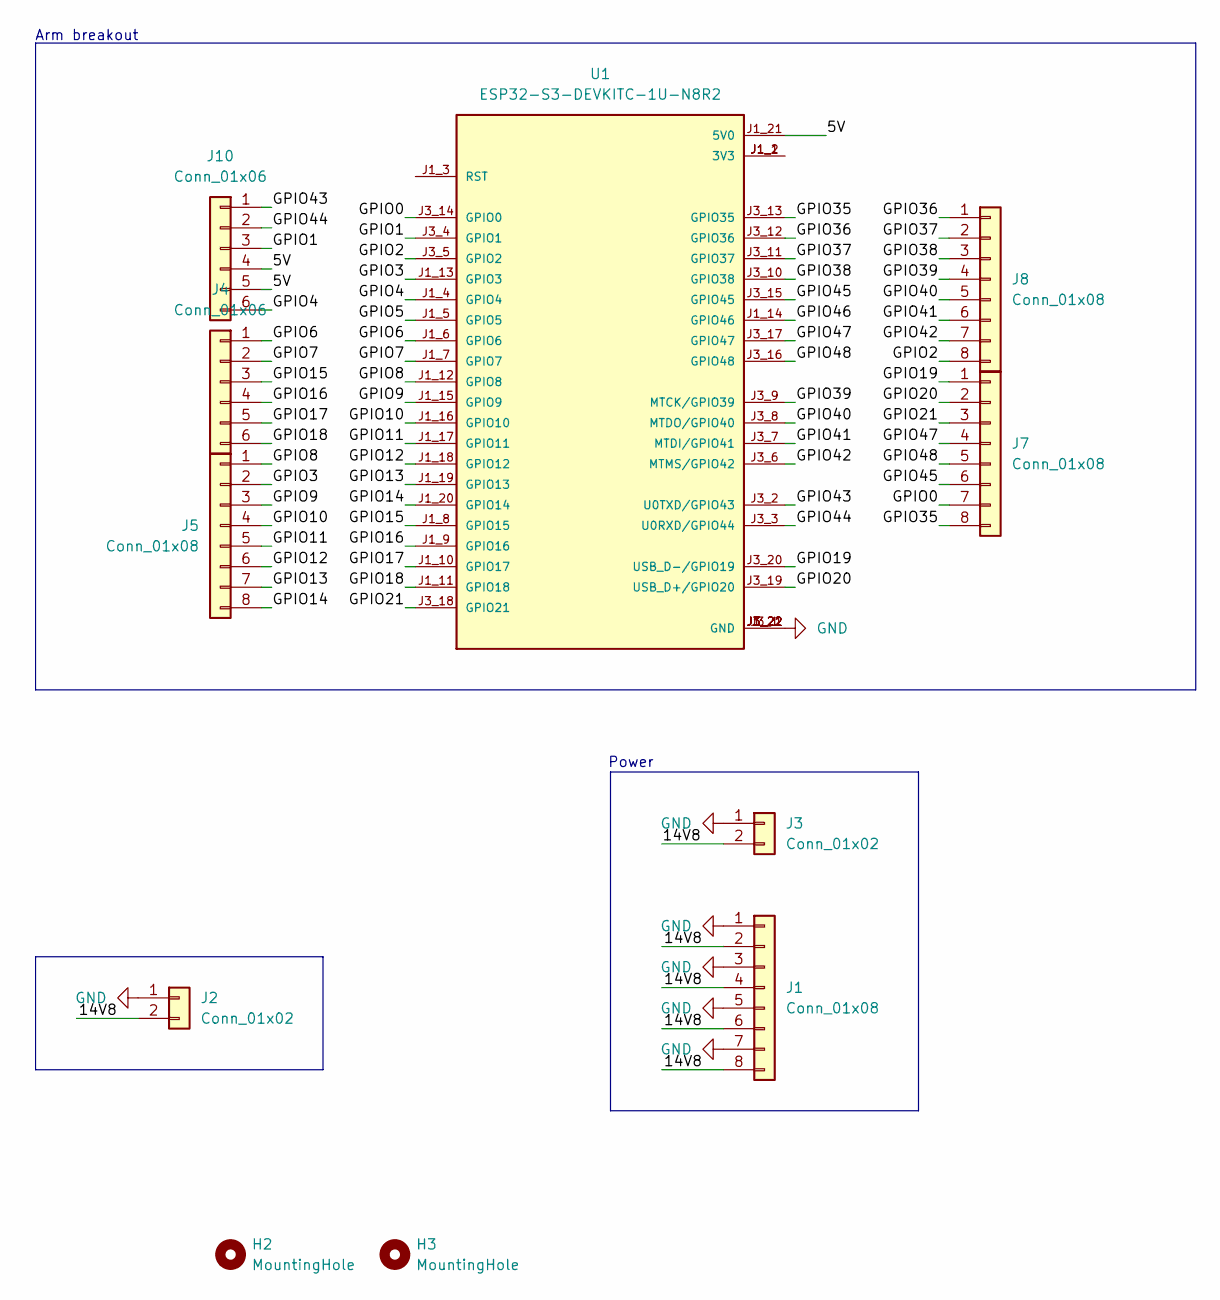
[picture p34: schematic Arm power connector.kicad_sch]

Parts:
H2, H3: MountingHole; MountingHole_3.2mm_M3
J1, J5, J7, J8: Conn_01x08; TerminalBlock_MaiXu_MX126-5.0-08P_1x08_P5.00mm
J2: Conn_01x02; AMASS_XT60PW-M_1x02_P7.20mm_Horizontal
J3: Conn_01x02; TerminalBlock_MaiXu_MX126-5.0-02P_1x02_P5.00mm
J4, J10: Conn_01x06; TerminalBlock_MaiXu_MX126-5.0-06P_1x06_P5.00mm
U1: ESP32-S3-DEVKITC-1U-N8R2; XCVR_ESP32-S3-DEVKITC-1U-N8R2; PARTREV 5.3

Connections:
/5V: J10.4, J10.5, U1.J1_21 (5V0)
/14V8: J1.2, J1.4, J1.6, J1.8, J2.2, J3.2
/GPIO0: J7.7, U1.J3_14 (GPIO0)
/GPIO1: J10.3, U1.J3_4 (GPIO1)
/GPIO2: J8.8, U1.J3_5 (GPIO2)
/GPIO3: J5.2, U1.J1_13 (GPIO3)
/GPIO4: J10.6, U1.J1_4 (GPIO4)
/GPIO5: U1.J1_5 (GPIO5)
/GPIO6: J4.1, U1.J1_6 (GPIO6)
/GPIO7: J4.2, U1.J1_7 (GPIO7)
/GPIO8: J5.1, U1.J1_12 (GPIO8)
/GPIO9: J5.3, U1.J1_15 (GPIO9)
/GPIO10: J5.4, U1.J1_16 (GPIO10)
/GPIO11: J5.5, U1.J1_17 (GPIO11)
/GPIO12: J5.6, U1.J1_18 (GPIO12)
/GPIO13: J5.7, U1.J1_19 (GPIO13)
/GPIO14: J5.8, U1.J1_20 (GPIO14)
/GPIO15: J4.3, U1.J1_8 (GPIO15)
/GPIO16: J4.4, U1.J1_9 (GPIO16)
/GPIO17: J4.5, U1.J1_10 (GPIO17)
/GPIO18: J4.6, U1.J1_11 (GPIO18)
/GPIO19: J7.1, U1.J3_20 (USB_D-/GPIO19)
/GPIO20: J7.2, U1.J3_19 (USB_D+/GPIO20)
/GPIO21: J7.3, U1.J3_18 (GPIO21)
/GPIO35: J7.8, U1.J3_13 (GPIO35)
/GPIO36: J8.1, U1.J3_12 (GPIO36)
/GPIO37: J8.2, U1.J3_11 (GPIO37)
/GPIO38: J8.3, U1.J3_10 (GPIO38)
/GPIO39: J8.4, U1.J3_9 (MTCK/GPIO39)
/GPIO40: J8.5, U1.J3_8 (MTDO/GPIO40)
/GPIO41: J8.6, U1.J3_7 (MTDI/GPIO41)
/GPIO42: J8.7, U1.J3_6 (MTMS/GPIO42)
/GPIO43: J10.1, U1.J3_2 (U0TXD/GPIO43)
/GPIO44: J10.2, U1.J3_3 (U0RXD/GPIO44)
/GPIO45: J7.6, U1.J3_15 (GPIO45)
/GPIO46: U1.J1_14 (GPIO46)
/GPIO47: J7.4, U1.J3_17 (GPIO47)
/GPIO48: J7.5, U1.J3_16 (GPIO48)
GND: J1.1, J1.3, J1.5, J1.7, J2.1, J3.1, U1.J1_22 (GND), U1.J3_1 (GND), U1.J3_21 (GND), U1.J3_22 (GND)
unnamed: U1.J1_1 (3V3), U1.J1_2 (3V3)

Notes on the sheet:
Arm breakout
Power

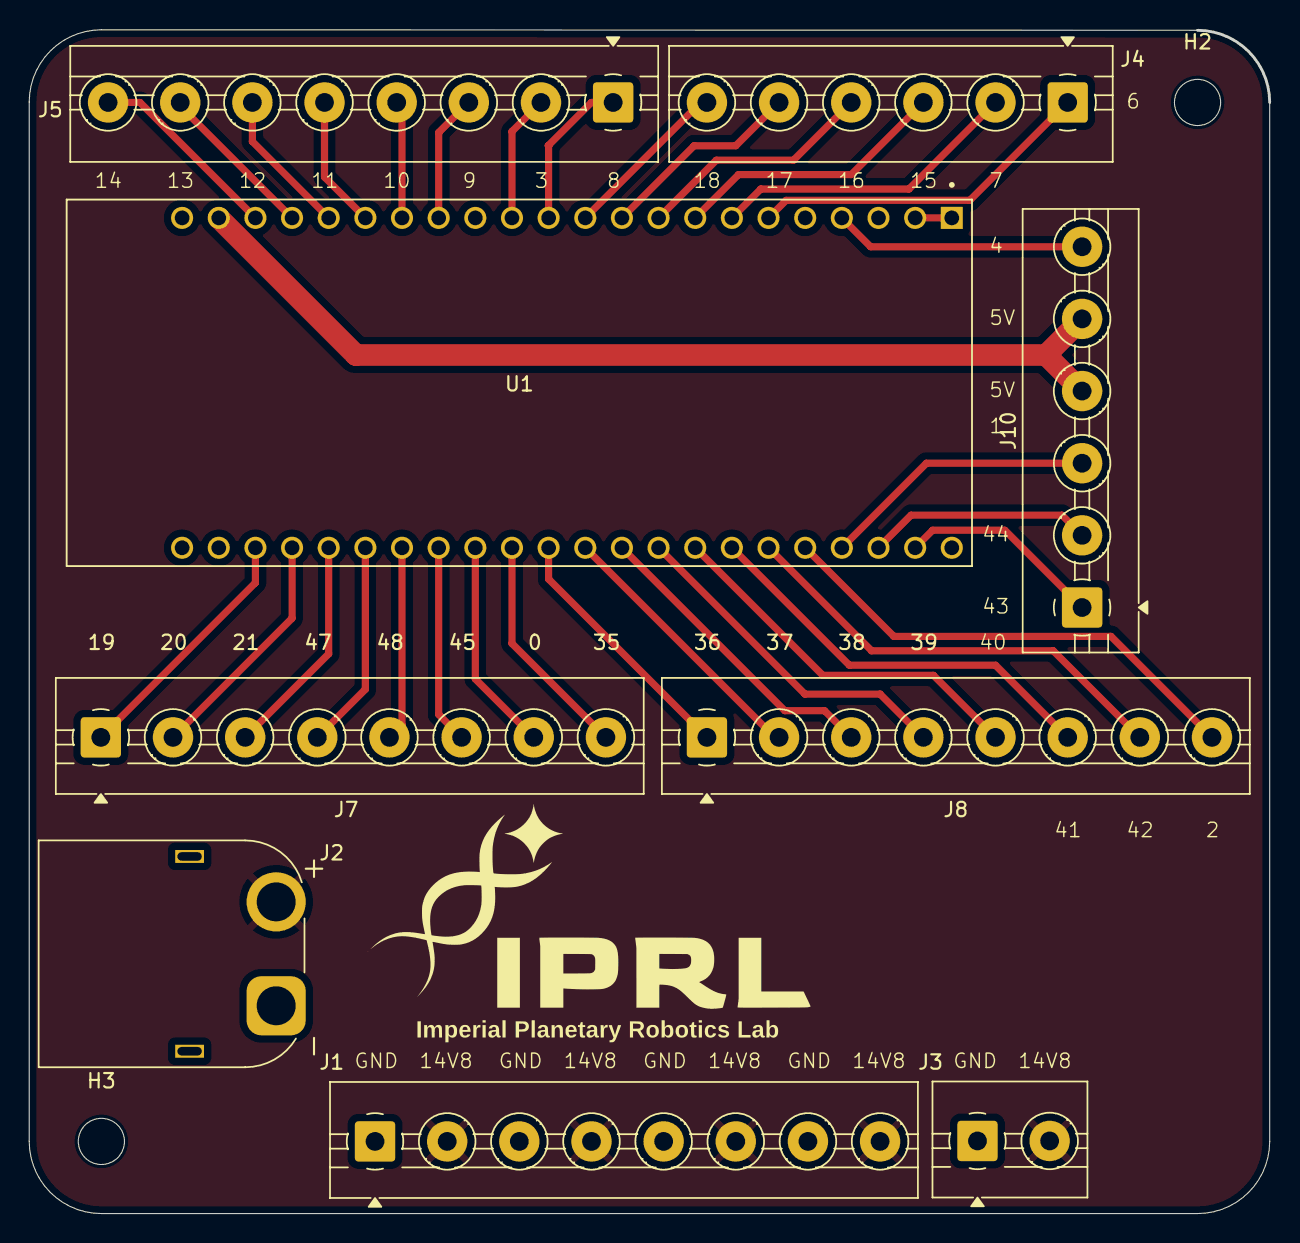
[picture p35: board Arm power connector.kicad_pcb from above]

Board: 2 copper layers, 86.0 x 82.0 mm, 11 parts (0 on the bottom side), 38 nets.
