ICRS/IPRL-Electronics-Hardware/PCBs/Arm Schematic/Arm Schematic.kicad_pcb

## KiCad design PCBs/Arm Schematic/Arm Schematic.kicad_pcb (2025-01-17, an earlier design)

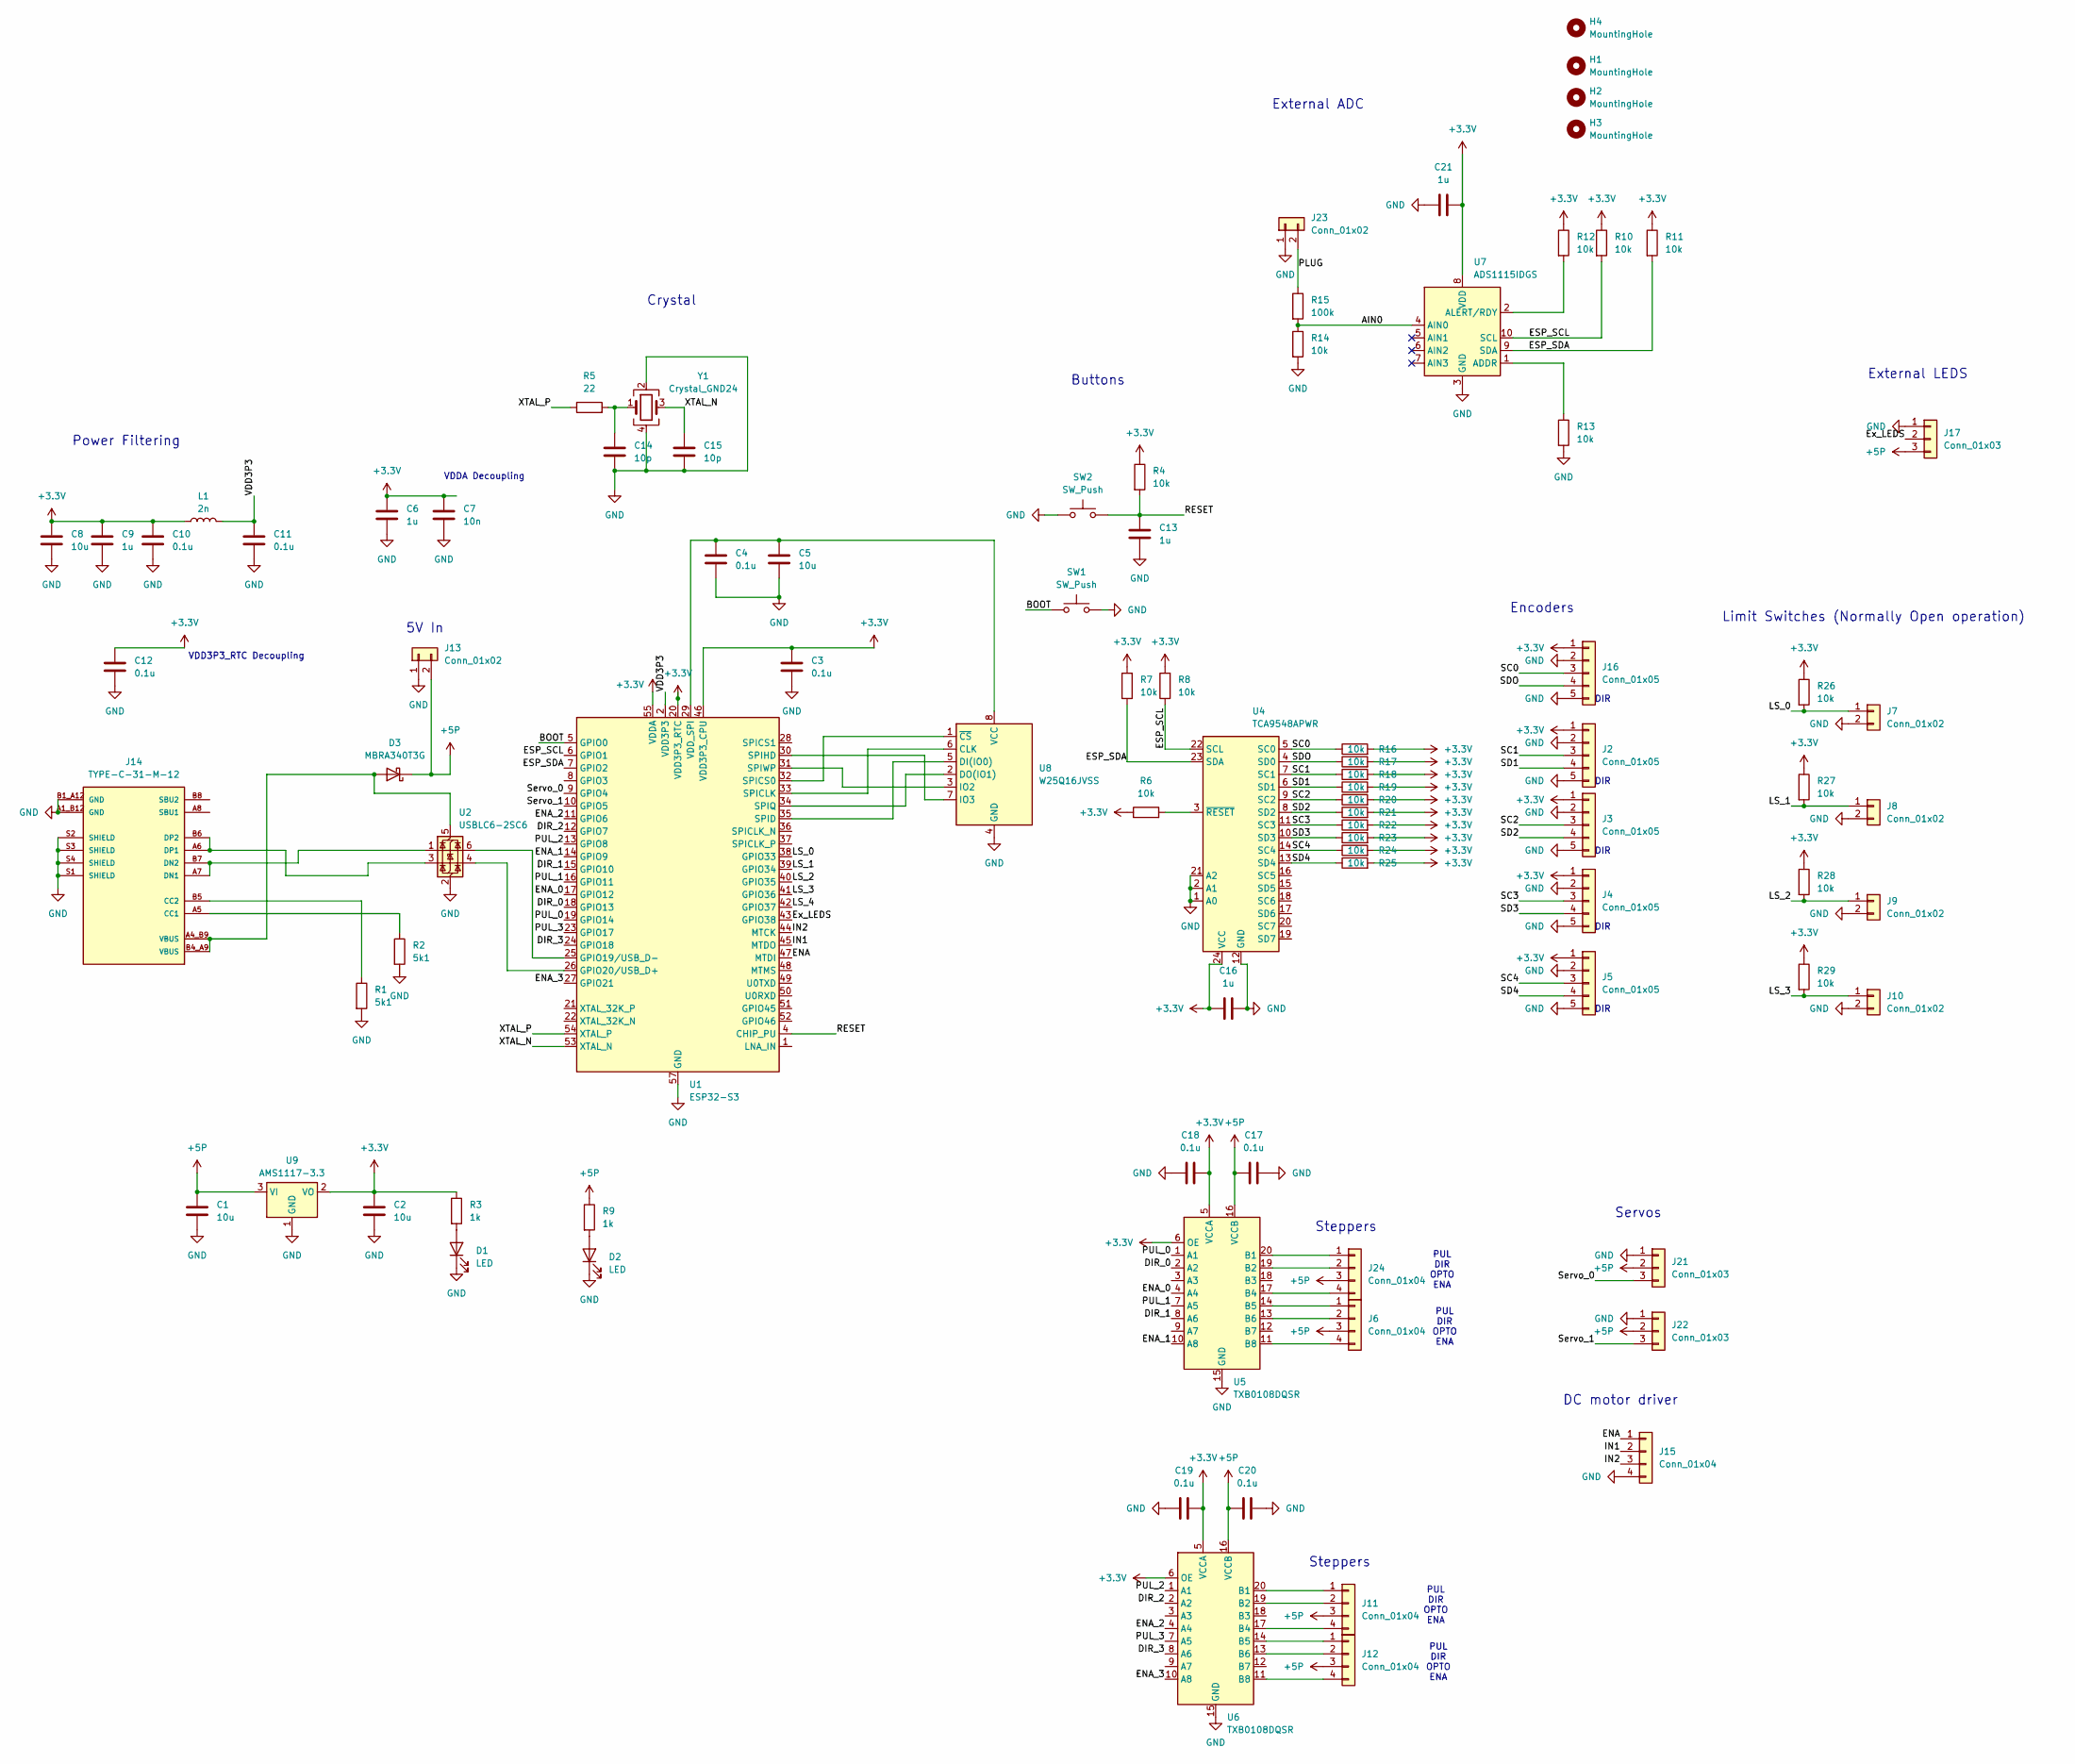
[picture p36: schematic Arm Schematic.kicad_sch]

Parts:
C1, C2, C5, C8: 10u; C_0805_2012Metric
C3, C4, C10, C11, C12, C17, C18, C19, C20: 0.1u; C_0805_2012Metric
C6, C9, C13, C16, C21: 1u; C_0805_2012Metric
C7: 10n; C_0805_2012Metric
C14, C15: 10p; C_0805_2012Metric
D1, D2: LED; LED_0805_2012Metric
D3: MBRA340T3G; D_SMA
H1, H2, H3, H4: MountingHole; MountingHole_3.2mm_M3
J2, J3, J4, J5, J16: Conn_01x05; JST_GH_BM05B-GHS-TBT_1x05-1MP_P1.25mm_Vertical
J6, J11, J12, J15, J24: Conn_01x04; JST_GH_BM04B-GHS-TBT_1x04-1MP_P1.25mm_Vertical
J7, J8, J9, J10: Conn_01x02; JST_GH_BM02B-GHS-TBT_1x02-1MP_P1.25mm_Vertical
J13: Conn_01x02; AMASS_XT30U-M_1x02_P5.0mm_Vertical
J14: TYPE-C-31-M-12; PARTREV 2020.12.08
J17, J21, J22: Conn_01x03; JST_GH_BM03B-GHS-TBT_1x03-1MP_P1.25mm_Vertical
J23: Conn_01x02; AMASS_XT60-M_1x02_P7.20mm_Vertical
L1: 2n; L_0805_2012Metric
R1, R2: 5k1; R_0805_2012Metric
R3, R9: 1k; R_0805_2012Metric
R4, R6, R7, R8, R10, R11, R12, R13, R14, R16, R17, R18, R19, R20, R21, R22, R23, R24, R25, R26, R27, R28, R29: 10k; R_0805_2012Metric
R5: 22; R_0805_2012Metric
R15: 100k; R_0805_2012Metric
SW1, SW2: SW_Push; SW_Push_1P1T_NO_CK_KSC6xxJ
U1: ESP32-S3; QFN-56-1EP_7x7mm_P0.4mm_EP4x4mm
U2: USBLC6-2SC6; SOT-23-6
U4: TCA9548APWR; TSSOP-24_4.4x7.8mm_P0.65mm
U5, U6: TXB0108DQSR; USON-20_2x4mm_P0.4mm
U7: ADS1115IDGS; TSSOP-10_3x3mm_P0.5mm
U8: W25Q16JVSS; SOIC-8_5.23x5.23mm_P1.27mm
U9: AMS1117-3.3; SOT-223-3_TabPin2
Y1: Crystal_GND24; Crystal_SMD_SeikoEpson_FA238-4Pin_3.2x2.5mm

Connections:
+3.3V: C2.1, C3.1, C6.1, C7.1, C8.1, C9.1, C10.1, C12.2, C16.2, C18.1, C19.1, C21.2, J2.1, J3.1, J4.1, J5.1, J16.1, L1.1, R3.1, R4.1, R6.1, R7.2, R8.2, R10.1, R11.1, R12.1, R16.2, R17.2, R18.2, R19.2, R20.2, R21.2, R22.2, R23.2, R24.2, R25.2, R26.1, R27.1, R28.1, R29.1, U1.20 (VDD3P3_RTC), U1.46 (VDD3P3_CPU), U1.55 (VDDA), U1.56 (VDDA), U4.24 (VCC), U5.5 (VCCA), U5.6 (OE), U6.5 (VCCA), U6.6 (OE), U7.8 (VDD), U9.2 (VO)
+5P: C1.1, C17.2, C20.2, D3.1 (K), J6.3, J11.3, J12.3, J13.2, J17.3, J21.2, J22.2, J24.3, R9.1, U5.16 (VCCB), U6.16 (VCCB), U9.3 (VI)
/AIN0: R14.1, R15.2, U7.4 (AIN0)
/BOOT: SW1.1, U1.5 (GPIO0)
/DIR_0: U1.18 (GPIO13), U5.2 (A2)
/DIR_1: U1.15 (GPIO10), U5.8 (A6)
/DIR_2: U1.12 (GPIO7), U6.2 (A2)
/DIR_3: U1.24 (GPIO18), U6.8 (A6)
/ENA: J15.1, U1.47 (MTDI)
/ENA_0: U1.17 (GPIO12), U5.4 (A4)
/ENA_1: U1.14 (GPIO9), U5.10 (A8)
/ENA_2: U1.11 (GPIO6), U6.4 (A4)
/ENA_3: U1.27 (GPIO21), U6.10 (A8)
/ESP_SCL: R8.1, R10.2, U1.6 (GPIO1), U4.22 (SCL), U7.10 (SCL)
/ESP_SDA: R7.1, R11.2, U1.7 (GPIO2), U4.23 (SDA), U7.9 (SDA)
/Ex_LEDS: J17.2, U1.43 (GPIO38)
/IN1: J15.2, U1.45 (MTDO)
/IN2: J15.3, U1.44 (MTCK)
/LS_0: J7.1, R26.2, U1.38 (GPIO33)
/LS_1: J8.1, R27.2, U1.39 (GPIO34)
/LS_2: J9.1, R28.2, U1.40 (GPIO35)
/LS_3: J10.1, R29.2, U1.41 (GPIO36)
/LS_4: U1.42 (GPIO37)
/PLUG: J23.2, R15.1
/PUL_0: U1.19 (GPIO14), U5.1 (A1)
/PUL_1: U1.16 (GPIO11), U5.7 (A5)
/PUL_2: U1.13 (GPIO8), U6.1 (A1)
/PUL_3: U1.23 (GPIO17), U6.7 (A5)
/RESET: C13.1, R4.2, SW2.2, U1.4 (CHIP_PU)
/SC0: J16.3, R16.1, U4.5 (SC0)
/SC1: J2.3, R18.1, U4.7 (SC1)
/SC2: J3.3, R20.1, U4.9 (SC2)
/SC3: J4.3, R22.1, U4.11 (SC3)
/SC4: J5.3, R24.1, U4.14 (SC4)
/SD1: J2.4, R19.1, U4.6 (SD1)
/SD2: J3.4, R21.1, U4.8 (SD2)
/SD3: J4.4, R23.1, U4.10 (SD3)
/SD4: J5.4, R25.1, U4.13 (SD4)
/SDO: J16.4, R17.1, U4.4 (SD0)
/Servo_0: J21.3, U1.9 (GPIO4)
/Servo_1: J22.3, U1.10 (GPIO5)
/VDD3P3: C11.1, L1.2, U1.2 (VDD3P3), U1.3 (VDD3P3)
/XTAL_N: C15.1, U1.53 (XTAL_N), Y1.3
/XTAL_P: R5.1, U1.54 (XTAL_P)
GND: C1.2, C2.2, C3.2, C4.2, C5.2, C6.2, C7.2, C8.2, C9.2, C10.2, C11.2, C12.1, C13.2, C14.2, C15.2, C16.1, C17.1, C18.2, C19.2, C20.1, C21.1, D1.1 (K), D2.1 (K), J2.2, J2.5, J3.2, J3.5, J4.2, J4.5, J5.2, J5.5, J7.2, J8.2, J9.2, J10.2, J13.1, J14.A1_B12 (GND), J14.B1_A12 (GND), J14.S1 (SHIELD), J14.S2 (SHIELD), J14.S3 (SHIELD), J14.S4 (SHIELD), J15.4, J16.2, J16.5, J17.1, J21.1, J22.1, J23.1, R1.2, R2.2, R13.2, R14.2, SW1.2, SW2.1, U1.57 (GND), U2.2 (GND), U4.1 (A0), U4.2 (A1), U4.12 (GND), U4.21 (A2), U5.15 (GND), U6.15 (GND), U7.3 (GND), U8.4 (GND), U9.1 (GND), Y1.2, Y1.4
unnamed: C14.1, R5.2, Y1.1
unnamed: D1.2 (A), R3.2
unnamed: D2.2 (A), R9.2
unnamed: D3.2 (A), J14.A4_B9 (VBUS), J14.B4_A9 (VBUS), U2.5 (VBUS)
unnamed: J6.1, U5.14 (B5)
unnamed: J6.2, U5.13 (B6)
unnamed: J6.4, U5.11 (B8)
unnamed: J11.1, U6.20 (B1)
unnamed: J11.2, U6.19 (B2)
unnamed: J11.4, U6.17 (B4)
unnamed: J12.1, U6.14 (B5)
unnamed: J12.2, U6.13 (B6)
unnamed: J12.4, U6.11 (B8)
unnamed: J14.A5 (CC1), R2.1
unnamed: J14.B5 (CC2), R1.1
unnamed: J14.A7 (DN1), J14.B7 (DN2), U2.1 (I/O1)
unnamed: J14.A6 (DP1), J14.B6 (DP2), U2.3 (I/O2)
unnamed: J24.1, U5.20 (B1)
unnamed: J24.2, U5.19 (B2)
unnamed: J24.4, U5.17 (B4)
unnamed: U1.25 (GPIO19/USB_D-), U2.6 (I/O1)
unnamed: U1.26 (GPIO20/USB_D+), U2.4 (I/O2)
unnamed: U1.33 (SPICLK), U8.6 (CLK)
unnamed: U1.32 (SPICS0), U8.1 (~CS)
unnamed: U1.35 (SPID), U8.5 (DI(IO0))
unnamed: U1.30 (SPIHD), U8.7 (IO3)
unnamed: U1.34 (SPIQ), U8.2 (DO(IO1))
unnamed: U1.31 (SPIWP), U8.3 (IO2)
unnamed: C4.1, C5.1, U1.29 (VDD_SPI), U8.8 (VCC)
unnamed: R6.2, U4.3 (~RESET)
unnamed: R13.1, U7.1 (ADDR)
unnamed: R12.2, U7.2 (ALERT/RDY)

Notes on the sheet:
Power Filtering
DIR
DC motor driver
VDDA Decoupling
VDD3P3_RTC Decoupling
Buttons
Encoders
PUL DIR OPTO ENA
Servos
Steppers
Limit Switches (Normally Open operation)
5V In
External LEDS
Crystal
External ADC

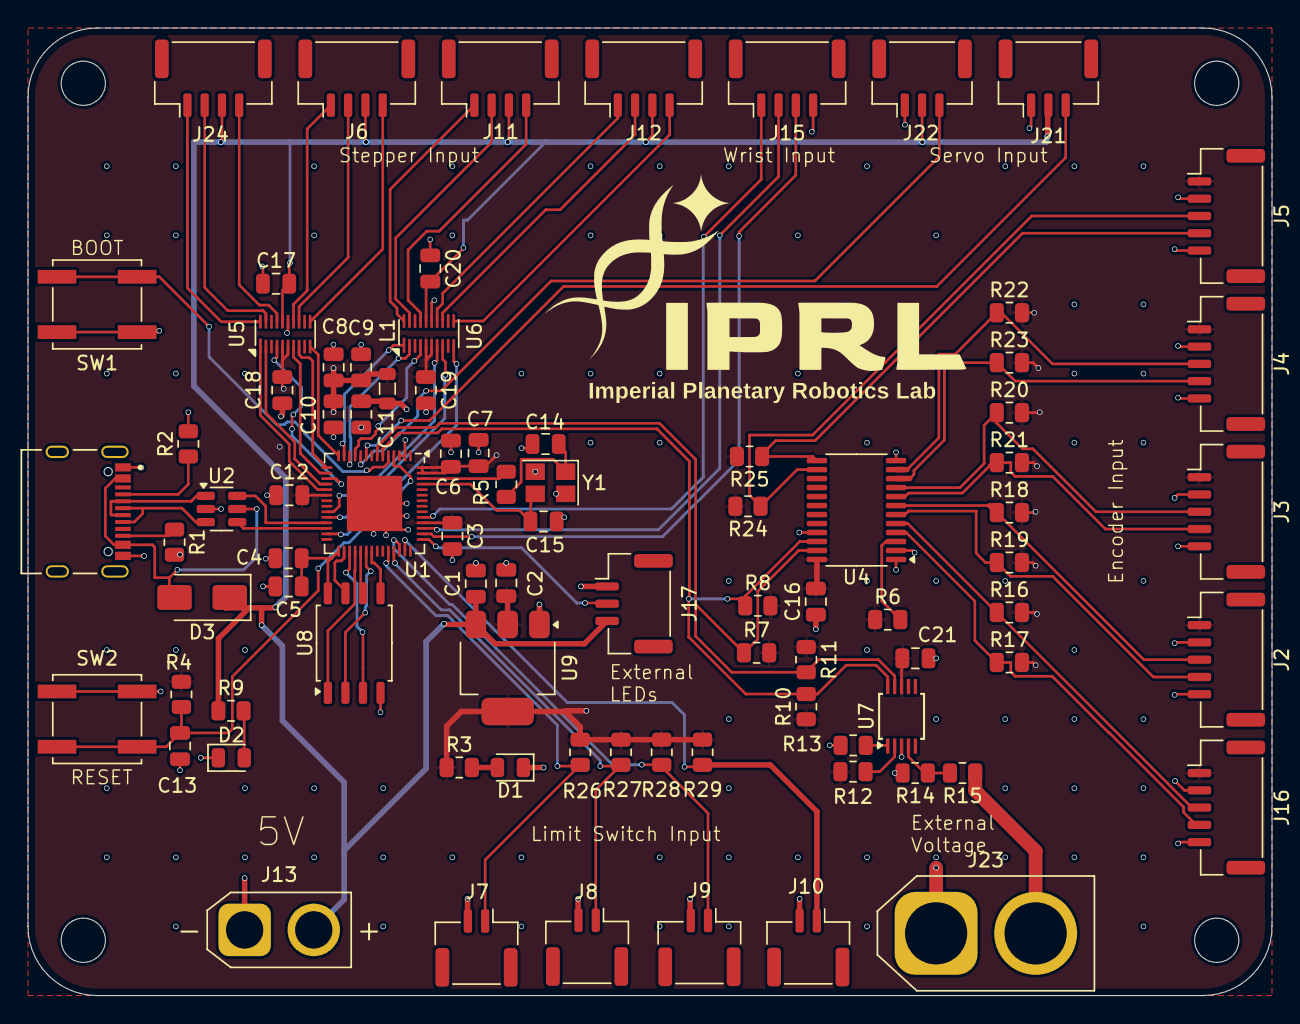
[picture p37: board Arm Schematic.kicad_pcb from above]

Board: 4 copper layers, 90.0 x 70.0 mm, 89 parts (0 on the bottom side), 76 nets.
