ICRS/IPRL-Electronics-Hardware/PCBs/DRILLTEAM/DRILLTEAM.kicad_pcb

## KiCad design PCBs/DRILLTEAM/DRILLTEAM.kicad_pcb (2025-01-17)

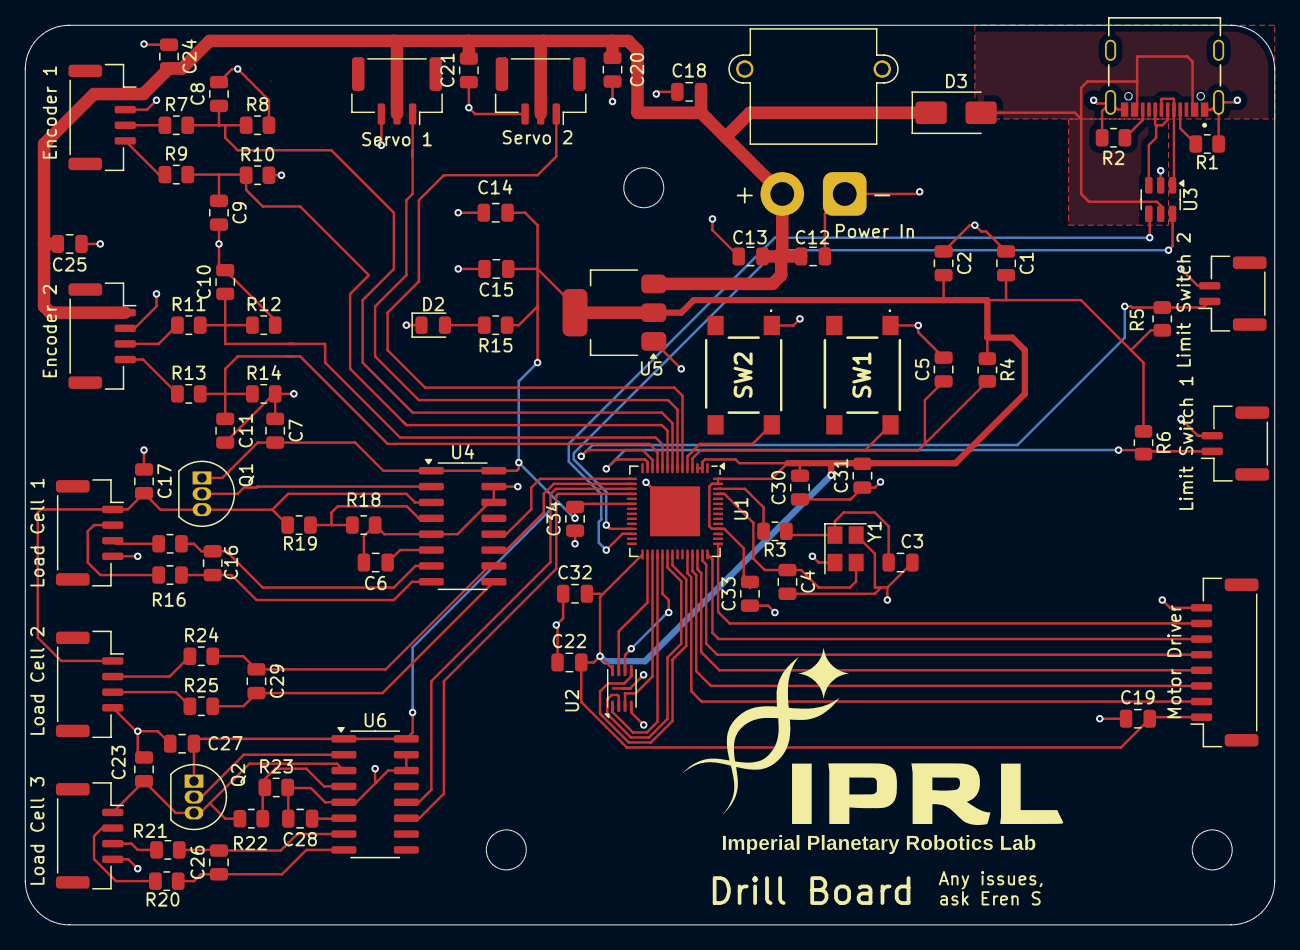
[picture p38: board DRILLTEAM.kicad_pcb from above]

Board: 2 copper layers, 100.0 x 72.0 mm, 87 parts (0 on the bottom side), 64 nets.

Parts:
C1: 10u; C_0805_2012Metric
C2, C6, C28: 0.1u; C_0805_2012Metric
C3, C4: 12p; C_0805_2012Metric
C5: 1u; C_0805_2012Metric
C7, C13, C14, C17, C18, C19, C20, C21, C23, C24, C25, C27: 10uF; C_0805_2012Metric
C8, C9, C10, C11: 10n; C_0805_2012Metric
C12, C15, C22, C30, C31, C32, C33, C34: 100nF; C_0805_2012Metric
C16, C26, C29: 0.1uF; C_0805_2012Metric
D2: LED; LED_0805_2012Metric
D3: MBRA340T3G; D_SMA
Encoder 1: Encoder 2; JST_GH_SM04B-GHS-TB_1x04-1MP_P1.25mm_Horizontal
Encoder 2: Encoder 1; JST_GH_SM04B-GHS-TB_1x04-1MP_P1.25mm_Horizontal
H1, H2, H3: MountingHole; MountingHole_3.2mm_M3
J13: TYPE-C-31-M-12
Limit Switch 1, Limit Switch 2: Conn_01x02; JST_GH_SM02B-GHS-TB_1x02-1MP_P1.25mm_Horizontal
Load Cell 1: Load Cell 1; JST_GH_SM04B-GHS-TB_1x04-1MP_P1.25mm_Horizontal
Load Cell 2: Load Cell 2; JST_GH_SM04B-GHS-TB_1x04-1MP_P1.25mm_Horizontal
Load Cell 3: Load Cell 3; JST_GH_SM04B-GHS-TB_1x04-1MP_P1.25mm_Horizontal
Motor Driver: Conn_01x08; JST_GH_SM08B-GHS-TB_1x08-1MP_P1.25mm_Horizontal
Power In: Conn_01x02; AMASS_XT30PW-M_1x02_P2.50mm_Horizontal
Q1, Q2: S8550; TO-92_Inline
R1, R2: 5K1; R_0805_2012Metric
R3: 22R; R_0805_2012Metric
R4, R5, R6: 10k; R_0805_2012Metric
R7, R9, R11, R13: 1K7; R_0805_2012Metric
R8, R10, R12, R14: 3K3; R_0805_2012Metric
R15: 1K; R_0805_2012Metric
R16, R17, R20, R21, R24, R25: 100; R_0805_2012Metric
R18, R23: 470; R_0805_2012Metric
R19, R22: 220; R_0805_2012Metric
SW1, SW2: SW_Push; PTS645SK43SMTR92LFS
Servo 1, Servo 2: Conn_01x03; JST_GH_SM03B-GHS-TB_1x03-1MP_P1.25mm_Horizontal
U1: ESP32-S3; QFN-56-1EP_7x7mm_P0.4mm_EP4x4mm
U2: W25Q16JVUXIQ_TR; Winbond_USON-8-1EP_3x2mm_P0.5mm_EP0.2x1.6mm
U3: USBLC6-2SC6; SOT-23-6
U4, U6: HX711; SOP-16_3.9x9.9mm_P1.27mm
U5: AMS1117-3.3; SOT-223-3_TabPin2
Y1: Crystal_GND24; Crystal_SMD_3225-4Pin_3.2x2.5mm

Connections:
+3.3V: C1.2, C2.2, C7.2, C14.1, C15.1, C19.2, C22.2, C27.2, C30.2, C31.2, C32.2, C33.2, C34.2, Motor Driver.1, Q1.1 (E), Q2.1 (E), R4.1, R5.1, R6.1, R15.1, U1.2 (VDD3P3), U1.3 (VDD3P3), U1.20 (VDD3P3_RTC), U1.29 (VDD_SPI), U1.46 (VDD3P3_CPU), U1.55 (VDDA), U1.56 (VDDA), U2.8 (VCC), U4.1 (VSUP), U4.16 (DVDD), U5.2 (VO), U6.1 (VSUP), U6.16 (DVDD)
+5P: C12.1, C13.1, C18.2, C20.2, C21.2, C24.2, C25.2, D3.1 (K), Encoder 1.1, Encoder 2.1, Power In.2, Servo 1.2, Servo 2.2, U5.3 (VI)
/ENC1A: C8.1, R7.2, R8.1, U1.8 (GPIO3)
/ENC1B: C9.1, R9.2, R10.1, U1.9 (GPIO4)
/ENC2A: C10.1, R11.2, R12.1, U1.10 (GPIO5)
/ENC2B: C11.1, R13.2, R14.1, U1.11 (GPIO6)
/LC1CLK: U1.16 (GPIO11), U4.11 (PD_SCK)
/LC1DT: U1.15 (GPIO10), U4.12 (DOUT)
/LC2CLK: U1.18 (GPIO13), U6.11 (PD_SCK)
/LC2DT: U1.17 (GPIO12), U6.12 (DOUT)
/LS1: Limit Switch 2.1, R5.2, U1.12 (GPIO7)
/LS2: Limit Switch 1.1, R6.2, U1.13 (GPIO8)
/M1IA: Motor Driver.3, U1.39 (GPIO34)
/M1IB: Motor Driver.4, U1.40 (GPIO35)
/M1P: Motor Driver.2, U1.38 (GPIO33)
/M2IA: Motor Driver.6, U1.42 (GPIO37)
/M2IB: Motor Driver.7, U1.43 (GPIO38)
/M2P: Motor Driver.5, U1.41 (GPIO36)
/SPICLK: U1.33 (SPICLK), U2.6 (CLK)
/SPICS0: U1.32 (SPICS0), U2.1 (~CS)
/SPID: U1.35 (SPID), U2.5 (DI(IO0))
/SPIHD: U1.30 (SPIHD), U2.7 (IO3)
/SPIQ: U1.34 (SPIQ), U2.2 (DO(IO1))
/SPIWP: U1.31 (SPIWP), U2.3 (IO2)
/Servo1: Servo 2.1, U1.6 (GPIO1)
/Servo2: Servo 1.1, U1.7 (GPIO2)
GND: C1.1, C2.1, C3.2, C4.2, C5.2, C6.2, C7.1, C8.2, C9.2, C10.2, C11.2, C12.2, C13.2, C14.2, C15.2, C17.1, C18.1, C19.1, C20.1, C21.1, C22.1, C23.1, C24.1, C25.1, C27.1, C28.2, C30.1, C31.1, C32.1, C33.1, C34.1, D2.1 (K), Encoder 1.2, Encoder 2.2, J13.A1_B12 (GND), J13.B1_A12 (GND), J13.S1 (SHIELD), J13.S2 (SHIELD), J13.S3 (SHIELD), J13.S4 (SHIELD), Limit Switch 1.2, Limit Switch 2.2, Load Cell 1.4, Load Cell 2.4, Load Cell 3.4, Motor Driver.8, Power In.1, R1.2, R2.2, R8.2, R10.2, R12.2, R14.2, R18.2, R23.2, SW1.1, SW2.1, Servo 1.3, Servo 2.3, U1.57 (GND), U2.4 (GND), U2.9 (EP), U3.2 (GND), U4.5 (AGND), U4.14 (XI), U4.15 (RATE), U5.1 (GND), U6.5 (AGND), U6.14 (XI), U6.15 (RATE), Y1.2, Y1.4
unnamed: C3.1, R3.2, Y1.1
unnamed: D2.2 (A), R15.2
unnamed: Encoder 1.3, R7.1
unnamed: Encoder 1.4, R9.1
unnamed: Encoder 2.3, R11.1
unnamed: Encoder 2.4, R13.1
unnamed: Load Cell 1.2, R16.1
unnamed: Load Cell 1.3, R17.1
unnamed: C17.2, Load Cell 1.1, Load Cell 2.1, Q1.3 (C), R19.1, U4.3 (AVDD)
unnamed: Load Cell 2.2, R24.1
unnamed: Load Cell 2.3, R25.1
unnamed: C23.2, Load Cell 3.1, Q2.3 (C), R22.1, U6.3 (AVDD)
unnamed: Load Cell 3.2, R20.1
unnamed: Load Cell 3.3, R21.1
unnamed: J13.A5 (CC1), R1.1
unnamed: J13.B5 (CC2), R2.1
unnamed: J13.A7 (DN1), J13.B7 (DN2), U3.1 (I/O1)
unnamed: J13.A6 (DP1), J13.B6 (DP2), U3.3 (I/O2)
unnamed: Q1.2 (B), U4.2 (BASE)
unnamed: Q2.2 (B), U6.2 (BASE)
unnamed: C5.1, R4.2, SW1.2, U1.4 (CHIP_PU)
unnamed: SW2.2, U1.5 (GPIO0)
unnamed: U1.25 (GPIO19/USB_D-), U3.6 (I/O1)
unnamed: U1.26 (GPIO20/USB_D+), U3.4 (I/O2)
unnamed: C4.1, U1.53 (XTAL_N), Y1.3
unnamed: R3.1, U1.54 (XTAL_P)
unnamed: C16.1, R16.2, U4.8 (INA+)
unnamed: C16.2, R17.2, U4.7 (INA-)
unnamed: C29.1, R24.2, U4.10 (INB+)
unnamed: C29.2, R25.2, U4.9 (INB-)
unnamed: C6.1, U4.6 (VBG)
unnamed: R18.1, R19.2, U4.4 (VFB)
unnamed: C26.1, R20.2, U6.8 (INA+)
unnamed: C26.2, R21.2, U6.7 (INA-)
unnamed: C28.1, U6.6 (VBG)
unnamed: R22.2, R23.1, U6.4 (VFB)
VBUS: D3.2 (A), J13.A4_B9 (VBUS), J13.B4_A9 (VBUS), U3.5 (VBUS)
