ICRS/IPRL-Electronics-Hardware/(commit log)

2024-12-20 Added KiCad files to gitignore
2025-01-15 Arm Project Uploaded
    [Arm Schematic.kicad_pcb, Arm Schematic.kicad_sch]
2025-01-15 TEST1 - added a via
    [iprld.kicad_pcb]
2025-01-15 changed adc components
    [iprld.kicad_pcb, iprld.kicad_sch]
2025-01-15 Added usb C connector
2025-01-15 New USB C footprint, changed XT inputs to male
    [iprld.kicad_pcb, iprld.kicad_sch]
2025-01-15 added connector names
    [iprld.kicad_pcb, iprld.kicad_sch]
2025-01-15 Updated Arm PCB
    [Arm Schematic.kicad_pcb, Arm Schematic.kicad_sch]
2025-01-15 final small changes - IC2 footprint
    [iprld.kicad_pcb]
2025-01-15 Fixed some DRC errors
    [iprld.kicad_pcb, iprld.kicad_sch]
2025-01-15 Minor touch ups, arm complete
    [Arm Schematic.kicad_pcb]
2025-01-15 Added labels for buttons
    [Arm Schematic.kicad_pcb]
2025-01-15 Found some issues in the drive schematic and PCB
    [iprld.kicad_pcb, iprld.kicad_sch]
2025-01-15 added more decoupling capacitors, fixed flash connections, clock capacitors, thick power traces
    [iprld.kicad_pcb, iprld.kicad_sch]
2025-01-15 fixed merge issues
    [iprld.kicad_pcb]
2025-01-15 Semi-finished PCB with updated Schematic
    [DRILLTEAM.kicad_pcb, DRILLTEAM.kicad_sch]
2025-01-16 Finished PCB sub mounting holes and fillet
    [DRILLTEAM.kicad_pcb, DRILLTEAM.kicad_sch]
2025-01-16 added potential divider for I_OUT signals
    [iprld.kicad_pcb, iprld.kicad_sch]
2025-01-16 readded Diode D1, fixed connection issue with SPID and SPIQ
    [iprld.kicad_pcb, iprld.kicad_sch]
2025-01-16 Small changes to drill PCB
    [DRILLTEAM.kicad_pcb]
2025-01-16 Switched the LDO to LM317
    [iprld.kicad_pcb, iprld.kicad_sch]
2025-01-16 Finished Drill PCB
    [DRILLTEAM.kicad_pcb, DRILLTEAM.kicad_sch]
2025-01-17 Manufacturing data created + added names to PCBs.
    [Arm Schematic.kicad_pcb, DRILLTEAM.kicad_pcb, iprld.kicad_pcb]
2025-01-21 first power schematic
    [Power_PCB.kicad_pcb, Power_PCB.kicad_sch]
2025-03-25 Completed power board
    [Connectors.kicad_sch, Current_sensing.kicad_sch, Power.kicad_sch, Power_PCB.kicad_pcb, Power_PCB.kicad_sch, untitled.kicad_sch]
2025-03-26 Second iteration power board
    [Connectors.kicad_sch, Current_sensing.kicad_sch, Power.kicad_sch, Power_PCB.kicad_pcb, Power_PCB.kicad_sch]
2025-03-27 Power board revisions
    [Power.kicad_sch, Power_PCB.kicad_pcb]
2025-03-27 Changes from meeting
    [Connectors.kicad_sch, Current_sensing.kicad_sch, Power.kicad_sch, Power_PCB.kicad_pcb, Power_PCB.kicad_sch]
2025-03-27 follow up meeting changes
    [Power.kicad_sch, Power_PCB.kicad_pcb]
2025-03-27 Meeting follow up changes
    [Power_PCB.kicad_pcb]
2025-03-27 Final copper pour
    [Power_PCB.kicad_pcb]
2025-03-29 Modified output connectors to female
    [Connectors.kicad_sch, Power.kicad_sch, Power_PCB.kicad_pcb]
2025-03-29 initial arm power commit
    [Arm power connector.kicad_pcb, Arm power connector.kicad_sch]
2025-03-30 Replaced fuse holders with 01000064Z
    [Connectors.kicad_sch, Power.kicad_sch, Power_PCB.kicad_pcb]
2025-03-30 DRC clean arm connector layout
    [Arm power connector.kicad_pcb, Arm power connector.kicad_sch]
2025-03-30 DRC clean after fuse holder replacement
    [Power_PCB.kicad_pcb]
2025-04-04 submitted power board
    [Connectors.kicad_sch, Power.kicad_sch, Power_PCB.csv, Power_PCB.kicad_pcb]
2025-04-22 Main and secondary power board V2
    [Connectors.kicad_sch, Control.kicad_sch, Power_PCB.csv, Power_V2_main.kicad_pcb, Power_V2_main.kicad_sch, Power_V2_secondary.kicad_pcb, Power_V2_secondary.kicad_sch, Protection.kicad_sch]
2025-04-23 finished secondary and beginning layout of main
    [Power_V2_main.kicad_pcb, Power_V2_secondary.kicad_pcb]
2025-04-23 shortened main board and secondary
    [Connectors.kicad_sch, Control.kicad_sch, Power_V2_main.kicad_pcb, Power_V2_main.kicad_sch, Power_V2_secondary.kicad_pcb, Power_V2_secondary.kicad_sch, Power_V2_secondary.step, Protection.kicad_sch]
2025-04-24 corrected power to main
    [Power_V2_main.kicad_pcb, Sensing.kicad_sch]
2025-05-04 main schematic for power board main
    [Connectors.kicad_sch, Control.kicad_sch, Power_V2_main.kicad_pcb, Power_V2_main.kicad_sch, Protection.kicad_sch]
2025-05-07 a 5 hour binge of PCB layout on the main
    [Connectors.kicad_sch, Control.kicad_sch, Power_V2_main.kicad_pcb, Power_V2_main.kicad_sch, Protection.kicad_sch, Sensing.kicad_sch]
2025-05-08 LEDs added to secondary
    [Power_V2_secondary.kicad_pcb, Power_V2_secondary.kicad_sch]
2025-05-09 added LED indicators to board and redid power distribution in PCIe
    [Connectors.kicad_sch, Control.kicad_sch, LED_indicators.kicad_sch, Power_V2_main.kicad_pcb, Power_V2_main.kicad_sch, Power_V2_secondary.kicad_pcb, Power_V2_secondary.kicad_sch, Protection.kicad_sch]
2025-05-12 stitching vias on secondary
    [Power_V2_main.kicad_pcb, Power_V2_secondary.kicad_pcb]
2025-05-16 added mounting holes to secondary
    [Power_V2_secondary.kicad_pcb, Power_V2_secondary.kicad_sch]
2025-05-17 modification to LED switches
    [Control.kicad_sch, LED_indicators.kicad_sch, Power_V2_main.kicad_pcb, Power_V2_main.kicad_sch, high_sided_switch.kicad_sch]
2025-05-19 follow up changes from meeting
    [Control.kicad_sch, LED_indicators.kicad_sch, Power_V2_main.kicad_pcb, Power_V2_main.kicad_sch, Power_V2_secondary.kicad_pcb, Power_V2_secondary.kicad_sch, Protection.kicad_sch, high_sided_switch.kicad_sch]
2025-05-20 Added XT60 splitter
    [XT60-Splitter.kicad_pcb, XT60-Splitter.kicad_sch]
2025-07-05 12 to 5V regulator added
    [Power_V2_secondary.kicad_pcb, Power_V2_secondary.kicad_sch]
2025-07-05 main board ordered
    [LED_indicators.kicad_sch, Power_V2_main.csv, Power_V2_main.kicad_pcb]
2025-07-06 stupid breakout board
    [Drive_breakout_connector.kicad_pcb, Drive_breakout_connector.kicad_sch]
2025-07-06 Added encoder PCB
    [encoder.kicad_pcb, encoder.kicad_sch]
2025-07-06 Added Arm Schematic V2
    [Arm Schematic V2.kicad_pcb, Arm Schematic V2.kicad_sch]
2025-07-07 Add files via upload
    new schematic, changes include
    using esp32 breakout
    magnetic encoder connectors 6x1 -> 4x1
    different fuse footprint
    capacitors are now 0805 footprint
    no optocouplers, isolation and all that came with it
    extra pin headers for spare gpios
    [New_board.kicad_sch]
2025-07-07 revised esp32 footprint
2025-07-07 drc clean arm v2
    [Arm Schematic V2.kicad_pcb, Arm Schematic V2.kicad_sch]
2025-07-07 Add files via upload
    The first try at 3rd gen drive board, with breakout esp32, no isolation and some small fixes. Note, if footprints dont work well, under schematic change footprint name from
    local:Z_ESP32_DevKitC_38pin_socket
    to
    iprl:Z_ESP32_DevKitC_38pin_socket
    [iprld.kicad_pcb, iprld.kicad_sch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]
2025-07-07 arm, drive and power modifications
    [Arm Schematic V2.kicad_pcb, Drive_breakout_connector.kicad_pcb, Power_V2_secondary.kicad_pcb, iprld.kicad_pcb, iprld.kicad_sch]
2025-07-07 fix encoder board fuck you ben
    [encoder.kicad_pcb, encoder.kicad_sch]
2025-07-07 i2c breakout correction, fuck you Maciej
    [iprld.kicad_pcb, iprld.kicad_sch]
2025-07-07 changed motor reference to 3.3v
    [iprld.kicad_sch]
2025-07-07 moved via out the pad, don't worry we like you Samuel
    [Arm Schematic V2.kicad_pcb]
2025-07-07 rounded boards David, someone could cut themselves otherwise
    [Drive_breakout_connector.kicad_pcb]
2025-07-07 David half assed the motor reference change and didnt update the layout
    [iprld.kicad_pcb, iprld.kicad_sch]
2025-07-08 drc clean boards
    [Arm Schematic V2.kicad_pcb, Drive_breakout_connector.kicad_pcb, encoder.kicad_pcb, iprld.kicad_pcb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]
2025-11-19 Create DRILLTEAMPCBV2YM
2025-12-20 Drive Board v5 (25/26 v1)
    [iprld.kicad_pcb, iprld.kicad_sch]
2025-12-21 Updated drive board
    [iprld.kicad_pcb, iprld.kicad_sch]
2025-12-21 Drive v5 changes
    [iprld.kicad_pcb, iprld.kicad_sch]
2025-12-21 Updates drive board
    [iprld.kicad_pcb, iprld.kicad_sch]
2025-12-21 Found drive board v4 still don't know if it actually ever existed or not
    :(
    [iprld.kicad_pcb, iprld.kicad_sch]
2025-12-21 Fixed drive board
    had pwm on input only pins :(
    [iprld.kicad_pcb, iprld.kicad_sch]
2025-12-21 Added termination resistor to drive
    Can be used in event that drive board is used as one end of can bus
    [iprld.kicad_pcb, iprld.kicad_sch]
2025-12-22 Added esp32 module header footprint
2026-01-18 2025 changes
    [DRILLTEAMYMchanges.kicad_pcb, DRILLTEAMYMchanges.kicad_sch]
2026-01-19 Arm V3 Schematic
    [Arm_Board_v3.kicad_pcb, Arm_Board_v3.kicad_sch]
2026-02-01 Finished arm pcb
    [Arm_Board_v3.kicad_pcb, Arm_Board_v3.kicad_sch]
2026-02-05 Drive Board V6
    Added for IMU thanks nav :(
    [iprld.kicad_pcb, iprld.kicad_sch]
2026-02-05 Fixed servo pin and added labels
    [Arm_Board_v3.kicad_pcb, Arm_Board_v3.kicad_sch]
